pascalguttmann/obat/docs/design/esu/esu.md

# Emergency Stop Unit (ESU)

The Emergency Stop Unit (ESU) is responsible to disconnect the battery from the
power supply unit in the case that specified operating conditions are violated.
The ESU should not rely in software to disconnect the battery from the power
supply. Analog circuitry for example with a logic family like `74xx` or others
is possible.
It uses 0V to 5V inputs from the measurement transducer to evaluate when to
disconnect the battery.

## Requirements and Interface to other Components

The following picture gives an example for a schematic overview of the ESU for better
understanding. It is not part of the specification. Textual requirements are
always of precedence. The implemented architecture can be altered as required.

!!! note
    The diagram shows the usage of analog isolation. But the use of digital
    isolation might be more feasible. For that the entire comparison circuitry can
    be isolated by employing a isolated DC/DC converter and a digital isolation IC.
    This will probably be more cost effective and not impose accuracy constraints
    of the analog isolation.

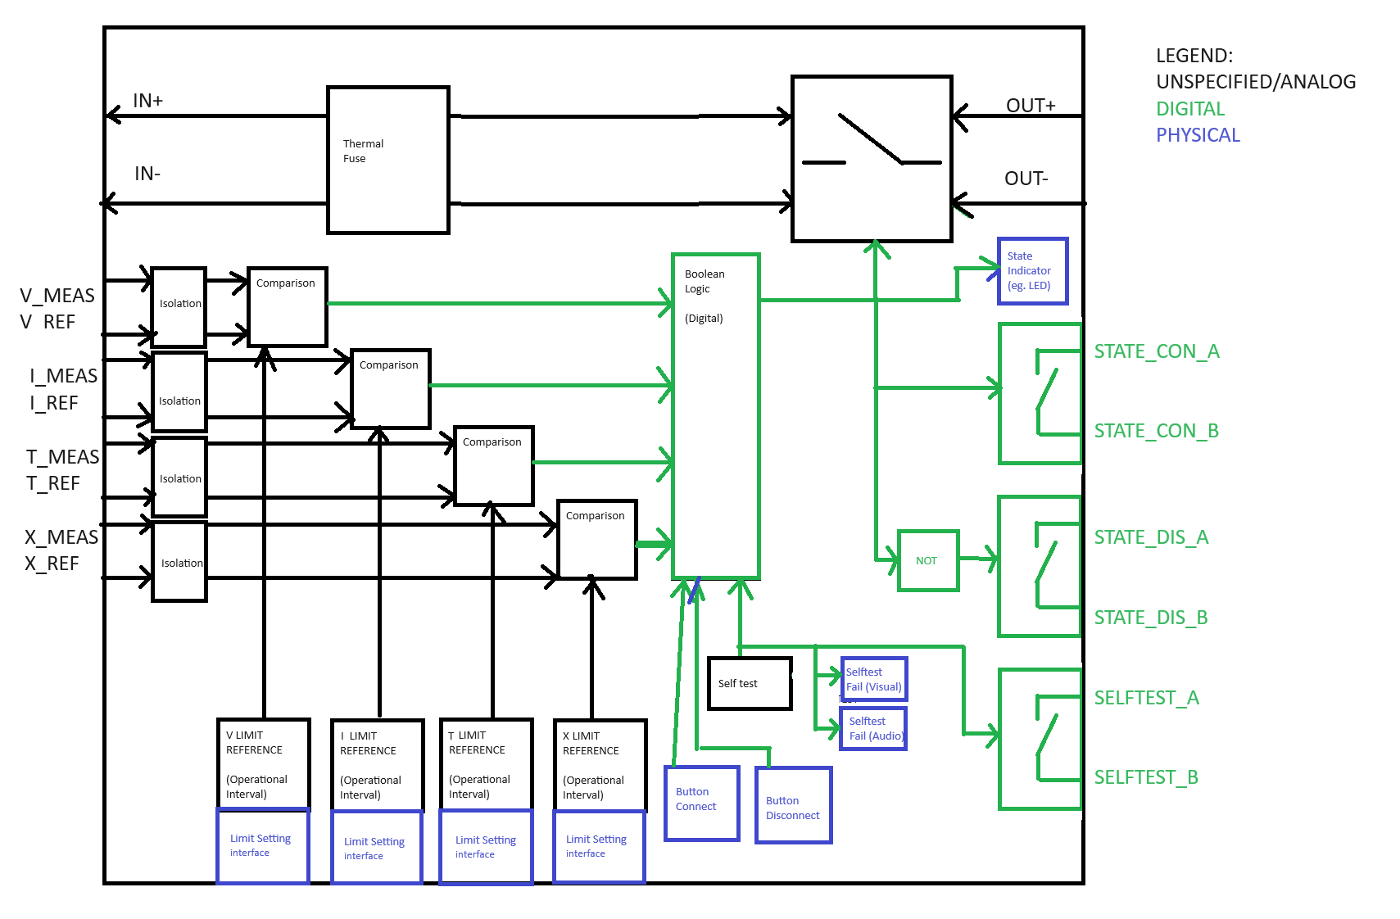
[picture p2: docs/design/esu/img/esu.png]
ESU Overview Schematic


### Interfaces

- [ ] The ESU shall have the following connection:
    - [ ] OUT+
    - [ ] OUT-
    - [ ] IN+
    - [ ] IN-
    - [ ] V_MEAS
    - [ ] V_REF
    - [ ] I_MEAS
    - [ ] I_REF
    - [ ] T_MEAS
    - [ ] T_REF
    - [ ] X_MEAS
    - [ ] X_REF
    - [ ] SELFTEST_A
    - [ ] SELFTEST_B
    - [ ] STATE_CON_A
    - [ ] STATE_CON_B
    - [ ] STATE_DIS_A
    - [ ] STATE_DIS_B
- [ ] Additionally, the ESU might have a power connection.
- [ ] The ESU shall have the following user interfaces:
    - [ ] Button `connect`
    - [ ] Button `disconnect`
    - [ ] Limit set `V_LOW`
    - [ ] Limit set `V_HIGH`
    - [ ] Limit set `I_LOW`
    - [ ] Limit set `I_HIGH`
    - [ ] Limit set `T_LOW`
    - [ ] Limit set `T_HIGH`
    - [ ] Limit set `X_LOW`
    - [ ] Limit set `X_HIGH`
    - [ ] State Indicator `connected` (for example LED)
    - [ ] Visual Indicator `FAIL_SELFTEST_VIS` (for example LED)
    - [ ] Audible Indicator `FAIL_SELFTEST_AUD` (for example Piezobuzzer)

!!! info
    The `X` connection is at the moment unused, but is included for the ability
    to extend the ESU unit in the future. Is must fulfill the same
    specifications as the `V`, `I` and `T` measurements.
    A possible use case is the initialization to perform a disconnect by
    software from the main PC in obat.

!!! info
    The connections `I_MEAS` and `I_REF` shall be used with a transducer, which
    transduces a measured current into a voltage, that is usable by the ESU.
    The ESU must integrate a transducer either on the PCB or as an external
    component.
    A transducer for the temperature measurement is provided externally.

### States

- [ ] The state of the ESU is `connected` if `IN+` is galvanic connected
    to `OUT+` and `IN-` is galvanic connected to `OUT-`.
- [ ] The state of the ESU is `disconnected`if `IN+` is galvanic
    disconnected from `OUT+` and `IN-` is galvanic disconnected from `OUT-`.
- [ ] It must be ensured by hardware (for example a relay with multiple
    contacts), that the ESU is always either in `connected` or `disconnected`
    state.
- [ ] The connections `OUT+`, `OUT-`, `IN+` and `IN-` must be isolated from all
    other terminals and electronics in ESU.
- [ ] The state after power on must be `disconnected`.
- [ ] If and only if the state is `connected`
    - [ ] the state indicator `connected` must indicate, that the state is
        `connected`.
    - [ ] the connections `STATE_CON_A` and `STATE_CON_B` must be galvanic
        connected with $Z < 1 \Omega$.
    - [ ] the connections `STATE_DIS_A` and `STATE_DIS_B` must be galvanic
        isolated with $Z > 1M \Omega$.
- [ ] If and only if the state is `disconnected`
    - [ ] the state indicator `connected` must NOT indicate, to show that the
        state is `disconnected`.
    - [ ] the connections `STATE_DIS_A` and `STATE_DIS_B` must be galvanic
        connected with $Z < 1 \Omega$.
    - [ ] the connections `STATE_CON_A` and `STATE_CON_B` must be galvanic
        isolated with $Z > 1M \Omega$.

### State Transitions

- [ ] The ESU shall transition from `disconnected` to `connected` state if and
    only if the following criteria are met:
    - physical button `connect` is pressed
    - the ESU is able to transition back to the `disconnected` state at any time
        after the `connected` state is entered. (for example The energy storage
        to switch of is charged.)
    - The selftest is passed
    - all `input voltages` of the measured quantities (voltage, current,
        temperature) are in the `operation interval`.

- [ ] The ESU shall transition from `connected` to `disconnected` state if the
    physical button `disconnect`is pressed.
- [ ] If a power fail occurs the ESU must switch to the `disconnected` state.
    (Therefore the ESU must store enough energy to transition to the
    `disconnected` state, when the main power is not available.)
- [ ] The buttons `connect` and `disconnect` must be momentary and return by
    itself to the original position if not pressed.

- [ ] The ESU must transition from `connected` to `disconnected` state if one or
    more of the following criteria are met:
    - [ ] The measured voltage is not in the `operation interval`.
    - [ ] The measured current is not in the `operation interval`.
    - [ ] The measured temperature is not in the `operation interval`.
    - [ ] The measured X voltage is not in the `operation interval`.

- [ ] The connections `*_MEAS` and `*_REF` shall form pairs, in which the
    `*_REF` connection acts as the reference for the electric potential, and
    `*_MEAS` is a voltage in the interval  [`*_MEAS`, `*_MEAS`+5V].

    !!! info
        The voltage from `*_MEAS` to `*_REF` is the `input voltage` for the
        given measured quantity (voltage, current, temperature, X at battery).

    - [ ] The pairs must be galvanic isolated from all other connections of the
        ESU. (for example by using an optocoupler). With an impedance
        $Z > 1M \Omega$.
    - [ ] The differential input impedance must be $Z_{diff} > 1M \Omega$
- [ ] The ESU shall have for each measurement input pair internally the `limits`
    - `*_LOW`
    - `*_HIGH`
- [ ] The interval [`*_LOW`, `*_HIGH`] is the `operating
    interval` for the corresponding measured quantity (voltage, current,
    temperature, X).
- [ ] The `limits` must be constant during operation.
- [ ] The `limits` shall be physically adjustable independent of each other.
    (E.g with a potentiometer).
- [ ] The transition to the `disconnect` state must be of higher precedence than
    the transition to the `connected` state. If criteria for both transitions
    are met, the transition to the `disconnected` state must be performed.
- [ ] A connection disruption must **not** trigger a transition to the
    `connected` state.
- [ ] A connection disruption must trigger a transition to the `disconnected`
    state if the connection disruption inhibits the defined transitions to the
    `disconnected` state.

### Other

- [ ] The operation of the ESU must not depend software execution.
    - [ ] Software must not be able to influence the internal `limits` or
        perform a transition to the `connected` state.
- [ ] On startup the ESU must perform a selftest. The selftest must check, that
    the ESU is able to perform the transition from `connected` to
    `disconnected` state.
- [ ] During the selftest, the state must not be changed to `connected`. (for
    example a secondary relay can be used.
- [ ] If the selftest is not passed
    - [ ] the visual indicator `FAIL_SELFTEST_VIS` shall activate
    - [ ] the audible indicator `FAIL_SELFTEST_AUD` shall activate
    - [ ] the connections `SELFTEST_A` and `SELFTEST_B` must be galvanic
        isolated with $Z > 1M \Omega$.
- [ ] If the selftest is passed
    - [ ] the visual indicator `FAIL_SELFTEST_VIS` shall deactivate
    - [ ] the audible indicator `FAIL_SELFTEST_AUD` shall deactivate
    - [ ] the connections `SELFTEST_A` and `SELFTEST_B` shall be galvanic
    - connected with $Z < 1 \Omega$.  [ ] Following connections must be galvanic
        isolated from all other connections with $Z > 1M \Omega$.
    - [ ] `SELFTEST_A` and `SELFTEST_B`
    - [ ] `STATE_CON_A` and `STATE_CON_B`
    - [ ] `STATE_DIS_A` and `STATE_DIS_B`
- [ ] The ESU must be able to break currents up to $I_{break} = 50A$.
- [ ] The ESU shall contain a thermal fuse which will break the connection
    between the two corresponding connections, if the current exceeds
    $I_{break}$ between the connections:
    - `IN+` and `OUT+`
    - `IN-` and `OUT-`

## Internals

- TTL or CMOS logic ?
- Bi- or Monostable relay? Redundancy of relay?
- Redundancy? on level of electronics? or entire ESU duplicated?
- Setting process? Process to set the desired internal limits.
- use same voltage level as other components
