pascalguttmann/obat/docs/design/pss/conf/conf.md

# Configuration

TODO: Add 100 Ohm / 470 pF at output to increase 10-90 rise time to approx
$2.2RC = 100ns$. (Clock inverter line)

TODO: Fix wrong connection in schematic and pcb for `conf_ok` (U402, switch pins 2 and 13)
The refselect_v & limits_i (and vice versa: refselect_i & limits_v) must be combined.

!!! info "Configuration Options"
    To obtain information, which DAC channels configures which feature please
    see [`./channel_map.md`](./channel_map.md).

!!! warning "AD5672R"
    To daisy chain AD5672R it is necessary to be able to transfer 24-bit data
    into the device with a *single* spi transfer. This is required to enable
    daisychain mode. Before daisychain mode is enabled only the first 24-bit of
    each transfer are used.
    This can be achieved by prepending a 24-bit shift register in front of the
    first AD5672R in the chain of consecutive AD5672R. (Setting data into the
    shift register with longer transfer, followed by a 24-bit transfer).
    For detailed technical background please refer to:
    [`./sw/pc/obat_pc_spi/device_implementation/dac/ad5672/functional_operations.py`](https://github.com/pascalguttmann/obat_pc_spi/blob/main/device_implementation/dac/ad5672/functional_operations.py)

## Interface & Requirements

1. SPI Input Interface
    - digital with $U \in [0V, 5V]$
        - `!CS`, input, chip select, low active
        - `SCLK`, input, serial clock CPHA=0, CPOL=0=`SCKL`
        - `SDI`, input, serial data in
        - `SDO`, output, serial data out
2. Voltage output
    - analog with $U \in [0V, 5V]$ with $R < 100 \Omega \forall I < 1mA$
    - analog with $U \in [0V, 5V]$ with $R < 200m \Omega \forall I < 20mA$
        - `conf_vref`, signal of configured reference voltage
        - `conf_iref`, signal of configured reference current
        - `conf_lcl`, signal of configured lower current limit
        - `conf_ucl`, signal of configured upper current limit
        - `conf_lvl`, signal of configured lower voltage limit
        - `conf_uvl`, signal of configured upper voltage limit
    - digital positive logic with $U \in [-5V, 10V]$, driving up to $I = 1 mA$
    load
        - `conf_refselect_v`, signal that the desired reference is voltage
        - `conf_refselect_i`, signal that the desired reference is current
        - `conf_ok`, signal that the configured signals are consistent
    - digital negative logic with $U \in [-5V, 10V]$, driving up to $I = 1 mA$
    load
        - `!relay_connect`, connect relay output
3. Supply Voltages
    - $+10V$ @ $100mW$ ($10mA$)
    - $-5V$ @ $50mW$ ($10mA$)
    - $+5VA$ @ $250mW$ ($40mA$)

## Circuit Selection and Design

The `conf` sub circuit is used to convert digital serial commands from the `pc`
to analog or digital signals, which are all present in parallel so they can be
accessed by the circuits of the `pss`.

### Circuit

The `conf` sub circuit utilizes a 12-bit digital to analog converter with 8
channels and SPI interface to produce the desired analog signals. The digital
signals are obtained by limiting the allowable configuration range of the
corersponding channels to the maximum and minimum value of the analog
conversion range. Those signals have a range of $U \in [0V, 5V]$ at the DAC
output, but shall be converted to $U \in [-5V, 10V]$ for compatibility with
other sub circuits. The conversion is performed by applying level shifting with
two transistors as amplifiers in emitter configuration.

#### Level Shifter

The emitter configurations of the level shifter each perform a level shift of
one of two voltage levels. The first stage shifts from $U_0 \in [0V, 5V]$ to
$U_1 \in [0V, 10V]$ and the second stage shifts from $U_1$ to $U_2 \in [-5V,
10V]$.

The collector resistances are calculated to allow an appoximate quiescant
currentflow of $I_q \approx 1mA$ during maximal voltage swing $U_{max}$.
$$ R_C = \frac{U_{max}}{I_q} $$

The base resistance is calculated with a large signal current gain of $\beta
\approx 100$, which already includes overdriving of the transistor into
saturation. The voltage is given by the preceeding stage $U_{on}$.
$$ R_B = \frac{U_{on} \beta}{I_q} $$

A pull down resistance of $R = 1 M \Omega$ is added at the input of the first
stage to define the output voltage, in case the DAC output is in tri-state.

#### Config Checker

The programmed configuration is checked for its correctness by the `conf` sub
circuit. A correct configuration is indicated by the `conf_ok` signal. The
correctness of the configuration is determined by:

- If the selected reference is voltage `conf_refselect_v`
    - The upper current limit `ucl` must be greater than the lower current
    limit `lcl`
- If the selected reference is current `conf_refselect_i`
    - The upper voltage limit `uvl` must be greater than the lower voltage
    limit `lvl`

The analog comparison is perfomed by an operational amplifier, which is used as
a comparator. No hysteresis is used, but footprints are provided to place
resistances for a additional hysteresis if required later on.

#### Relay Connect Masking

If the programmed configuration is evaluated as correct and therefore `conf_ok`
is set, the configured state of the output relay `conf_output` is forwarded to
the `relay` sub circuit. If the configuration is not correct, the `relay` sub
circuit is signaled to disconnect. The logic is implemented using a NAND gate.
$$ \text{!relay_connect} = \overline{\text{conf_ok} \land \text{conf_output}} $$

#### Visual Indication

A low power led is used at the general purpose output for debugging purposes. A
current of $I_f \approx 500 \mu A$ is set by the series resistance in order to
not exceed the pins output current specification.

### Component Selection

#### DAC

Search on Mouser for: [AD5672RBRUZ](https://mou.sr/419AKxw)

- DAC, Voltage Buffered Output
- 8 channels
- Resolution >= 2 bit
- Interface: SPI
- Package: SMD (hand solderable)
- sort by price

#### Transistors

Transistors for the level shifter are reused from the bias stage to reduce
overall number of components.

#### Opamp / Comparator

Opamp is reused from window comparator in order to reduce number of components
and replicate specification of window-comparator opamp as good as possible.

#### Logic Gates

Appropriate Logic Gates are selected from the 4000B series of CMOS logic gates.

## Simulation

Simulation example can be found in `./sim_conf.asc`.
hierarchical simulation block is available as `./conf.asc` and
`./conf.asy`.

SPI interface is not simulated. DAC is simulated as 8 voltage sources.

## Hardware tests in Laboratory

## Layout and Assembly Considerations

### PCB Layout

- Pull up/down for inputs, when stage is isolated, to run other tests.
- Test pins for
    - all DAC outputs
    - `!limits_ok_v`, `!limits_ok_i`
    - `conf_refselect_vshift`, `conf_output_vshift`
    - `conf_ok`, `!relay_connect`
- disconnector for
    - `conf_output_dac` to level shifer input
    - `conf_refselect_dac` to level shifer input

### Assembly

## Commissioning and Testing

1. Pass tests
    - Test ID: `v1.0.0/pss/conf/level-shifter/low/*`
    - Test ID: `v1.0.0/pss/conf/level-shifter/high/*`
2. Connect level-shifter with solder jumper
3. Pass tests
    - Test ID: `v1.0.0/pss/conf/dac/conf-ok`

### Level Shifter Low

Test ID: `v1.0.0/pss/conf/level-shifter/low/<suffix>`

Available suffix: `output`, `refselect`

1. Connections
    - Input of level shifer `suffix` disconnected
2. Power on supply voltage
3. Measure Voltages
    - $U_{shift}$ at net `conf_<suffix>_vshift`
5. Power off supply voltage
6. Test passed if
    - $U_{shift} < -3V$

### Level Shifter High

Test ID: `v1.0.0/pss/conf/level-shifter/high/<suffix>`

Available suffix: `output`, `refselect`

1. Connections
    - Input of level shifer `suffix` connected to $U = 5V$
2. Power on supply voltage
3. Measure Voltages
    - $U_{shift}$ at net `conf_<suffix>_vshift`
5. Power off supply voltage
6. Test passed if
    - $U_{shift} > 8V$

### DAC - Conf Ok

Test ID: `v1.0.0/pss/conf/dac/conf-ok`

1. Power on supply voltage
2. Configure DAC with
    - Channel 0: 0xFFF
    - Channel 1: 0x000
    - Channel 2: 0x800
    - Channel 3: 0x800
    - Channel 4: 0x100
    - Channel 5: 0xE00
    - Channel 6: 0xE00
    - Channel 7: 0x100
3. Measure
    - $U_{conf_ok}$
    - $U_{!relay_connect}$
4. Power off supply voltage
5. Test passed if
    - $U_{conf_ok} > 8V$
    - $U_{!relay_connect} < -3V$

### DAC - Conf Not Ok

Test ID: `v1.0.0/pss/conf/dac/conf-not-ok`

1. Power on supply voltage
2. Configure DAC with
    - Channel 0: 0xFFF
    - Channel 1: 0xFFF
    - Channel 2: 0x800
    - Channel 3: 0x800
    - Channel 4: 0x100
    - Channel 5: 0xE00
    - Channel 6: 0xE00
    - Channel 7: 0x100
3. Measure
    - $U_{conf_ok}$
    - $U_{!relay_connect}$
4. Power off supply voltage
5. Test passed if
    - $U_{conf_ok} < -3$
    - $U_{!relay_connect} > 8V$
