pascalguttmann/obat/docs/design/pss/mux/mux.md

# Multiplexer

## Interface & Requirements

1. Voltage inputs
    - analog with $U \in [0V, 5V]$ with $R < 100 \Omega \forall I < 3mA$
        - `conf_vref`, signal of configured reference voltage
        - `conf_iref`, signal of configured reference current
        - `conf_lcl`, signal of configured lower current limit
        - `conf_ucl`, signal of configured upper current limit
        - `conf_lvl`, signal of configured lower voltage limit
        - `conf_uvl`, signal of configured upper voltage limit
        - `meas_out_v`, signal of measured output voltage
        - `meas_out_i`, signal of measured output current
    - digital positive logic with $U \in [-5V, 10V]$, driving up to $I = 1 mA$
    load
        - `mode_vc`, voltage control
        - `mode_lclc`, lower current limit control
        - `mode_uclc`, upper current limit control
        - `mode_cc`, current control
        - `mode_lvlc`, lower voltage level control
        - `mode_uvlc`, upper voltage level control
2. Voltage output
    - analog with $U \in [0V, 5V]$ with $R < 350 \Omega \forall I < 3mA$
        - `mux_ref`, multiplexer reference output
        - `mux_meas`, multiplexer measurement output
3. Supply Voltages
    - $+10V$ @ $500 \mu W$ ($50 \mu A$)
    - $-5V$ @ $250 \mu W$ ($50 \mu A$)

## Circuit Selection and Design

The multiplexer is used to connect one of the given reference signals to the
reference output and one of the measured signals to the measurement output. The
selection of the required connections is performed by the digital `mode_*`
signals. Because multiple modes use the same measured signal an OR-Gate is used
to connect the measured signal for each of the modes in question.

### Circuit

The switching is performed using a analog bidirectional switch, because the
switching time is fast an reasonable low on resistance can be achieved.
Additionally the switching does not reduce the lifetime of the device as it
would be the case for a mechanical switch like a relay.
Because multiple switches could be closed at the same instance of time, if a
gapping switching behavior is desired, the selection of the modes should also
be implemented in a gapping manner. This can be used to avoid connecting
multiple low resistance sources at the multiplexers input.

### Component Selection

#### Analog Bidirectional Switch

[CD4066BM96] Selection (sort by Price): 4x SPST, SMD, 15V VCC,
$R_{on} <= 250 \Omega$

[CD4066BM96]: https://mou.sr/3MQOnJI

#### OR-Gate

Reuse of already implemented three input or gate from `mode-transition`

## Simulation

Simulation example can be found in `./sim_mux.asc`.
Hierarchical simulation block is available as `./mux.asc` and `./mux.asy`.

## Hardware tests in Laboratory

## Layout and Assembly Considerations

### PCB Layout

- Test pins for
    - each individual mode
    - each input and output

### Assembly

## Commissioning and Testing

### On - resistance

Test ID: `v1.0.0/pss/mux/on-resistance/<suffix>`

Available suffixes: `mode_vc`, `mode_lclc`, `mode_uclc`, `mode_cc`,
`mode_lvlc`, `mode_uvlc`

1. Connections
    - Input for `<suffix>` connected to $U_{in} = 10V$
2. Power on supply voltage
3. Measure Resistance
    1. $R_{ref}$ between `conf_*` of mode and `mux_ref`
    2. $R_{meas}$ between `meas_*` of mode and `mux_meas`
4. Power off supply voltage
5. Test passed if
    1. $R_{ref} < 250 \Omega$
    2. $R_{meas} < 250 \Omega$

### Off - resistance

Test ID: `v2.0.0/pss/mux/off-resistance/<suffix>`

Available suffixes: `mode_vc`, `mode_lclc`, `mode_uclc`, `mode_cc`,
`mode_lvlc`, `mode_uvlc`

1. Connections
    - Input for `<suffix>` connected to $U_{in} = -5V$
2. Power on supply voltage
3. Measure Resistance
    1. $R_{ref}$ between `conf_*` of mode and `mux_ref`
    2. $R_{meas}$ between `meas_*` of mode and `mux_meas`
4. Power off supply voltage
5. Test passed if
    1. $R_{ref} > 10k \Omega$
    2. $R_{meas} > 10k \Omega$
