pascalguttmann/obat/docs/instance_1/pss/power-electronics/power-electronics.md

# Power Electronics

## Tests

### Transfer

| Test ID | Status | Measured |
| :--- | --- | :--- |
| `v1.0.0/pss/power-electronics/transfer`| pass | $U_{1} = +2.38 V$, $U_{2} = +3.37 V$ |
