pascalguttmann/obat/docs/design/pss/limit-logic/compare-logic/window-comparator/window-comparator.md

# Window Comparator

## Interface & Requirements

1. Voltage inputs
    - analog with $U \in [0V, 5V]$ with $R < 1 \Omega \forall I < 1mA$
        - `ul` upper limit
        - `ll` lower limit
    - analog with $U \in [0V, 5V]$ with $R < 10 \Omega \forall I < 250\mu A$
        - `meas` measured quantity
2. Voltage output
    - digital positive logic with $U \in [-5V, 10V]$, driving up to $I = 1 mA$
    load
        - `ule` upper limit exceeded
        - `!lle` not lower limit exceeded
3. Supply Voltages
    - $+10V$ @ $20mW$ ($2mA$)
    - $-5V$ @ $10mW$ ($2mA$)

## Circuit Selection and Design

The window-comparator can be used to check, whether a measured signal `meas` is
inside a window defined by a lower limit `ll` and an upper limit `ul`. If the
measured signal is outside of the defined window the corresponding digital
output signals that the window limits are exceeded with the signals `lle`
(lower limit exceeded) and `ule` (upper limit exceeded).

- $\text{meas} > \text{ul} \implies \text{ule}$
- $\text{meas} < \text{ll} \implies \text{lle}$

A small offset is added to the configured limits increasing/decreasing
`ul`/`ll` to allow the use with a single limit for both the upper limit and
lower limit and still generate a well-defined window.
Therefore the window-comparator can be used to check if a two voltages are
approximately equal.

### Circuit

The offset added to the limits should generate a window approximately
$U_{window} \approx 5mV$. To add the offset voltage a voltage divider is
chosen. The usage of the depicted voltage divider will not always assure a
_symmetric_ window around the given limit signal, but will maintain a constant
width of the window. For a high limit signal close to 5V the limit signal will
get closer to the upper bound of the window, but further from the lower bound
of the window, and vice versa. In order to ease computation the calculations
are performed for a centered _symmetric_ window at $U_{ul} = U_{ll} = 2.5V$.
The addition of an offset for a single of the two limits should therefore be
$U_{offset} \approx 2.5mV$. When using the supply voltages at $U_{+} = 10V$ and
$U_{-} = -5V$ a voltage drop of $7.5V$ across the voltage divider is present.
For a quiescent current of $I_q \approx 75 \mu A$ at $7.5V$ across the voltage
divider a total resistance of
$$ R_1 + R_2 = \frac{7.5V}{75 \mu A} \approx 100k \Omega $$
is chosen. For the maximum and minimum value of the limit signal the quiescent
current will therefore be an element of $I_q \in [50 \mu A, 100 \mu A] >
I_{comp,in}$ and considerably larger than the input current of the comparator,
which can therefore be neglected. With a ratio of the resistances defined by
the desired offset the following resistances can be obtained:
$$ \frac{R_1 + R_2}{R_2} = \frac{7.5V}{2.5mV} \implies R_1 \approx 100k \Omega
\land R_2 \approx 33 \Omega $$

!!! note "Prototype Adjustment"
    Feedback from Professor Spiegelberg suggested to use a trimmer in order to
    easily change the window size without desoldering of resistors during
    prototype stage of the power supply sink. To achieve the adjustment a $R =
    1k \Omega$ trimmer is connected in series with a $R = 22 \Omega$
    resistance$.

The tolerance of the offset addition due to tolerances and the offset voltage
of the comparator should not allow for the window size to shrink below
$U_{window} < 0V$. For a tolerance of $1\%$ of the resistances the tolerance of
the tolerance of the offset voltage can be approximated:
$$ \frac{\Delta U_{offset}}{U_{voltage divider}} \approx \Delta R_1
\frac{d}{dR_1} \frac{R_2}{R_1 + R_2} + \Delta R_2 \frac{d}{dR_2} \frac{R_2}{R_1
+ R_2} $$
Using $\Delta R_i = \pm R_i \cdot 0.01 \land U_{voltage divider} = 7.5V$ the
tolerance of the offset voltage can be estimated to not exceed:
$$ |\Delta U_{offset}| \leq \left|\frac{-2 \cdot 0.01 R_1 R_2}{(R_1 + R_2)^2}
\cdot U_{voltage divider}\right| \approx 50 \mu V $$

Therefore the input offset voltage of the comparator shall not exceed
$U_{off,in} < 2.5mV - 50 \mu V$, but can be chosen smaller to increase the
accuracy of the comparator.

To add a hysteresis of $U_{hist} \big|_{U_{ll} = U_{ul} = 2.5V} \approx 1mV$.
Positive feedback can be used to create a Schmitt-trigger. This can be achieved
by selecting $R_5 + R_7 \lessapprox 1M \Omega$ to allow for a large enough
quiescent current to neglect the comparator input current. And selecting a
large $R_5$ to neglect parasitic resistances. With $\frac{R_7}{R_5} =
\frac{7.5V}{1mV}$ the following resistances can be selected:
$$ R_7 = 1M\Omega \land R_5 = 130 \Omega $$

!!! note "Schmitt-Trigger"
    Feedback from Professor Spiegelberg suggested to omit the usage of a
    Schmitt-Trigger due to the high resistance ratio and small hysteresis. The
    resistors are not populated on the PCB or connected via $0\Omega$ jumpers
    to retain the possibility of later adaptation without requiring a change of
    the PCB.

### Component Selection

#### Comparator / Opamp

[TLV9352](https://mou.sr/3BJsKZm)

- 2 or 4 channels
- SMD Mount, SOIC preferred
- rail-to-rail preferred
- $\text{SR} > 5V / \mu s$
- $V_{off} \leq 1mV$
- $I_{bias, in} \leq 1nA$ (To allow neglect of input current for high feedback resistance)
- $I_{out} \geq 20mA$
- Price sort on Mouser

#### Trimmer

[PVG5H102C03B00](https://mou.sr/4957wSw)

- $R = 1k \Omega$
- Linear Taper
- SMD Mounting
- $n_{turns} > 10$
- Sort by Price on Mouser

## Simulation

Simulation example can be found in `./sim_window-comparator.asc`.
Hierarchical simulation block is available as `./window-comparator.asc` and
`./window-comparator.asy`.

## Hardware tests in Laboratory

## Layout and Assembly Considerations

### PCB Layout

- Test pins for `ul`, `ll`, `meas`, `ule`, `lle`
- Test pins for Pins 1 and 3 of trimmers for resistance measurement

### Assembly

- Turn trimmer counter clockwise until resistance is zero for initial usage.
  (Max 11 turns required)

## Commissioning and Testing

1. Pass tests for `window-comparator`

### Upper Voltage Limit

Test ID: `v1.0.0/pss/limit-logic/window-comparator/upper-voltage-limit`

1. Connections
    - Input `meas` of the window-comparator $U=5V$
    - Input `ul` and `ll` of the window-comparator $U=0V$
2. Power on supply voltage
3. Measure Voltages
    - $V_{ule}$ at net `ule` of the window-comparator
    - $V_{!lle}$ at net `!lle` of the window-comparator
4. Power off supply voltage
5. Test passed if
    - $V_{ule} > 8V$ at net `ule` of the window-comparator
    - $V_{!lle} > 8V$ at net `!lle` of the window-comparator

### Lower Voltage Limit

Test ID: `v1.0.0/pss/limit-logic/window-comparator/lower-voltage-limit`

1. Connections
    - Input `meas` of the window-comparator $U=0V$
    - Input `ul` and `ll` of the window-comparator $U=5V$
2. Power on supply voltage
3. Measure Voltages
    - $V_{ule}$ at net `ule` of the window-comparator
    - $V_{!lle}$ at net `!lle` of the window-comparator
4. Power off supply voltage
5. Test passed if
    - $V_{ule} < -3V$ at net `ule` of the window-comparator
    - $V_{!lle} < -3V$ at net `!lle` of the window-comparator
