pascalguttmann/obat/docs/instance_1/instance_1.md

# Instance \#1

This is the documentation page for the first instance created of obat, which is
currently used by the HFU.



|   |  |
| --- | --- |
|   |  |
