pascalguttmann/obat/docs/instance_1/enclosure/dac/dac.md

# Digital-Analog-Converter

## Tests

### DAC - Conf Ok

| Test ID | Status | Measured |
| :--- | --- | :--- |
| `v1.0.0/enclosure/conf/dac/conf-ok` | pass | $U_{ch,0} = 3.996 V$, $U_{ch,1} = 3.996 V$, $U_{ch,2} = 3.997 V$, $U_{ch,3} = 3.997 V$, $U_{ch,4} = 3.996 V$, $U_{ch,5} = 3.996 V$, $U_{ch,6} = 3.995 V$, $U_{ch,7} = 3.996 V$ |
