pascalguttmann/obat/docs/instance_1/enclosure/full-bridge/full-bridge.md

# Full Bridge

## Tests 0

### Polarity Positive

| Test ID | Status | Measured |
| :--- | --- | :--- |
| `v1.0.0/enclosure/full-bridge/polarity/positive` | pass | $U_{AB} = 24.04 V$ |

### Polarity Negative

| Test ID | Status | Measured |
| :--- | --- | :--- |
| `v1.0.0/enclosure/full-bridge/polarity/negative` | pass | $U_{AB} = -24.02 V$ |

### PWM Enable

| Test ID | Status | Measured |
| :--- | --- | :--- |
| `v1.0.0/enclosure/full-bridge/pwm` | pass | $U_{A} = 18.227 V$ |

## Tests 1

### Polarity Positive

| Test ID | Status | Measured |
| :--- | --- | :--- |
| `v1.0.0/enclosure/full-bridge/polarity/positive` | pass | $U_{AB} = 24.04 V$ |

### Polarity Negative

| Test ID | Status | Measured |
| :--- | --- | :--- |
| `v1.0.0/enclosure/full-bridge/polarity/negative` | pass | $U_{AB} = -24.02 V$ |

### PWM Enable

| Test ID | Status | Measured |
| :--- | --- | :--- |
| `v1.0.0/enclosure/full-bridge/pwm` | pass | $U_{A} = 18.286 V$ |

## Tests 2

### Polarity Positive

| Test ID | Status | Measured |
| :--- | --- | :--- |
| `v1.0.0/enclosure/full-bridge/polarity/positive` | pass | $U_{AB} = 11.993 V$ |

### Polarity Negative

| Test ID | Status | Measured |
| :--- | --- | :--- |
| `v1.0.0/enclosure/full-bridge/polarity/negative` | pass | $U_{AB} = -11.996 V$ |

### PWM Enable

| Test ID | Status | Measured |
| :--- | --- | :--- |
| `v1.0.0/enclosure/full-bridge/pwm` | pass | $U_{A} = 9.194 V$ |
