pascalguttmann/obat/docs/instance_1/enclosure/power/power.md

# Power

## Tests

### Output Voltage 5V

| Test ID | Status | Measured |
| :--- | --- | :--- |
| `v1.0.0/enclosure/power/output-voltage/5V` | pass | $U_{out} = 5.023 V$ |

### Output Voltage Ripple 5V

| Test ID | Status | Measured |
| :--- | --- | :--- |
| `v1.0.0/enclosure/power/output-voltage-ripple/5V` | pass | $\Delta U_{out} <= 100 mV$ |

### Output Voltage 12V

| Test ID | Status | Measured |
| :--- | --- | :--- |
| `v1.0.0/enclosure/power/output-voltage/12V` | pass | $U_{out} = 12.015 V$ |

### Output Voltage Ripple 12V

| Test ID | Status | Measured |
| :--- | --- | :--- |
| `v1.0.0/enclosure/power/output-voltage-ripple/12V` | pass | $\Delta U_{out} <= 100 mV$ |
