pascalguttmann/obat/docs/instance_1/enclosure/pwm/pwm.md

# Pulse Width Modulator

## Tests 0

### Frequency

| Test ID | Status | Measured |
| :--- | --- | :--- |
| `v1.0.0/enclosure/pwm/frequency/0V` | pass | $f_{u,out} = 7.761 kHz$ |

### Duty Cycle

| Test ID | Status | Measured |
| :--- | --- | :--- |
| `v1.0.0/enclosure/pwm/duty-cycle/0V` | pass | $D_{u,out} = 0 $ |
| `v1.0.0/enclosure/pwm/duty-cycle/2V` | pass | $D_{u,out} = 0.377 $ |
| `v1.0.0/enclosure/pwm/duty-cycle/5V` | pass | $D_{u,out} = 1 $ |

## Tests 1

### Frequency

| Test ID | Status | Measured |
| :--- | --- | :--- |
| `v1.0.0/enclosure/pwm/frequency/0V` | pass | $f_{u,out} = 7.797 kHz$ |

### Duty Cycle

| Test ID | Status | Measured |
| :--- | --- | :--- |
| `v1.0.0/enclosure/pwm/duty-cycle/0V` | pass | $D_{u,out} = 0 $ |
| `v1.0.0/enclosure/pwm/duty-cycle/2V` | pass | $D_{u,out} = 0.377 $ |
| `v1.0.0/enclosure/pwm/duty-cycle/5V` | pass | $D_{u,out} = 1 $ |

## Tests 2

### Frequency

| Test ID | Status | Measured |
| :--- | --- | :--- |
| `v1.0.0/enclosure/pwm/frequency/0V` | pass | $f_{u,out} = 7.797 kHz$ |

### Duty Cycle

| Test ID | Status | Measured |
| :--- | --- | :--- |
| `v1.0.0/enclosure/pwm/duty-cycle/0V` | pass | $D_{u,out} = 0 $ |
| `v1.0.0/enclosure/pwm/duty-cycle/2V` | pass | $D_{u,out} = 0.379 $ |
| `v1.0.0/enclosure/pwm/duty-cycle/5V` | pass | $D_{u,out} = 1 $ |
