pascalguttmann/obat/docs/instance_1/meas/adc/adc.md

# Analog Digital Converter

## Tests ADC Index 0

### Conversion

| Test ID | Status | Measured |
| :--- | --- | :--- |
| `v1.0.0/meas/adc/conversion/0V` | pass | $U_{meas} = 0.000V$ |
| `v1.0.0/meas/adc/conversion/3V` | pass | $U_{meas} = 3.011V$ |
| `v1.0.0/meas/adc/conversion/5V` | pass | $U_{meas} = 5.005V$ |

## Tests ADC Index 1

### Conversion

| Test ID | Status | Measured |
| :--- | --- | :--- |
| `v1.0.0/meas/adc/conversion/0V` | skip | $U_{meas} = V$ |
| `v1.0.0/meas/adc/conversion/3V` | pass | $U_{meas} = 2.098V$ |
| `v1.0.0/meas/adc/conversion/5V` | skip | $U_{meas} = V$ |

## Tests ADC Index 2

### Conversion

| Test ID | Status | Measured |
| :--- | --- | :--- |
| `v1.0.0/meas/adc/conversion/0V` | pass | $U_{meas} = 0.002V$ |
| `v1.0.0/meas/adc/conversion/3V` | pass | $U_{meas} = 3.008V$ |
| `v1.0.0/meas/adc/conversion/5V` | pass | $U_{meas} = 5.008V$ |
