pascalguttmann/obat/docs/instance_1/meas/digital-interface/digital-interface.md

# Digital Interface

## Tests 0

### Isolation

Test ID: `v1.0.0/meas/digital-interface/isolation/<suffix>`

Available suffix: `GND`, `+5V`

| Test ID | Status | Measured |
| :--- | --- | :--- |
| `v1.0.0/meas/digital-interface/isolation/GND` | pass | $R_{iso} \geq 1M \Omega$ |
| `v1.0.0/meas/digital-interface/isolation/+5V` | pass | $R_{iso} \geq 1M \Omega$ |

### Low State

| Test ID | Status | Measured |
| :--- | --- | :--- |
| `v1.0.0/meas/digital-interface/low/!CS` | pass | $U_{out} = 0V$ |
| `v1.0.0/meas/digital-interface/low/SCKL` | pass | $U_{out} = 0V$ |
| `v1.0.0/meas/digital-interface/low/SDI` | pass | $U_{out} = 0V$ |
| `v1.0.0/meas/digital-interface/low/SDO` | pass | $U_{out} = 0V$ |

### High State

| Test ID | Status | Measured |
| :--- | --- | :--- |
| `v1.0.0/meas/digital-interface/high/!CS` | pass | $U_{out} = 5V$ |
| `v1.0.0/meas/digital-interface/high/SCKL` | pass | $U_{out} = 5V$ |
| `v1.0.0/meas/digital-interface/high/SDI` | pass | $U_{out} = 5V$ |

## Tests 1

### Isolation

Test ID: `v1.0.0/meas/digital-interface/isolation/<suffix>`

Available suffix: `GND`, `+5V`

| Test ID | Status | Measured |
| :--- | --- | :--- |
| `v1.0.0/meas/digital-interface/isolation/GND` | pass | $R_{iso} \geq 1M \Omega$ |
| `v1.0.0/meas/digital-interface/isolation/+5V` | pass | $R_{iso} \geq 1M \Omega$ |

### Low State

| Test ID | Status | Measured |
| :--- | --- | :--- |
| `v1.0.0/meas/digital-interface/low/!CS` | pass | $U_{out} = 0V$ |
| `v1.0.0/meas/digital-interface/low/SCKL` | pass | $U_{out} = 0V$ |
| `v1.0.0/meas/digital-interface/low/SDI` | pass | $U_{out} = 0V$ |
| `v1.0.0/meas/digital-interface/low/SDO` | pass | $U_{out} = 0V$ |

### High State

| Test ID | Status | Measured |
| :--- | --- | :--- |
| `v1.0.0/meas/digital-interface/high/!CS` | pass | $U_{out} = 5V$ |
| `v1.0.0/meas/digital-interface/high/SCKL` | pass | $U_{out} = 5V$ |
| `v1.0.0/meas/digital-interface/high/SDI` | pass | $U_{out} = 5V$ |

## Tests 2

### Isolation

Test ID: `v1.0.0/meas/digital-interface/isolation/<suffix>`

Available suffix: `GND`, `+5V`

| Test ID | Status | Measured |
| :--- | --- | :--- |
| `v1.0.0/meas/digital-interface/isolation/GND` | pass | $R_{iso} \geq 1M \Omega$ |
| `v1.0.0/meas/digital-interface/isolation/+5V` | pass | $R_{iso} \geq 1M \Omega$ |

### Low State

| Test ID | Status | Measured |
| :--- | --- | :--- |
| `v1.0.0/meas/digital-interface/low/!CS` | pass | $U_{out} = 0V$ |
| `v1.0.0/meas/digital-interface/low/SCKL` | pass | $U_{out} = 0V$ |
| `v1.0.0/meas/digital-interface/low/SDI` | pass | $U_{out} = 0V$ |
| `v1.0.0/meas/digital-interface/low/SDO` | pass | $U_{out} = 0V$ |

### High State

| Test ID | Status | Measured |
| :--- | --- | :--- |
| `v1.0.0/meas/digital-interface/high/!CS` | pass | $U_{out} = 5V$ |
| `v1.0.0/meas/digital-interface/high/SCKL` | pass | $U_{out} = 5V$ |
| `v1.0.0/meas/digital-interface/high/SDI` | pass | $U_{out} = 5V$ |

## Tests 3

### Isolation

Test ID: `v1.0.0/meas/digital-interface/isolation/<suffix>`

Available suffix: `GND`, `+5V`

| Test ID | Status | Measured |
| :--- | --- | :--- |
| `v1.0.0/meas/digital-interface/isolation/GND` | pass | $R_{iso} \geq 1M \Omega$ |
| `v1.0.0/meas/digital-interface/isolation/+5V` | pass | $R_{iso} \geq 1M \Omega$ |

### Low State

| Test ID | Status | Measured |
| :--- | --- | :--- |
| `v1.0.0/meas/digital-interface/low/!CS` | pass | $U_{out} = 0V$ |
| `v1.0.0/meas/digital-interface/low/SCKL` | pass | $U_{out} = 0V$ |
| `v1.0.0/meas/digital-interface/low/SDI` | pass | $U_{out} = 0V$ |
| `v1.0.0/meas/digital-interface/low/SDO` | pass | $U_{out} = 0V$ |

### High State

| Test ID | Status | Measured |
| :--- | --- | :--- |
| `v1.0.0/meas/digital-interface/high/!CS` | pass | $U_{out} = 5V$ |
| `v1.0.0/meas/digital-interface/high/SCKL` | pass | $U_{out} = 5V$ |
| `v1.0.0/meas/digital-interface/high/SDI` | pass | $U_{out} = 5V$ |
| `v1.0.0/meas/digital-interface/high/SDO` | pass | $U_{out} = 5V$ | `v1.0.0/meas/digital-interface/high/SDO` | pass | $U_{out} = 5V$ | `v1.0.0/meas/digital-interface/high/SDO` | pass | $U_{out} = 5V$ | `v1.0.0/meas/digital-interface/high/SDO` | pass | $U_{out} = 5V$ |
