pascalguttmann/obat/docs/instance_1/meas/i-transduce/i-transduce.md

# Current Transducer

## Tests

### Current Sensor

| Test ID | Status | Measured |
| :--- | --- | :--- |
| `v1.0.0/meas/i-transduce/-3A` | pass | $U_{meas,out} = 2.17 V$, $U_{vzcr} = 2.499 V$ |
| `v1.0.0/meas/i-transduce/-1A` | pass | $U_{meas,out} = 2.46 V$, $U_{vzcr} = 2.499 V$ |
| `v1.0.0/meas/i-transduce/0A` | pass | $U_{meas,out} = 2.46 V$, $U_{vzcr} = 2.499 V$ |
| `v1.0.0/meas/i-transduce/1A` | pass | $U_{meas,out} = 2.56 V$, $U_{vzcr} = 2.499 V$ |
| `v1.0.0/meas/i-transduce/3A` | pass | $U_{meas,out} = 2.76 V$, $U_{vzcr} = 2.499 V$ |
