pascalguttmann/obat/docs/instance_1/meas/iso-dcdc/iso-dcdc.md

# Isolated DC/DC

## Tests 0

### Isolation

Test ID: `v1.0.0/meas/iso-dcdc/isolation/<suffix>`

Available suffix: `GND`, `+5V`

| Test ID | Status | Measured |
| :--- | --- | :--- |
| `v1.0.0/meas/iso-dcdc/isolation/GND` | pass | $R_{iso} \geq 1M \Omega$ |
| `v1.0.0/meas/iso-dcdc/isolation/+5V` | pass | $R_{iso} \geq 1M \Omega$ |

### Output Voltage

Test ID: `v1.0.0/meas/iso-dcdc/output`

| Test ID | Status | Measured |
| :--- | --- | :--- |
| `v1.0.0/meas/iso-dcdc/output` | pass | $U_{out} = 4.97 V$|

## Tests 1

### Isolation

Test ID: `v1.0.0/meas/iso-dcdc/isolation/<suffix>`

Available suffix: `GND`, `+5V`

| Test ID | Status | Measured |
| :--- | --- | :--- |
| `v1.0.0/meas/iso-dcdc/isolation/GND` | pass | $R_{iso} \geq 1M \Omega$ |
| `v1.0.0/meas/iso-dcdc/isolation/+5V` | pass | $R_{iso} \geq 1M \Omega$ |

### Output Voltage

Test ID: `v1.0.0/meas/iso-dcdc/output`

| Test ID | Status | Measured |
| :--- | --- | :--- |
| `v1.0.0/meas/iso-dcdc/output` | pass | $U_{out} = 4.98 V$|

## Tests 2

### Isolation

Test ID: `v1.0.0/meas/iso-dcdc/isolation/<suffix>`

Available suffix: `GND`, `+5V`

| Test ID | Status | Measured |
| :--- | --- | :--- |
| `v1.0.0/meas/iso-dcdc/isolation/GND` | pass | $R_{iso} \geq 1M \Omega$ |
| `v1.0.0/meas/iso-dcdc/isolation/+5V` | pass | $R_{iso} \geq 1M \Omega$ |

### Output Voltage

Test ID: `v1.0.0/meas/iso-dcdc/output`

| Test ID | Status | Measured |
| :--- | --- | :--- |
| `v1.0.0/meas/iso-dcdc/output` | pass | $U_{out} = 4.98 V$|

## Tests 3

### Isolation

Test ID: `v1.0.0/meas/iso-dcdc/isolation/<suffix>`

Available suffix: `GND`, `+5V`

| Test ID | Status | Measured |
| :--- | --- | :--- |
| `v1.0.0/meas/iso-dcdc/isolation/GND` | pass | $R_{iso} \geq 1M \Omega$ |
| `v1.0.0/meas/iso-dcdc/isolation/+5V` | pass | $R_{iso} \geq 1M \Omega$ |

### Output Voltage

Test ID: `v1.0.0/meas/iso-dcdc/output`

| Test ID | Status | Measured |
| :--- | --- | :--- |
| `v1.0.0/meas/iso-dcdc/output` | pass | $U_{out} = 4.98 V$|
