pascalguttmann/obat/docs/instance_1/meas/power/power.md

# Power

## Deviation

Resistor $R1001 = 2.3 \Omega$, instead of $5.9 \Omega$ to enhance current sharing.

## Tests

### Output Voltage

| Test ID | Status | Measured |
| :--- | --- | :--- |
| `v1.0.0/meas/power/output-voltage` | pass | $U_{out} =  5.005 V$ |

### Output Voltage Ripple

| Test ID | Status | Measured |
| :--- | --- | :--- |
| `v1.0.0/meas/power/output-voltage-ripple` | pass | $\Delta U_{out} <= 100 mV$ |
