pascalguttmann/obat/docs/instance_1/pss/conf/conf.md

# Configuration

!!! warning "Wiring violation from Schematic and Layout"
    For U402 pins switch 2 and 13 are switched with enameled wire, because of a
    schematic and layout error.

## Tests

### Level Shifter Low

| Test ID | Status | Measured |
| :--- | --- | :--- |
| `v1.0.0/pss/conf/level-shifter/low/output` | pass | $U_{shift} =  -5.02V$ |
| `v1.0.0/pss/conf/level-shifter/low/refselect` | pass | $U_{shift} =  -5.02V$ |

### Level Shifter High

| Test ID | Status | Measured |
| :--- | --- | :--- |
| `v1.0.0/pss/conf/level-shifter/high/output` | pass | $U_{shift} =  11.98V$ |
| `v1.0.0/pss/conf/level-shifter/high/refselect` | pass | $U_{shift} =  11.98V$ |

### DAC - Conf Ok

| Test ID | Status | Measured |
| :--- | --- | :--- |
| `v1.0.0/pss/conf/dac/conf-ok` | pass | $U_{conf_ok} = 11.79V$, $U_{!relay_connect} = -4.89 V$ |

### DAC - Conf Not Ok

| Test ID | Status | Measured |
| :--- | --- | :--- |
| `v1.0.0/pss/conf/dac/conf-not-ok` | pass | $U_{conf_ok} = -5.02$, $U_{!relay_connect} = 12.03V$ |
