pascalguttmann/obat/docs/instance_1/pss/mux/mux.md

# Multiplexer

## Tests

### On-Resistance

| Test ID | Status | Measured |
| :--- | --- | :--- |
| `v1.0.0/pss/mux/on-resistance/mode_vc` | pass | $R_{ref} = 63 \Omega$, $R_{meas} = 70 \Omega$ |
| `v1.0.0/pss/mux/on-resistance/mode_lclc` | pass | $R_{ref} = 82 \Omega$, $R_{meas} = 67 \Omega$ |
| `v1.0.0/pss/mux/on-resistance/mode_uclc` | pass | $R_{ref} = 46 \Omega$, $R_{meas} = 67 \Omega$ |
| `v1.0.0/pss/mux/on-resistance/mode_cc` | pass | $R_{ref} = 67 \Omega$, $R_{meas} = 67 \Omega$ |
| `v1.0.0/pss/mux/on-resistance/mode_lvlc` | pass | $R_{ref} = 85 \Omega$, $R_{meas} = 70 \Omega$ |
| `v1.0.0/pss/mux/on-resistance/mode_uvlc` | pass | $R_{ref} = 50 \Omega$, $R_{meas} = 70 \Omega$ |

### Off-Resitance

| Test ID | Status | Measured |
| :--- | --- | :--- |
| `v2.0.0/pss/mux/off-resistance/mode_vc` | pass | $R_{ref} = 67k \Omega$, $R_{meas} =  \Omega$ |
| `v2.0.0/pss/mux/off-resistance/mode_lclc` | pass | $R_{ref} =  \Omega$, $R_{meas} =  \Omega$ |
| `v2.0.0/pss/mux/off-resistance/mode_uclc` | pass | $R_{ref} =  \Omega$, $R_{meas} =  \Omega$ |
| `v2.0.0/pss/mux/off-resistance/mode_cc` | pass | $R_{ref} = 58k \Omega$, $R_{meas} =  \Omega$ |
| `v2.0.0/pss/mux/off-resistance/mode_lvlc` | pass | $R_{ref} =  \Omega$, $R_{meas} =  \Omega$ |
| `v2.0.0/pss/mux/off-resistance/mode_uvlc` | pass | $R_{ref} =  \Omega$, $R_{meas} =  \Omega$ |
