pascalguttmann/obat/docs/instance_1/pss/power/power.md

# Power

## Tests

### Output Voltage

| Test ID | Status | Measured |
| :--- | --- | :--- |
| `v1.0.0/pss/power/output-voltage` | pass | $U_{out} = 5.04 V$ |

### Output Voltage Ripple

| Test ID | Status | Measured |
| :--- | --- | :--- |
| `v1.0.0/pss/power/output-voltage-ripple` | pass | $\Delta U_{out} <= 10 mV$ |
