pascalguttmann/obat/docs/instance_1/pss/relay/relay.md

# Relay

## Tests

### Switch On

| Test ID | Status | Measured |
| :--- | --- | :--- |
| `v2.0.0/pss/relay/switch/on` | pass | $R = 110m \Omega$ |

### Switch Off

| Test ID | Status | Measured |
| :--- | --- | :--- |
| `v1.0.0/pss/relay/switch/off` | pass | $R > 200 M \Omega$ |
