pascalguttmann/obat/docs/instance_1/pss/limit-logic/compare-logic/compare-logic.md

# Compare Logic

## Tests

### AND OR Select Gate

| Test ID | Status | Measured |
| :--- | --- | :--- |
| `v1.0.0/pss/limit-logic/compare-logic/an-or-select-gate/conf_refselect_v` | pass | $U_{comp,mgtt} = -5.020 V$, $U_{comp,mstt} = +12.022 V$ |
| `v1.0.0/pss/limit-logic/compare-logic/an-or-select-gate/conf_refselect_i` | pass | $U_{comp,mgtt} = +12.021 V$, $U_{comp,mstt} = -5.021  V$ |
