pascalguttmann/obat/docs/instance_1/pss/limit-logic/mode-transition/mode-transition.md

# Mode-Transition

## Tests

### State Reset

| Test ID | Status | Measured |
| :--- | --- | :--- |
| `v1.0.0/pss/limit-logic/mode-transition/state-reset` | pass | $U_{s_mode_*} = -5.01 V$, $U_{r_mode_*} = +12.02 V$, $U_{enable_ok} = -5.012 V, U_{\overline{enable_ok}} = +12.012 V$ |
