pascalguttmann/obat/docs/instance_1/pss/limit-logic/compare-logic/window-comparator/window-comparator.md

# Window-Comparator

## Tests

### window-comparator 0

#### Upper Voltage Limit

| Test ID | Status | Measured |
| :--- | --- | :--- |
| `v1.0.0/pss/limit-logic/window-comparator/upper-voltage-limit` | pass | $U_{ule} = +12.028 V$, $U_{!lle} = +12.028 V$ |

#### Lower Voltage Limit

| Test ID | Status | Measured |
| :--- | --- | :--- |
| `v1.0.0/pss/limit-logic/window-comparator/lower-voltage-limit` | pass | $U_{ule} = -5.022 V$, $U_{!lle} = -5.022 V$ |

### window-comparator 1

#### Upper Voltage Limit

| Test ID | Status | Measured |
| :--- | --- | :--- |
| `v1.0.0/pss/limit-logic/window-comparator/upper-voltage-limit` | pass | $U_{ule} = +12.029 V$, $U_{!lle} = +12.029 V$ |

#### Lower Voltage Limit

| Test ID | Status | Measured |
| :--- | --- | :--- |
| `v1.0.0/pss/limit-logic/window-comparator/lower-voltage-limit` | pass | $U_{ule} = -5.023 V$, $U_{!lle} = -5.023 V$ |

### window-comparator 2

#### Upper Voltage Limit

| Test ID | Status | Measured |
| :--- | --- | :--- |
| `v1.0.0/pss/limit-logic/window-comparator/upper-voltage-limit` | pass | $U_{ule} = +12.029  V$, $U_{!lle} = +12.029 V$ |

#### Lower Voltage Limit

| Test ID | Status | Measured |
| :--- | --- | :--- |
| `v1.0.0/pss/limit-logic/window-comparator/lower-voltage-limit` | pass | $U_{ule} = -5.023 V$, $U_{!lle} = -5.023 V$ |

### window-comparator 3

#### Upper Voltage Limit

| Test ID | Status | Measured |
| :--- | --- | :--- |
| `v1.0.0/pss/limit-logic/window-comparator/upper-voltage-limit` | pass | $U_{ule} = +12.028 V$, $U_{!lle} = +12.028 V$ |

#### Lower Voltage Limit

| Test ID | Status | Measured |
| :--- | --- | :--- |
| `v1.0.0/pss/limit-logic/window-comparator/lower-voltage-limit` | pass | $U_{ule} = -5.022 V$, $U_{!lle} = -5.022 V$ |
