pascalguttmann/obat/docs/design/pss/power-consumption.xlsx

Sub Circuit Current [A] | -5V | +5V | +10V | # Circuits | -5V | +5V | +10V
ADC | 0 | 0.01 | 0 | 2.00 | 0 | 0.02 | 0
Conf | 0.01 | 0.04 | 0.01 | 1.00 | 0.01 | 0.04 | 0.01
Digital Interface | 0 | 0.04 | 0 | 1.00 | 0 | 0.04 | 0
Limit Logic | 0.025 | 0 | 0.025 | 1.00 | 0.025 | 0 | 0.025
Measurement | 0.03 | 0 | 0.03 | 1.00 | 0.03 | 0 | 0.03
Multiplexer | 5e-05 | 0 | 5e-05 | 1.00 | 5e-05 | 0 | 5e-05
Power Electronics | 25.7 | 0 | 25.7 | 1.00 | 25.7 | 0 | 25.7
Relay | 0.12 | 0 | 0.12 | 1.00 | 0.12 | 0 | 0.12
Power | 0 | -0.1 | 0.1 | 1.00 | 0 | -0.1 | 0.1
 |  |  |  | 10.00 | 25.89 | 0.00 | 25.99
