pascalguttmann/obat/docs/design/pss/limit-logic/mode-transition/truth-table-mode-set-reset.xlsx

REF | LVLE | UVLE | LCLE | UCLE | MSTT | MGTT | VC | LCLC | UCLC | CC | LVLC | UVLC | Excl. By Design
U | x | x | 0 | 0 | 0 | 0 | S |  |  | R | R | R
U | x | x | 0 | 0 | 0 | 1 | S |  | R | R | R | R
U | x | x | 0 | 0 | 1 | 0 | S | R |  | R | R | R
U | x | x | 0 | 0 | 1 | 1 | S | R | R | R | R | R | x
U | x | x | 0 | 1 | x | x | R | R | S | R | R | R
U | x | x | 1 | 0 | x | x | R | S | R | R | R | R
U | x | x | 1 | 1 | x | x | R | S/R | S/R | R | R | R | x
I | 0 | 0 | x | x | 0 | 0 | R | R | R | S
I | 0 | 0 | x | x | 0 | 1 | R | R | R | S |  | R
I | 0 | 0 | x | x | 1 | 0 | R | R | R | S | R
I | 0 | 0 | x | x | 1 | 1 | R | R | R | S | R | R | x
I | 0 | 1 | x | x | x | x | R | R | R | R | R | S
I | 1 | 0 | x | x | x | x | R | R | R | R | S | R
I | 1 | 1 | x | x | x | x | R | R | R | R | S/R | S/R | x
UI | x | x | x | x | x | x | R | R | R | R | R | R | x
- | x | x | x | x | x | x | R | R | R | R | R | R | x
