pascalguttmann/obat/docs/design/pss/kicad_dru_netclass.png

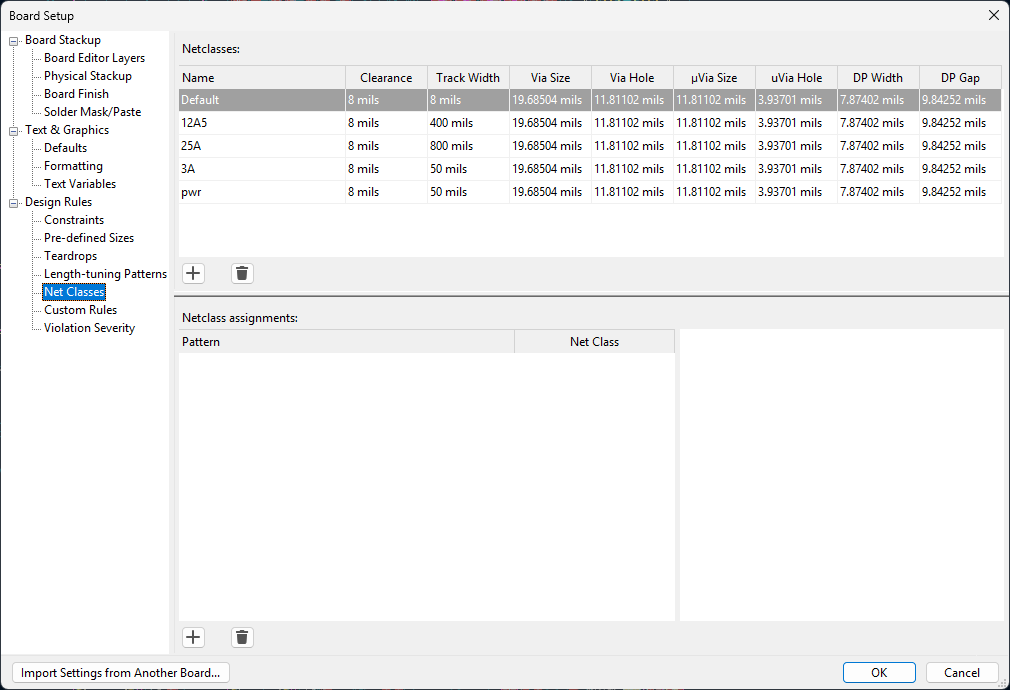
docs/design/pss/kicad_dru_netclass.png
