pascalguttmann/obat/docs/design/pss/kicad_dru_predefined.png

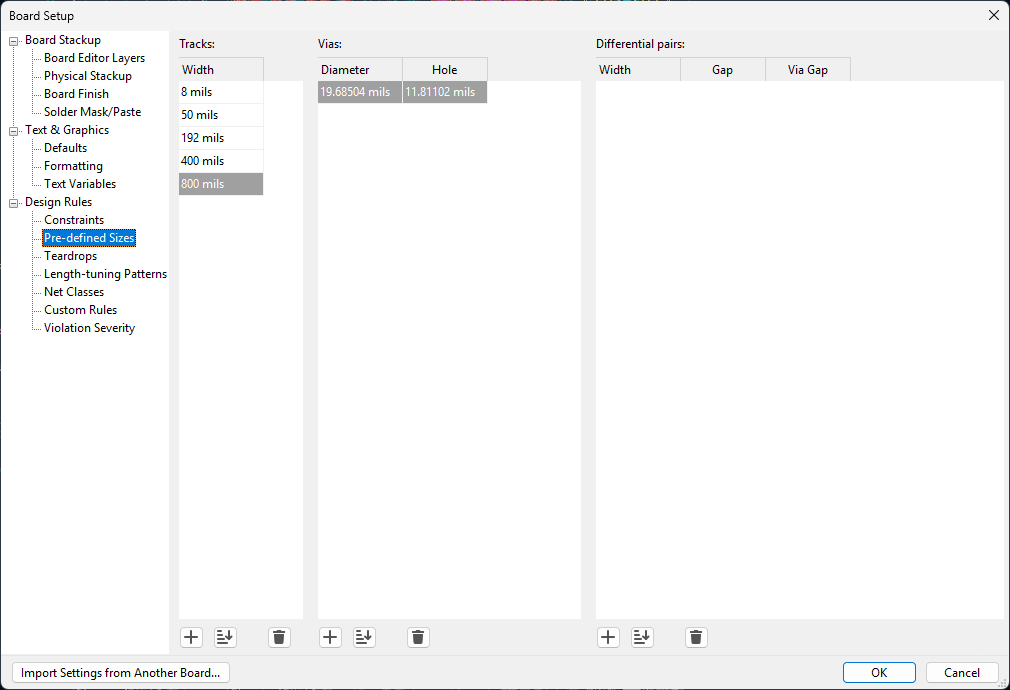
docs/design/pss/kicad_dru_predefined.png
