pascalguttmann/obat/docs/design/pss/kicad_dru_rules.png

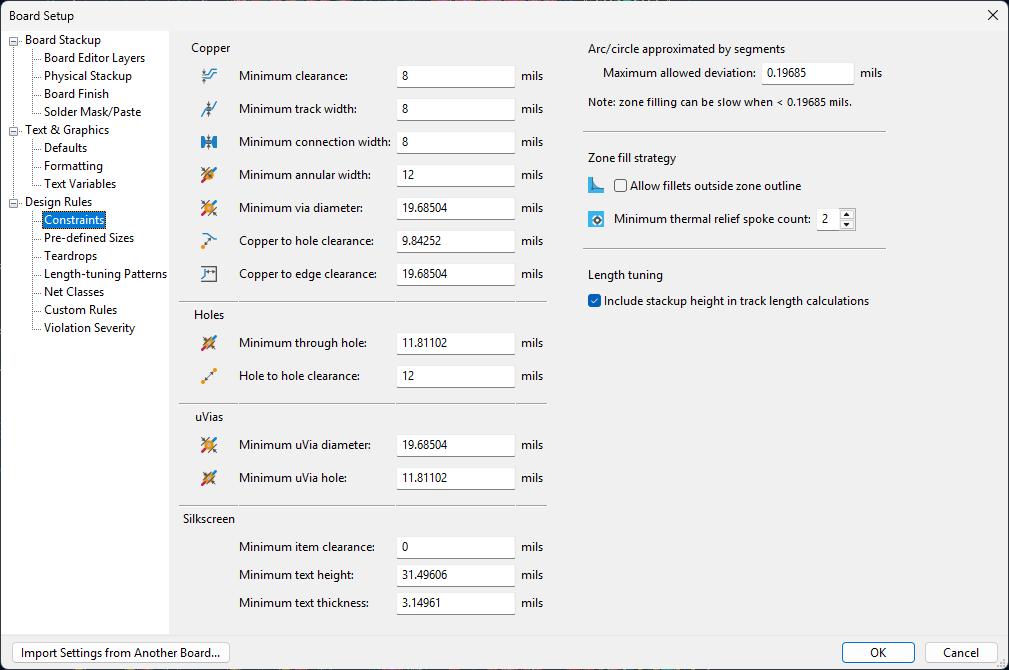
docs/design/pss/kicad_dru_rules.png
