pascalguttmann/obat/docs/parts/parts.md

# Standard Parts

This site gives a short overview of parts that have been selected and share
potential for reuse in other circuits.

- [AD8531/AD8532/AD8534][AD8531]
  Opamp, Rail-to-Rail, No-Phase-Reversal, Single suppy, high output current

!!! info
    Observe maximum ratings, especially the rated power and output current.
    Output is not shortcircuit protected.

- [IL300][IL300]
  Linear Optocoupler
  check if appropriate for usage of galvanic isolation

- [AMC1100][AMC1100]
  Differential Isolation Amplifier
  check if appropriate for usage of galvanic isolation

Tutorial from Analog Devices for [Analog Isolation Techniques]
[tutorial_isolation]. Should be evaluated for decision on galvanic isolation
parts.

[AD8531]: https://www.analog.com/media/en/technical-documentation/data-sheets/ad8531_8532_8534.pdf
[IL300]: https://www.mouser.com/datasheet/2/427/il300-67299.pdf
[AMC1100]: https://www.ti.com/lit/ds/symlink/amc1100.pdf?ts=1708934315934
[tutorial_isolation]: https://www.analog.com/media/en/training-seminars/tutorials/mt-071.pdf
