pascalguttmann/obat/docs/design/enclosure/mechanical/Stückliste.xlsx

Stückliste |  |  | Schrauben |  |  | Muttern
Name | Anzahl | Material | Norm | Bezeichnung | Anzahl | Norm | Bezeichnung | Anzahl
001_Battery_Aufnahme | 1 | Alu | DIN EN ISO 4762 | M6x20 | 12 | DIN EN 24 032 | M6 | 4
002_Huelse | 2 | PE | DIN EN ISO 4762 | M6x16 | 1
003_Anschlagplatte | 1 | Alu | DIN EN ISO 4762 | M4x8 | 2
004_Feststellplatte | 1 | Alu | DIN EN ISO 4762 | M6x25 | 4
005_Anschlagklotz | 1 | PE | DIN EN ISO 4762 | M6x40 | 4
006_Huelse | 1 | PE | DIN EN ISO 4762 | M6x12 | 4
007_Stuetze | 1 | Alu | DIN EN ISO 4762 | M3x6 | 4
008_Grundplatte | 1 | PE | DIN EN ISO 4762 | M4x20 | 2
009_Seitenplatte_links | 1 | PE | DIN EN ISO 4762 | M6x30 | 4
010_Frontplatte | 1 | PE | DIN EN ISO 10 642 | M4x10 | 8
011_Platte_hinten | 1 | PE |  |  | 45
012_Seitenplatte_rechts | 1 | PE
013_Deckel | 1 | PE
014_Halteblech | 2 | Alu
015_Klemmelement | 1 | Alu
016_Klappe | 1 | PE
017_Verbindungsstueck | 1 | PE
