pascalguttmann/obat/docs/design/enclosure/mechanical/Zukaufteile.xlsx

Innovationslabor Open Battery test
Zukaufteile:
Nummer | Teilname | Stück | Verkäufer | Preis | Lieferzeit | Link
1 | Heizelement | 1 | RS | 21.62 € | 1 Tag | https://de.rs-online.com/web/p/heizelemente/2995900
2 | Peltier-Element | 1 | Amazon | 17.38 € | 2-3 Wochen | https://www.amazon.de/sourcingmap%C2%AE-TEC1-19906-Thermoelektrisch-K%C3%BChlmodule-K%C3%BChlplatte/dp/B01KACT418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
3 | Kühlkörper | 1 | quickcool | 45.98 € | 1-3 Tage | https://quickcool-shop.de/416/Kuehlkoerper-mit-Luefter-Alu-Kuehlkoerper-f%C3%BCr-Peltierelemente
4 | Thermoelement | 2 | RS | 9.87 € | 1 Tag | https://de.rs-online.com/web/p/thermoelemente/6212170
5 | Schrauben M8x35 | 1 | Highperformancepolymer | 9.83 € | 1 Tag | https://highperformancepolymer.de/products/pvc-hex-socket-cylinder-head-cap-screw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
6 | Messumformer | 1 | LKM | 46.00 € | 1 Woche | https://lkmelectronic.de/LKMShop/de/lkm102.html
7 | Wärmeleitpaste | 1 | Amazon | 4.91 € | 3 Tage | https://www.amazon.de/mx-4-W%C3%A4rmeleitpaste-W%C3%A4rmeleitpaste-Thermische-Schnittstelle-Material-4-Gramm/dp/B0795DP124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
8 | Relais | 2 | Digikey | 6.58 € | 3 Tage | https://www.digikey.de/de/products/detail/panasonic-electric-works/CB1AH-R-12V/2804735
9 | Endschalter | 1 | Voelkner | 34.99 € | 1-2 Tage | https://www.voelkner.de/products/945828/Panasonic-MEP1G31Z-MEP1G31Z-Endschalter-24V-5A-Rollenhebel-IP67-1St..html
10 | Scharnier | 3 | Ganter | 3.01 € | Sofort Lieferbar | https://www.ganternorm.com/de/produkte/3.3-Schwenken-Verriegeln-von-Tueren-und-Klappen/Scharniere/GN-237.1-Scharniere-Kunststoff
11 | Spannversschluss | 1 | Ganter | 1.48 € | Sofort Lieferbar | https://www.ganternorm.com/de/produkte/2.4-Spannen-mit-Spannmechanik/Spannverschluesse/GN-832.4-Spannverschluesse-Stahl-Edelstahl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..
12 | Kunststoffplatten | 1 | Amazon | 31 € |  | https://www.amazon.de/Platte-schwarz-Zuschnitt-PE-alt-intech%C2%AE/dp/B00HKM1D3O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
13 | Kunststoff Rundstab | 1 | Amazon | 11 € |  | https://www.amazon.de/Rundstab-PE-HD-schwarz-Kunststoffrundstab-alt-intech%C2%AE/dp/B00GKPK0XG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
14 | Faston-Anschluss 6,3x0,8 | 1 | Amazon | 6,49€ | 2-3 Tage | https://www.amazon.de/-/en/FDD5-5-250-MDD5-5-250/dp/B07BRVKRKL
15 | Faston-Anschluss 9,5x1,2 | 4 | reichelt | 0,23€ | 1-2 Tage | https://www.reichelt.de/flachsteckhuelsen-9-5-x-1-2-4-6-mm-teilisoliert-gelb-we-f603951d-p274388.html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
16 | Dichtschur | 1 | RS-Pro | 29.38 | Vorhanden in WS | https://de.rs-online.com/web/p/o-ring-schnure/2323010
17 | Gummikabel | 1 | Amazon | 47.2 | 1-2 Tage | https://www.amazon.de/H07RN-F-5x4mm%C2%B2-Gummikabel-Meterware-Meter/dp/B0BSCGYBDZ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
18 | Buchse | 2 | RS-Pro | 8.88 | 1 Tag | https://de.rs-online.com/web/p/industrie-automation-steckverbinder/1316369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
19 | Stecker | 2 | RS-Pro | 8.88 | 1 Tag | https://de.rs-online.com/web/p/industrie-automation-steckverbinder/1316389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
