pascalguttmann/obat/docs/design/pss/power-electronics/outstage/power_transistor.xlsx

 |  |  |  |  |  |  | R_CA [K/W] | 2.4 |  | R_Iso [K/W] | 0.4 | WS 220 | WS 4 220
 |  |  |  |  |  |  | T_J safety [K] | 30.0 |  | R_HA [K/W] | 2 | SK662 200 | SK593 200
 |  |  |  |  |  |  | T_amb [C] | 25.0
Name | Datasheet | Price p.P. [€] | # required NPN & PNP | Total Price [€] | Package | TJ_max [C] | P_tot [W] | Power [W] @ R_CA @T_junction = T_max - T_J safety @T_amb | IC_max [A] | IC_usable [A] | beta_0 | VBE_on [V] | I_B total [A] | Note | Copy for Markdown
MJE3055T, MJE2955T | https://www.mouser.de/datasheet/2/308/1/MJE2955T_D-2315820.pdf | 0.69 | 22 | 15.18 | TO-220 | 150 | 75 | 23.4 | 10 | 4 | 20 | 1.8 | 1.000 | Complementary part is approx 1€ | | [MJE3055T, MJE2955T](https://www.mouser.de/datasheet/2/308/1/MJE2955T_D-2315820.pdf) |TO-220|150|75|23.3606557377049|10|4|20|1|1.8|22|0.69|15.18
BD433/5/7, BD434/6/8 | https://www.mouser.de/datasheet/2/389/bd437-1848935.pdf | 0.502 | 32 | 16.064 | SOT-32 | 150 | 36 | 16.2 | 4 | 2 | 40 | 1.2 | 0.500 | SOT-32 for heatsink, # higher | | [BD433/5/7, BD434/6/8](https://www.mouser.de/datasheet/2/389/bd437-1848935.pdf) |SOT-32|150|36|16.1778618732261|4|2|40|0.5|1.2|32|0.502|16.064
TIP41C, TIP42C | https://www.mouser.de/datasheet/2/389/tip41c-1852274.pdf | 0.72 | 24 | 17.28 | TO-220 | 150 | 65 | 22.0 | 6 | 4 | 30 | 2 | 0.667 | TO-220, cheapish, cost scales with R_CA reduction | | [TIP41C, TIP42C](https://www.mouser.de/datasheet/2/389/tip41c-1852274.pdf) |TO-220|150|65|21.9750889679715|6|4|30|0.666666666666667|2|24|0.72|17.28
2N5191G, 2N5194 | https://www.mouser.de/datasheet/2/308/2N5191_D-2309067.pdf | 0.577 | 30 | 17.31 | TO-225 | 150 | 40 | 17.2 | 4 | 2 | 20 | 1.2 | 1.000 |  | | [2N5191G, 2N5194](https://www.mouser.de/datasheet/2/308/2N5191_D-2309067.pdf) |TO-225|150|40|17.1945701357466|4|2|20|1|1.2|30|0.577|17.31
D44VH10, D45VH10 | https://www.mouser.de/datasheet/2/308/1/D44VH_D-2310858.pdf | 0.83 | 22 | 18.26 | TO-220 | 150 | 83 | 24.3 | 15 | 4 | 20 | 1.2 | 1.000 |  | | [D44VH10, D45VH10](https://www.mouser.de/datasheet/2/308/1/D44VH_D-2310858.pdf) |TO-220|150|83|24.3214065391733|15|4|20|1|1.2|22|0.83|18.26
D44H8, D45H8 | https://www.mouser.de/datasheet/2/389/d44h8-1848919.pdf | 0.772 | 26 | 20.072 | TO-220 | 150 | 50 | 19.4 | 10 | 4 | 40 | 1.5 | 0.500 |  | | [D44H8, D45H8](https://www.mouser.de/datasheet/2/389/d44h8-1848919.pdf) |TO-220|150|50|19.3877551020408|10|4|40|0.5|1.5|26|0.772|20.072
TIP35CW, TIP36CW | https://www.mouser.de/datasheet/2/389/tip35cw-1852306.pdf | 1.87 | 18 | 33.66 | TO-247 | 150 | 125 | 27.9 | 25 | 3 | 30 | 2 | 0.667 |  | | [TIP35CW, TIP36CW](https://www.mouser.de/datasheet/2/389/tip35cw-1852306.pdf) |TO-247|150|125|27.9411764705882|25|3|30|0.666666666666667|2|18|1.87|33.66
NJW3281G, NJW1302G | https://www.mouser.de/datasheet/2/308/1/NJW3281_D-2318020.pdf | 3.65 | 16 | 58.4 | TO-3P | 150 | 200 | 31.4 | 15 | 8 | 45 | 1.5 | 0.444 |  | | [NJW3281G, NJW1302G](https://www.mouser.de/datasheet/2/308/1/NJW3281_D-2318020.pdf) |TO-3P|150|200|31.404958677686|15|8|45|0.444444444444444|1.5|16|3.65|58.4
MJW21196, MJW21195 | https://www.mouser.de/datasheet/2/308/1/MJW21195_D-2315975.pdf | 4.11 | 16 | 65.76 | TO-247 | 150 | 200 | 31.4 | 16 | 8 | 20 | 2 | 1.000 |  | | [MJW21196, MJW21195](https://www.mouser.de/datasheet/2/308/1/MJW21195_D-2315975.pdf) |TO-247|150|200|31.404958677686|16|8|20|1|2|16|4.11|65.76
MJ15022, MJ15023 | https://www.mouser.de/datasheet/2/308/1/MJ15022_D-2316114.pdf | 6.29 | 12 | 75.48 | TO-3 | 200 | 250 | 46.8 | 16 | 10 | 15 | 2.2 | 1.333 |  | | [MJ15022, MJ15023](https://www.mouser.de/datasheet/2/308/1/MJ15022_D-2316114.pdf) |TO-3|200|250|46.7741935483871|16|10|15|1.33333333333333|2.2|12|6.29|75.48
MJW21194, MJW21193 | https://www.mouser.de/datasheet/2/308/1/MJW21193_D-2315789.pdf | 4.81 | 16 | 76.96 | TO-247 | 150 | 200 | 31.4 | 16 | 8 | 20 | 2.2 | 1.000 |  | | [MJW21194, MJW21193](https://www.mouser.de/datasheet/2/308/1/MJW21193_D-2315789.pdf) |TO-247|150|200|31.404958677686|16|8|20|1|2.2|16|4.81|76.96
MJL21196, MJL21195 | https://www.mouser.de/datasheet/2/308/1/MJL21195_D-2316291.pdf | 4.9 | 16 | 78.4 | TO-264 | 150 | 200 | 31.4 | 16 | 8 | 25 | 2.2 | 0.800 |  | | [MJL21196, MJL21195](https://www.mouser.de/datasheet/2/308/1/MJL21195_D-2316291.pdf) |TO-264|150|200|31.404958677686|16|8|25|0.8|2.2|16|4.9|78.4
MJ802, MJ4502G | https://www.mouser.de/datasheet/2/308/1/MJ4502_D-2316036.pdf | 7.43 | 12 | 89.16 | TO-3 | 200 | 200 | 44.3 | 30 | 7.5 | 25 | 1.3 | 0.800 |  | | [MJ802, MJ4502G](https://www.mouser.de/datasheet/2/308/1/MJ4502_D-2316036.pdf) |TO-3|200|200|44.2748091603053|30|7.5|25|0.8|1.3|12|7.43|89.16
MJL4281AG, MJL4302AG | https://www.mouser.de/datasheet/2/308/1/MJL4281A_D-2315934.pdf | 5.59 | 16 | 89.44 | TO-264 | 150 | 230 | 32.3 | 15 | 8 | 50 | 1.5 | 0.400 |  | | [MJL4281AG, MJL4302AG](https://www.mouser.de/datasheet/2/308/1/MJL4281A_D-2315934.pdf) |TO-264|150|230|32.274741506647|15|8|50|0.4|1.5|16|5.59|89.44
