pascalguttmann/obat/docs/design/enclosure/mechanical/mcad_ptc-creo/Toggle latch GN 832.4-55-ST (closed).stp

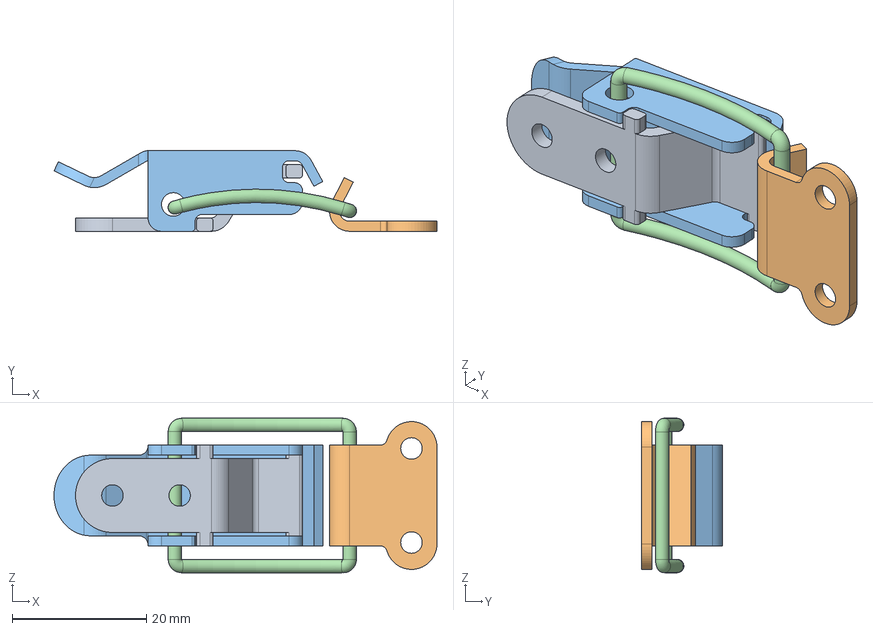
[picture p26: CAD file, 2024-07-05]
docs/design/enclosure/mechanical/mcad_ptc-creo/Toggle latch GN 832.4-55-ST (closed).stp
57.0 x 12.0 x 23.0 mm
Basic component GN 832.4-55-ST-G
Clamp GN 832.4-55-ST-G
Holder GN 832.4-55-ST-G
Pulling latch GN 832.4-55-ST-G
