pascalguttmann/obat/docs/design/enclosure/mechanical/mcad_ptc-creo/din_en_iso_4762_m8x35.stp

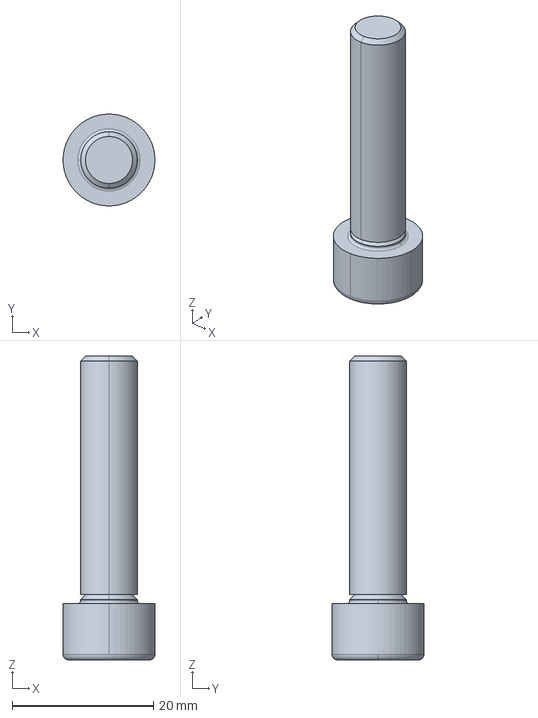
[picture p27: CAD file, 2024-07-05]
docs/design/enclosure/mechanical/mcad_ptc-creo/din_en_iso_4762_m8x35.stp
13.0 x 13.0 x 43.0 mm
