pascalguttmann/obat/docs/design/enclosure/mechanical/mcad_ptc-creo/Hinge GN 237.1-30-30-A (0).stp

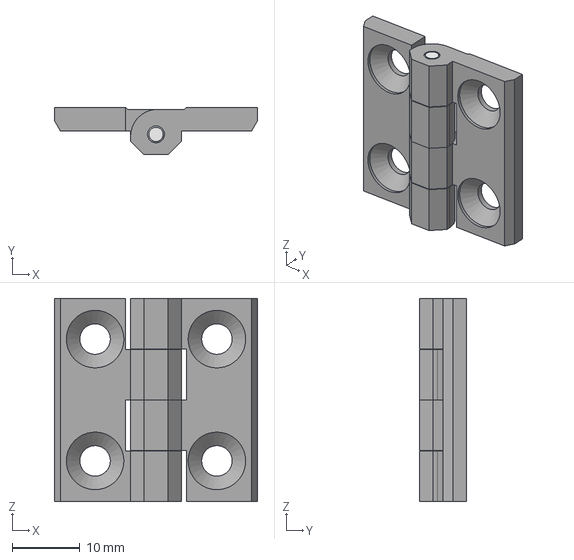
[picture p28: CAD file, 2024-07-05]
docs/design/enclosure/mechanical/mcad_ptc-creo/Hinge GN 237.1-30-30-A (0).stp
30.0 x 7.00 x 30.0 mm
Hinge GN 237.1-30-30-A_1
Hinge GN 237.1-30-30-A_4
