pascalguttmann/obat/docs/design/enclosure/mechanical/mcad_ptc-creo/07210-08.stp

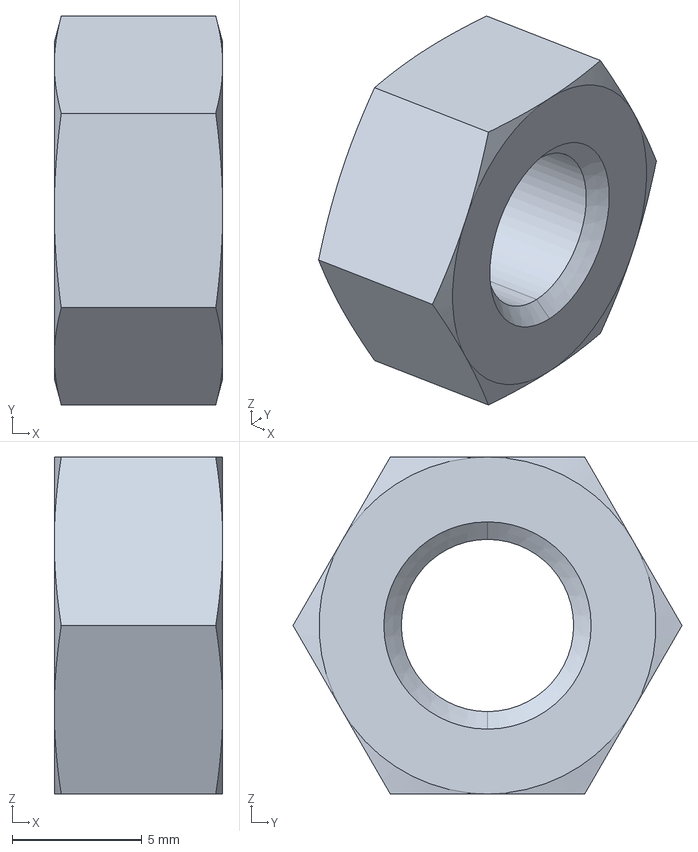
[picture p29: CAD file, 2024-07-05]
docs/design/enclosure/mechanical/mcad_ptc-creo/07210-08.stp
6.50 x 15.0 x 13.0 mm
