pascalguttmann/obat/docs/design/pss/kicad_dru_soldermask.png

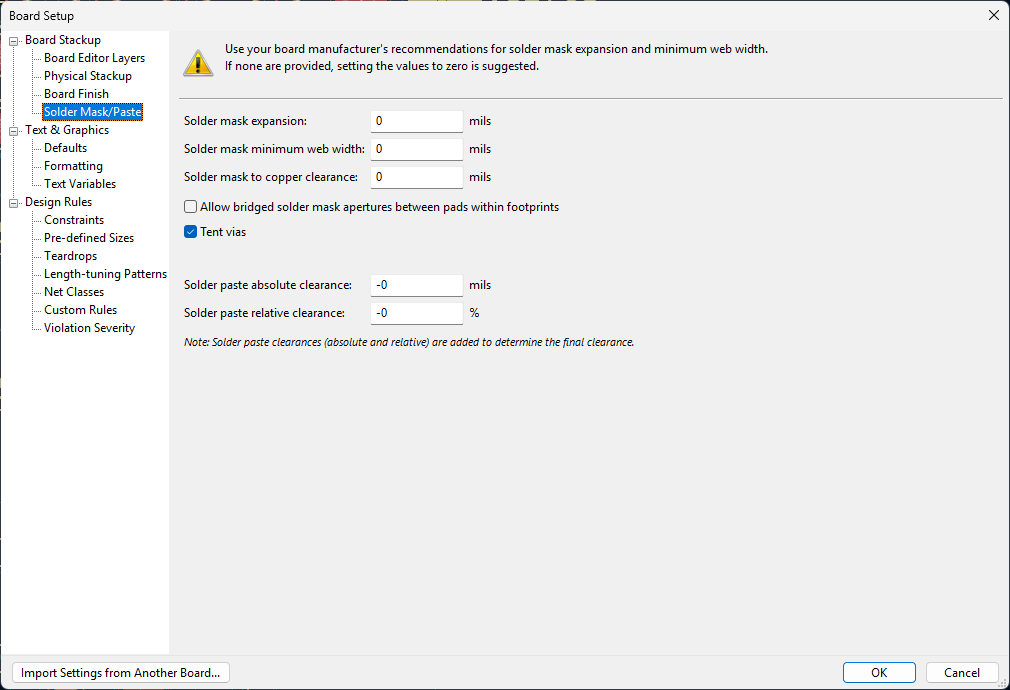
docs/design/pss/kicad_dru_soldermask.png
