pascalguttmann/obat/docs/instance_1/accurracy_measurement.xlsx

Sheet: temporal
Sample No | Period [ms] | Configured Period [ms] |  | Abs | Norm | n=50
1 | 101.4 | 100 | STDDev | 0.04749736835 | 0.0004749736835
2 | 101.4 | 100 | Mean | 101.412 | 1.01412
3 | 101.4 | 100
4 | 101.4 | 100
5 | 101.4 | 100
6 | 101.4 | 100
7 | 101.4 | 100
8 | 101.4 | 100
9 | 101.4 | 100
10 | 101.4 | 100
11 | 101.4 | 100
12 | 101.4 | 100
13 | 101.4 | 100
14 | 101.4 | 100
15 | 101.4 | 100
16 | 101.6 | 100
17 | 101.4 | 100
18 | 101.4 | 100
19 | 101.4 | 100
20 | 101.4 | 100
21 | 101.4 | 100
22 | 101.4 | 100
23 | 101.4 | 100
24 | 101.4 | 100
25 | 101.4 | 100
26 | 101.4 | 100
27 | 101.4 | 100
28 | 101.4 | 100
29 | 101.4 | 100
30 | 101.6 | 100
31 | 101.4 | 100
32 | 101.4 | 100
33 | 101.4 | 100
34 | 101.4 | 100
35 | 101.4 | 100
36 | 101.4 | 100
37 | 101.4 | 100
38 | 101.4 | 100
39 | 101.4 | 100
40 | 101.4 | 100
41 | 101.4 | 100
42 | 101.4 | 100
43 | 101.4 | 100
44 | 101.4 | 100
45 | 101.4 | 100
46 | 101.4 | 100
47 | 101.4 | 100
48 | 101.6 | 100
49 | 101.4 | 100
50 | 101.4 | 100
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
