pascalguttmann/obat/docs/design/enclosure/mechanical/Battery_zeichnung_aktuell.pdf

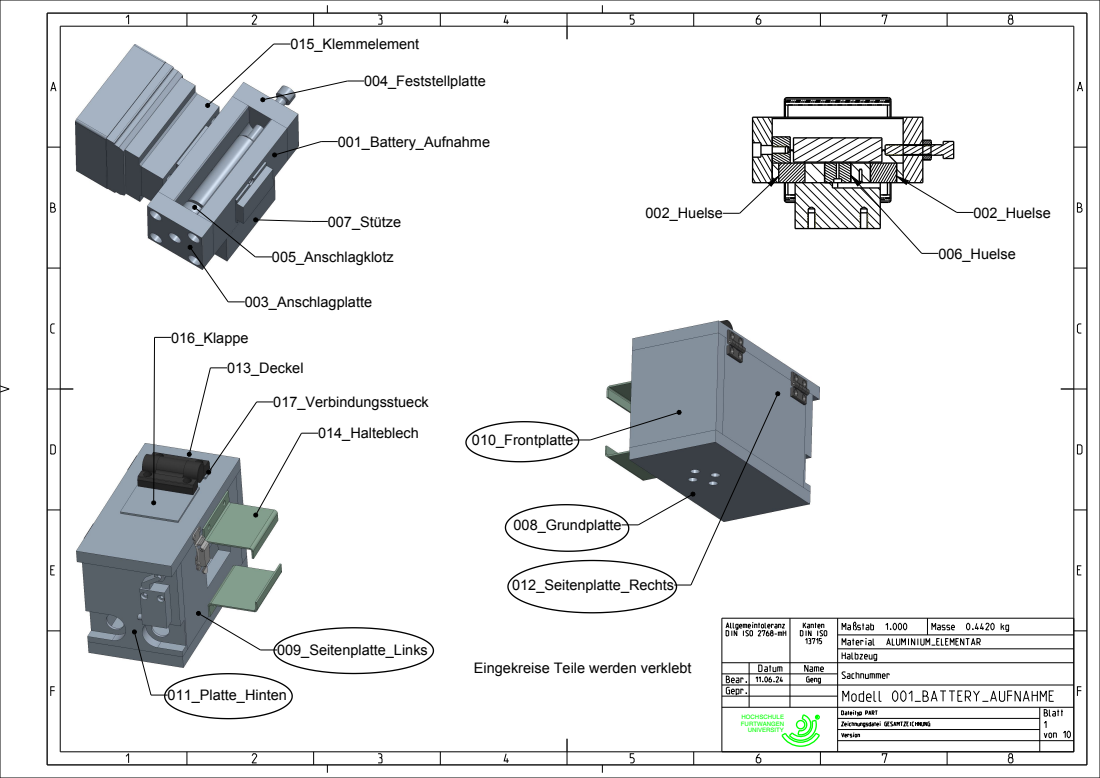
[picture p31: page 1]
HOCHSCHULE FURTWANGEN UNIVERSITY; Kanten; Halbzeug; Dateityp PART; Blatt; Zeichnungsdatei GESAMTZEICHNUNG; Version; von 10; 003_Anschlagplatte; 004_Feststellplatte; 005_Anschlagklotz; 007_Stütze; 001_Battery_Aufnahme; 015_Klemmelement; 002_Huelse; 006_Huelse; 009_Seitenplatte_Links; 011_Platte_Hinten; 013_Deckel; 014_Halteblech; 016_Klappe; 017_Verbindungsstueck; 008_Grundplatte; 010_Frontplatte; 012_Seitenplatte_Rechts

Allgemeintoleranz
DIN ISO 2768-mH

DIN ISO | 13715 | Maßstab 1.000 | Masse 0.4420 kg
Material ALUMINIUM_ELEMENTAR

Eingekreise Teile werden verklebt

Datum | | Name
Geng | Sachnummer Bear. 11.06.24
Gepr. | | Modell 001_BATTERY_AUFNAHME

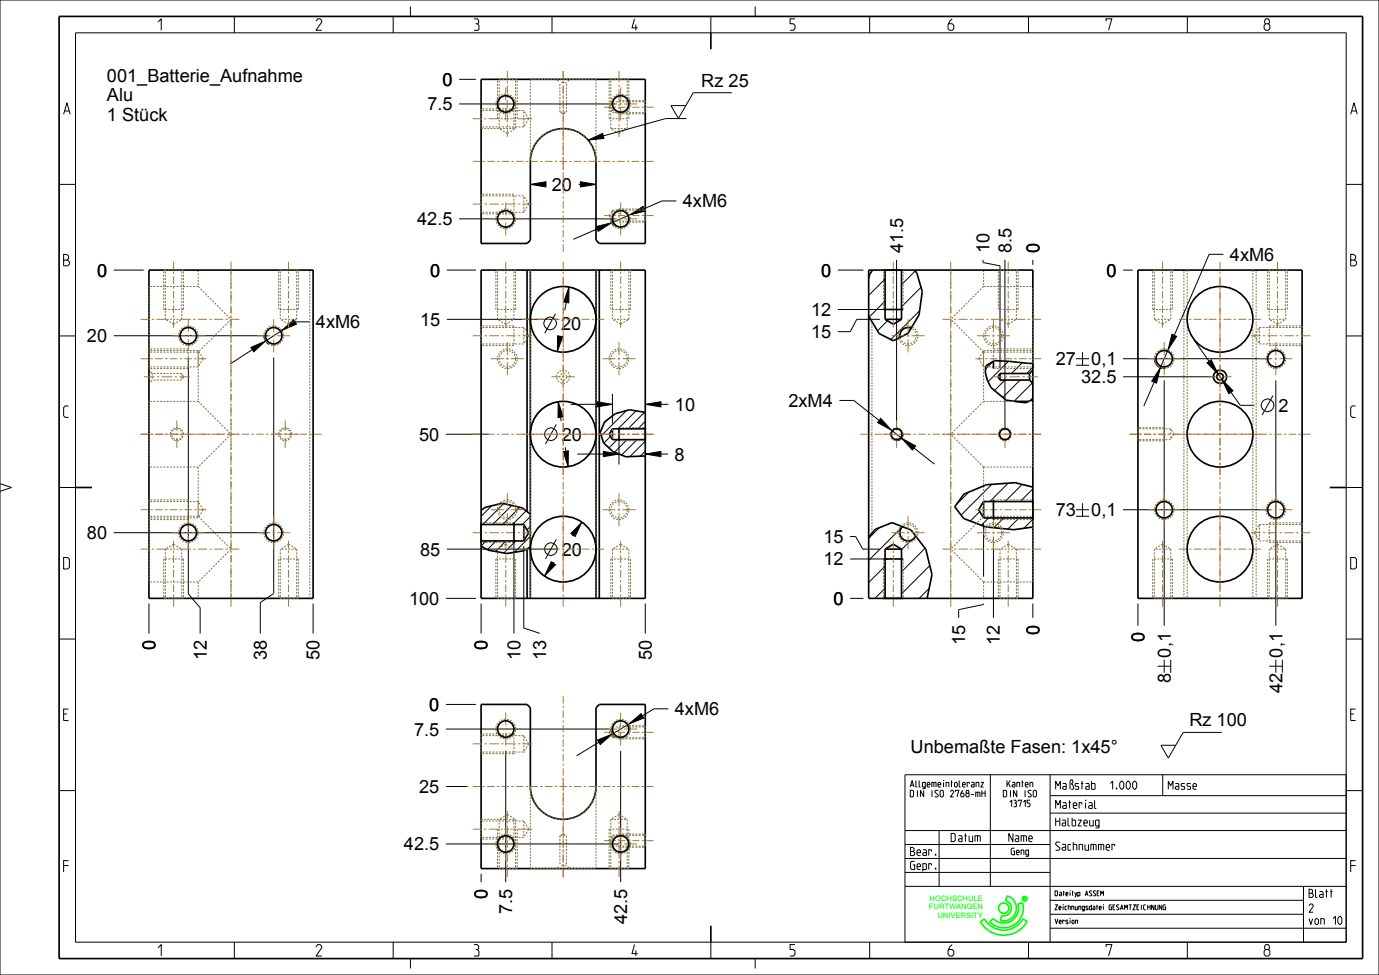
[picture p32: page 2]
Kanten; Halbzeug; Dateityp ASSEM; Blatt; Unbemaßte Fasen: 1x45°; 001_Batterie_Aufnahme Alu 1 Stück

Allgemeintoleranz
DIN ISO 2768-mH

DIN ISO | 13715 | Maßstab 1.000 | Masse
Material

Datum | Name
Geng | Sachnummer Bear.
Gepr.

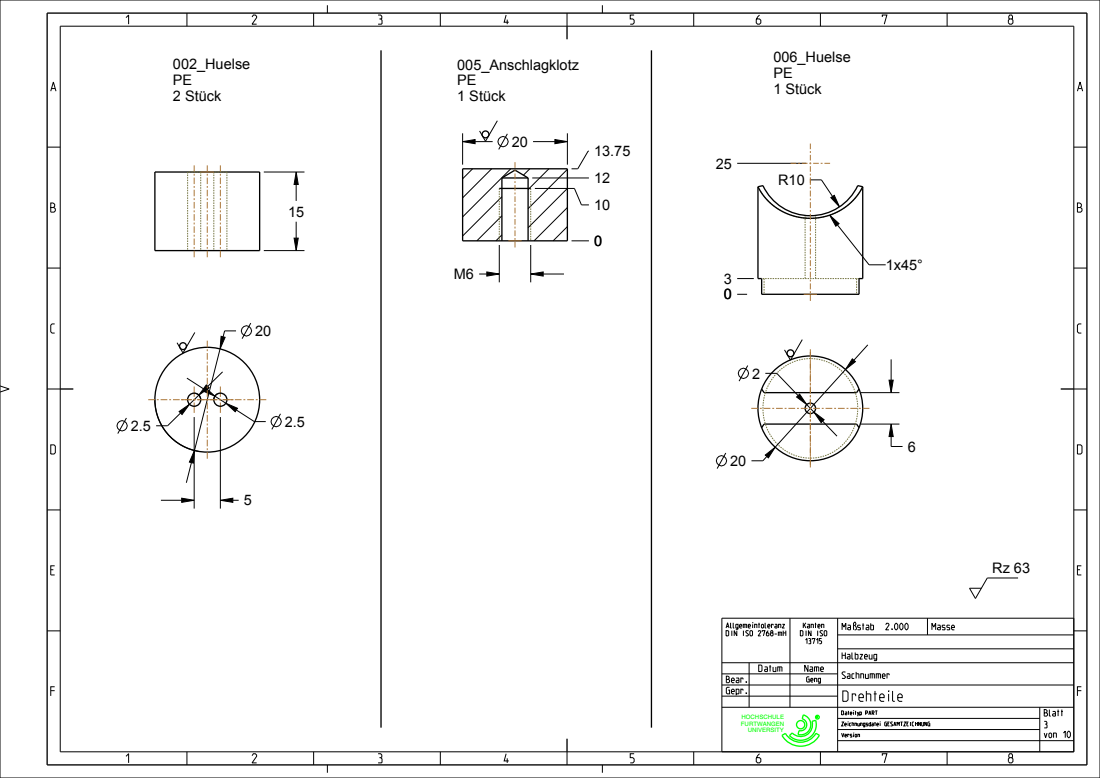
[picture p33: page 3]
Kanten DIN ISO 13715; Maßstab 2.000; Masse; Halbzeug; 002_Huelse PE 2 Stück; 006_Huelse PE 1 Stück; 005_Anschlagklotz PE 1 Stück

Allgemeintoleranz
DIN ISO 2768-mH

Datum | | Name
Geng | | Sachnummer Bear.
Gepr. | | Drehteile

Dateityp PART | | | Blatt

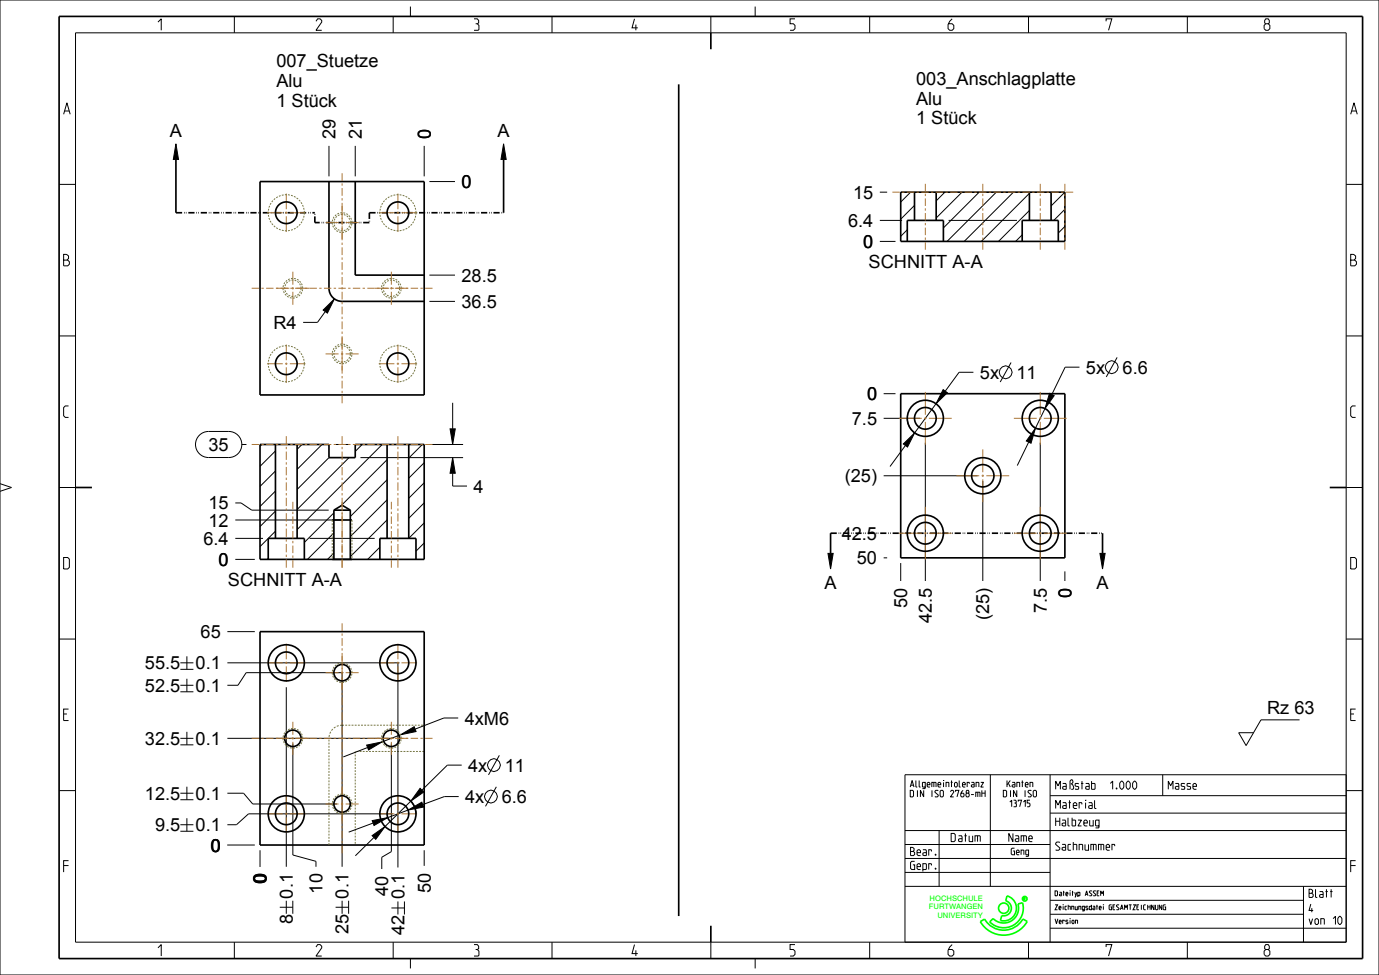
[picture p34: page 4]
EDCBA; ABCDEF; Kanten; Halbzeug; Alu 1 Stück; 1 Stück; SCHNITT A-A

007_Stuetze Alu | 003_Anschlagplatte

Allgemeintoleranz
DIN ISO 2768-mH

DIN ISO | 13715 | Maßstab 1.000 | Masse
Material

Datum | Name
Geng | Sachnummer Bear.
Gepr.

Dateityp ASSEM | Blatt 4
Zeichnungsdatei GESAMTZEICHNUNG

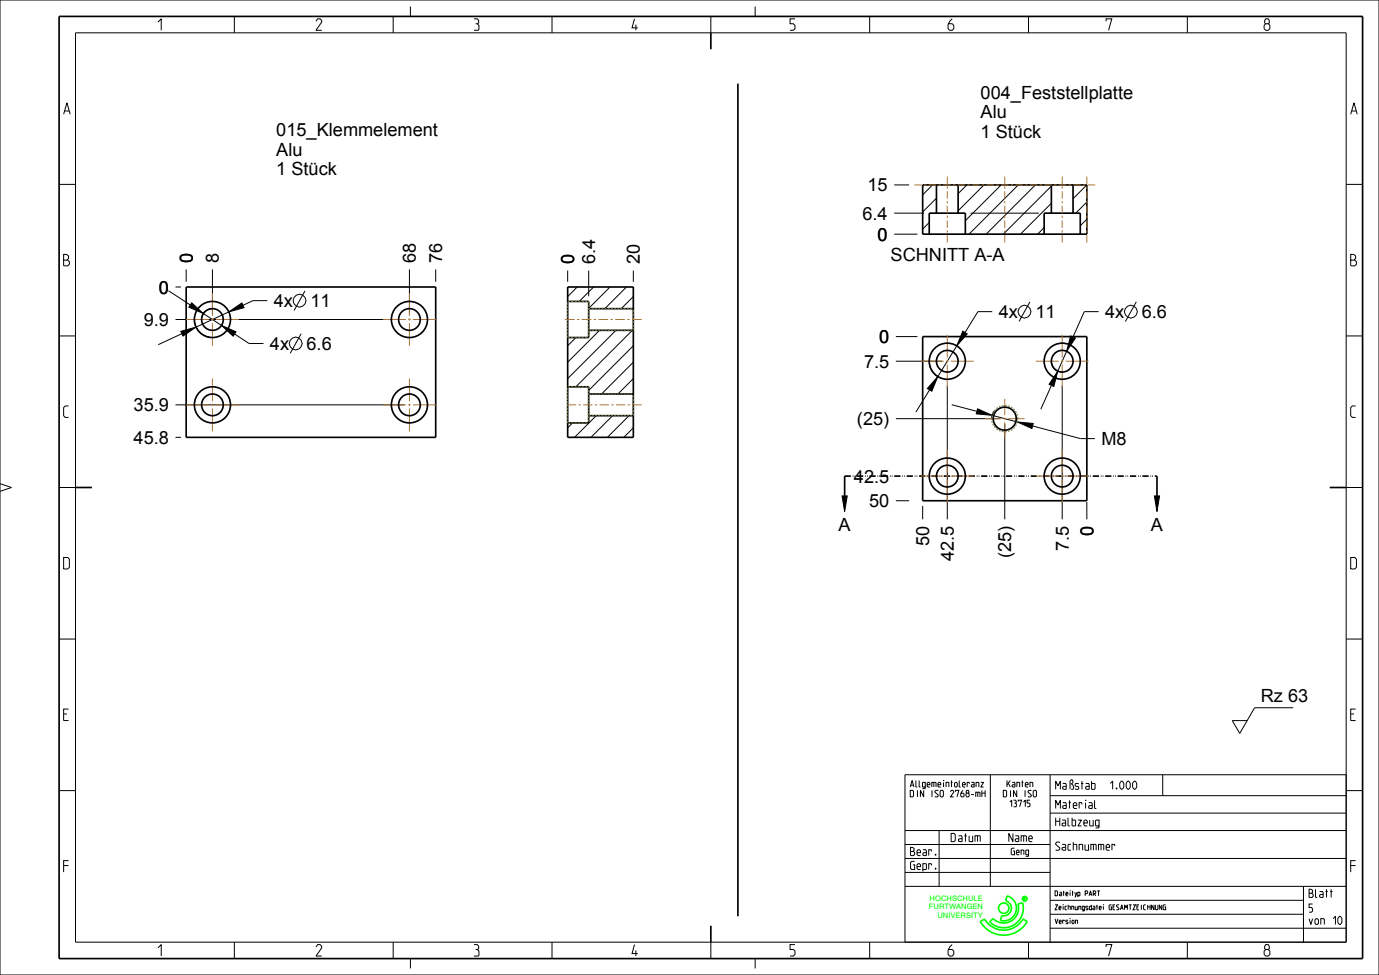
[picture p35: page 5]
Kanten; Halbzeug; Dateityp PART; Blatt; SCHNITT A-A; 004_Feststellplatte Alu; 015_Klemmelement; 1 Stück; Alu 1 Stück

Allgemeintoleranz
DIN ISO 2768-mH

DIN ISO | 13715 | Maßstab 1.000
Material

Datum | Name
Geng | Sachnummer Bear.
Gepr.

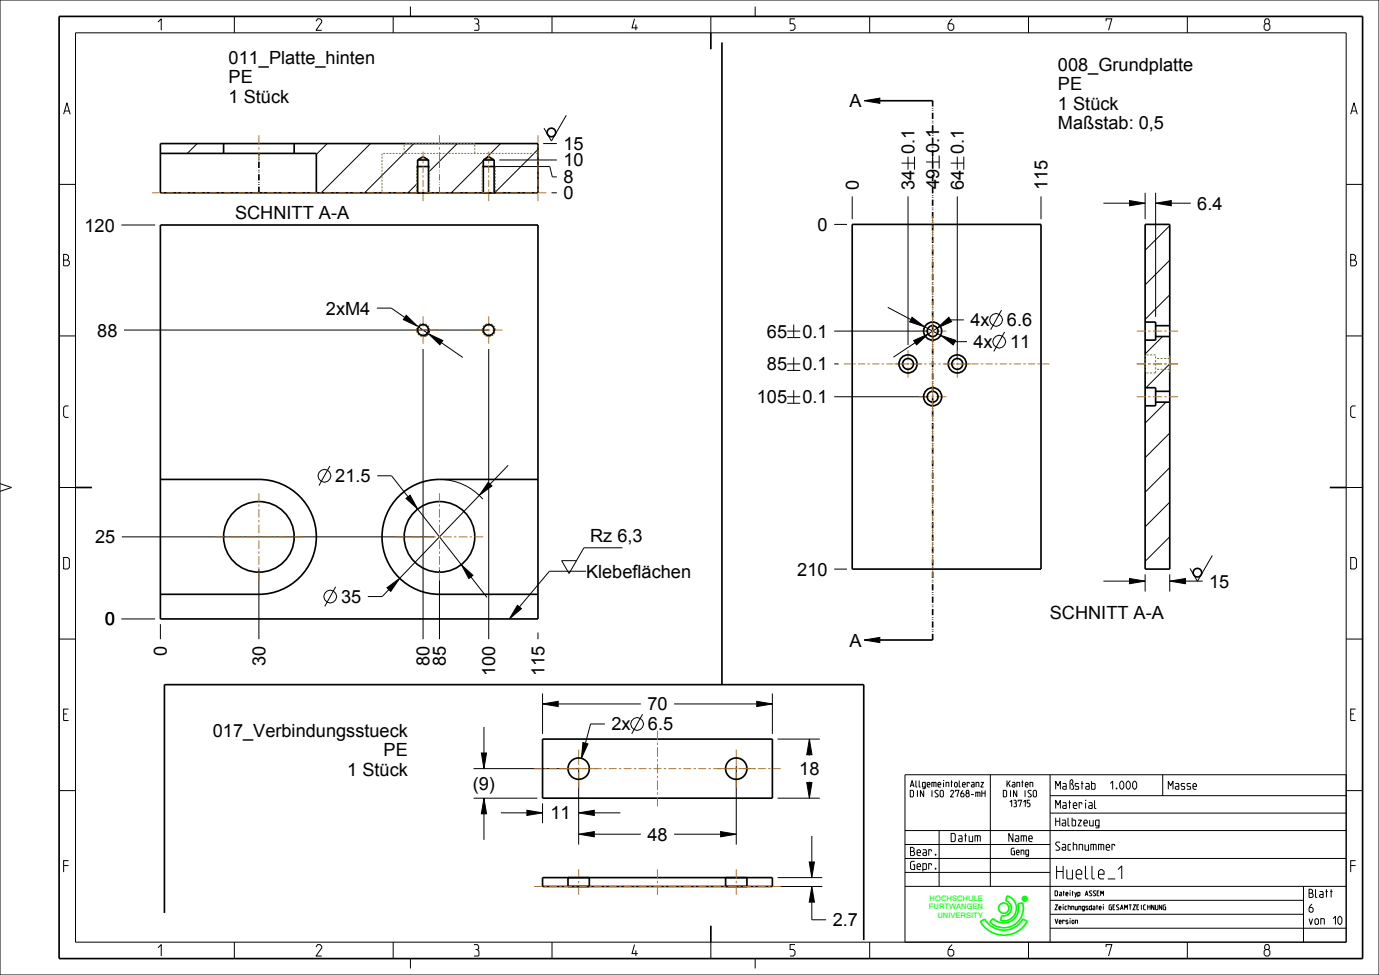
[picture p36: page 6]
Kanten; Halbzeug; Gepr.; Huelle_1; Dateityp ASSEM; Blatt; 011_Platte_hinten PE 1 Stück; 008_Grundplatte PE 1 Stück Maßstab: 0,5; 1 Stück; 017_Verbindungsstueck; SCHNITT A-A; Klebeflächen

Allgemeintoleranz
DIN ISO 2768-mH

DIN ISO | 13715 | Maßstab 1.000 | Masse
Material

Datum | Name
Geng | Sachnummer Bear.

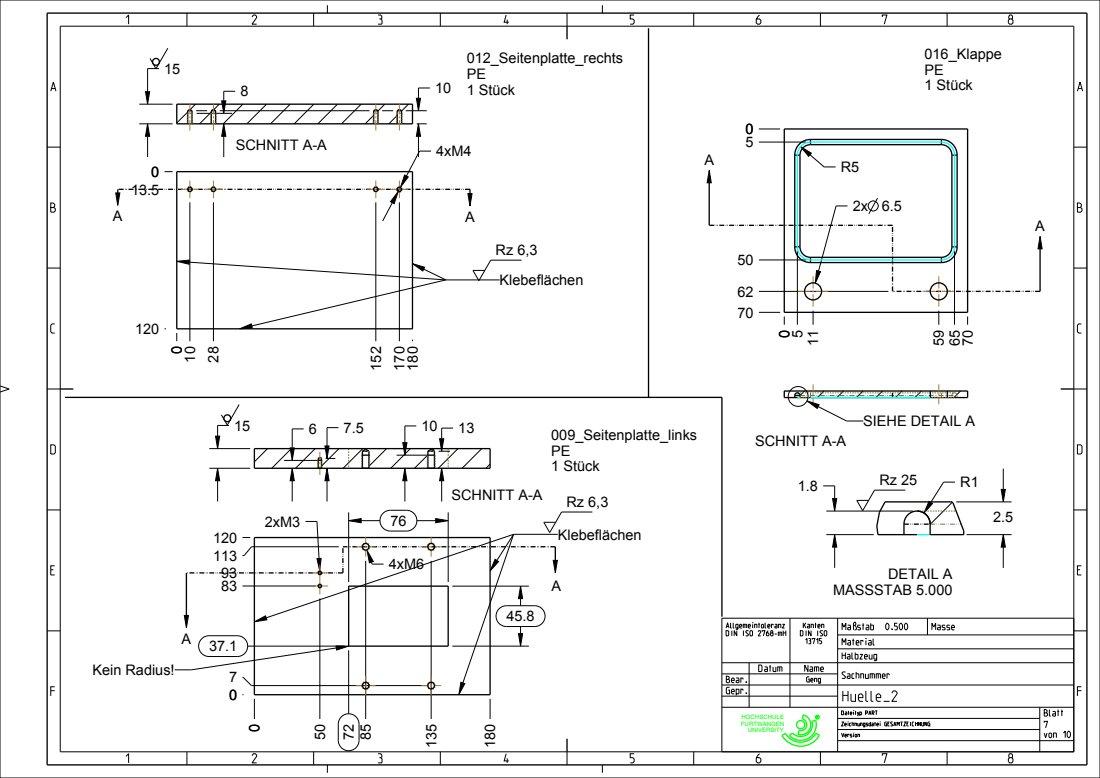
[picture p37: page 7]
Kanten; Halbzeug; Gepr.; Huelle_2; Dateityp PART; Blatt; Klebeflächen; Kein Radius!; SCHNITT A-A; 009_Seitenplatte_links PE 1 Stück; 016_Klappe PE 1 Stück; 012_Seitenplatte_rechts PE 1 Stück; SIEHE DETAIL A; MASSSTAB 5.000; DETAIL A

Allgemeintoleranz
DIN ISO 2768-mH

DIN ISO | 13715 | Maßstab 0.500 | Masse
Material

Datum | Name
Geng | Sachnummer Bear.

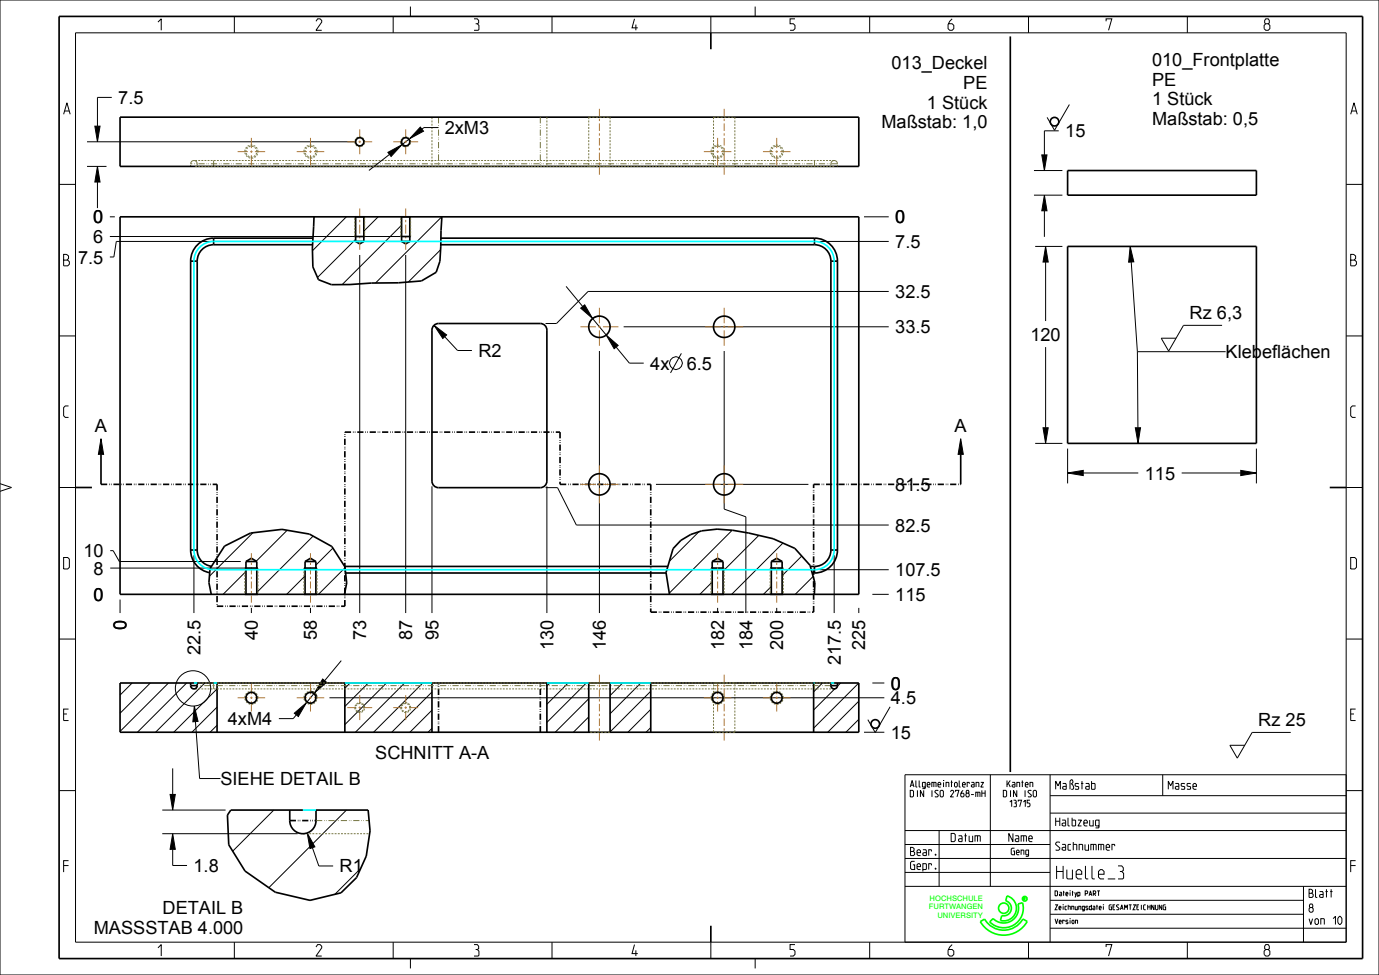
[picture p38: page 8]
Kanten DIN ISO 13715; Maßstab; Masse; Halbzeug; Gepr.; Huelle_3; Dateityp PART; Blatt; Maßstab: 1,0; 1 Stück; 013_Deckel; 010_Frontplatte; PE 1 Stück Maßstab: 0,5; SCHNITT A-A; SIEHE DETAIL B; Klebeflächen; MASSSTAB 4.000; DETAIL B

Allgemeintoleranz
DIN ISO 2768-mH

Datum | Name
Geng | Sachnummer Bear.

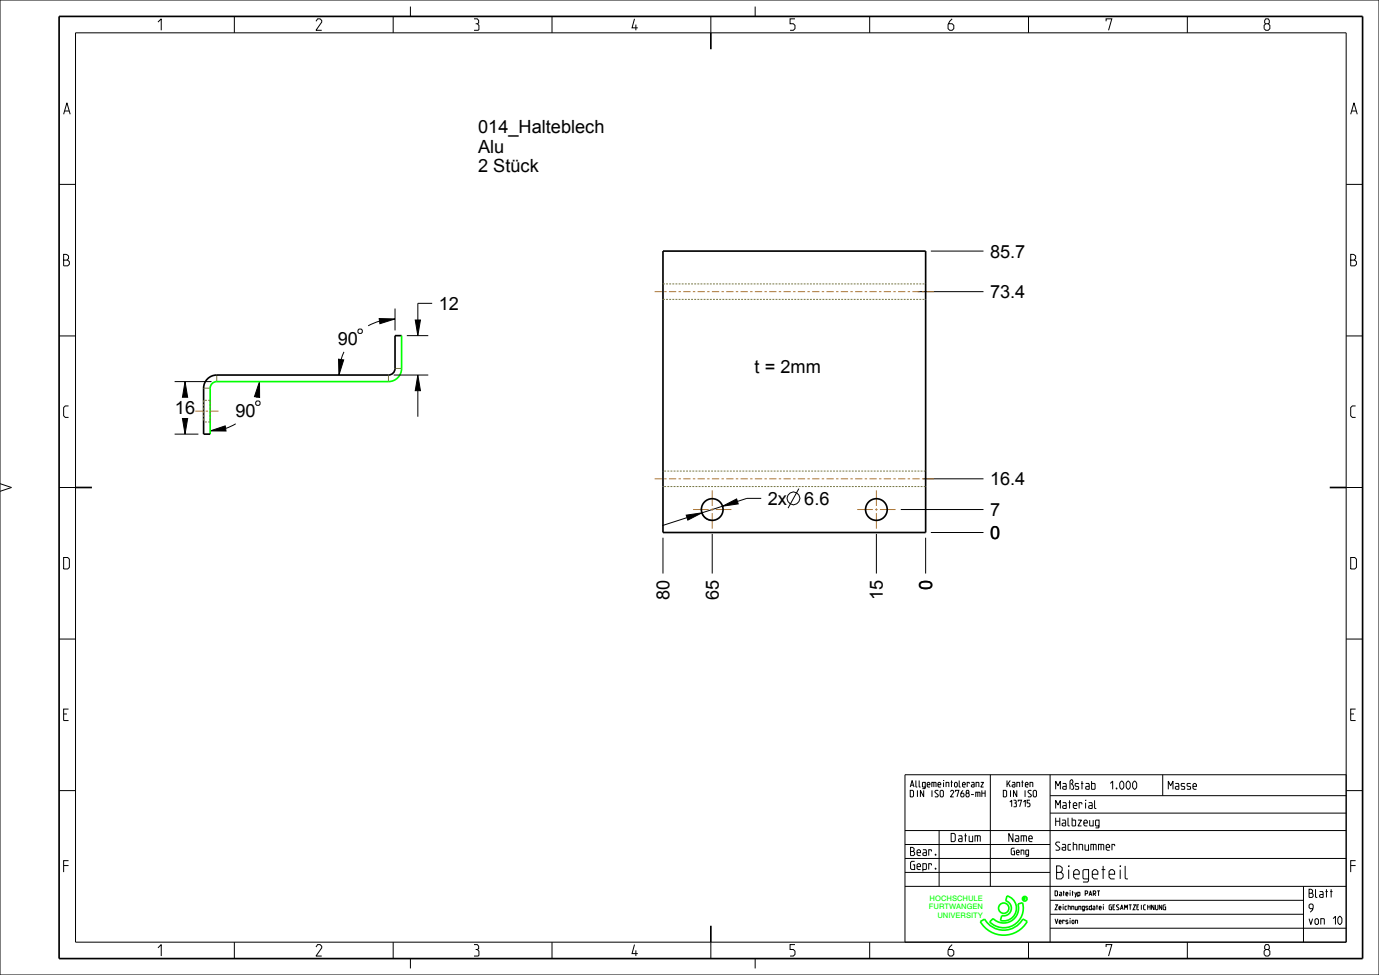
[picture p39: page 9]
Kanten; Halbzeug; 014_Halteblech Alu 2 Stück

Allgemeintoleranz
DIN ISO 2768-mH

DIN ISO | 13715 | Maßstab 1.000 | Masse
Material

Datum | | Name
Geng | | Sachnummer Bear.
Gepr. | | Biegeteil

Dateityp PART | | | Blatt

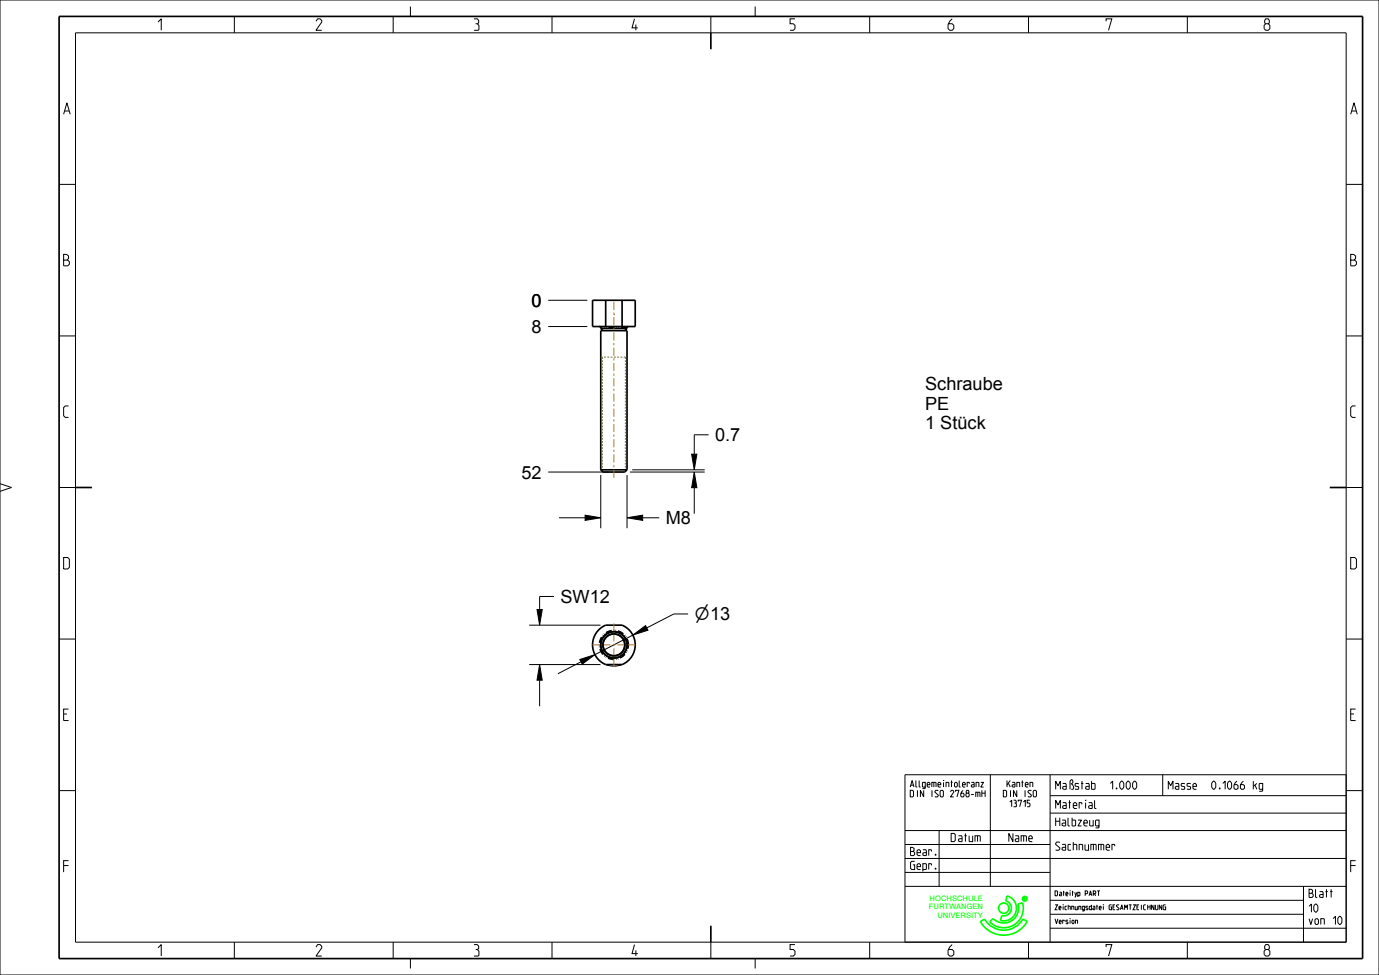
[picture p40: page 10]
Kanten; Halbzeug; Dateityp PART; Blatt; Schraube PE 1 Stück

Allgemeintoleranz
DIN ISO 2768-mH

DIN ISO | 13715 | Maßstab 1.000 | Masse 0.1066 kg
Material

Datum | Name
Sachnummer Bear.
Gepr.
