pascalguttmann/obat/docs/design/enclosure/mechanical/mcad_ptc-creo/gesamtzeichnung_Optimiert.pdf

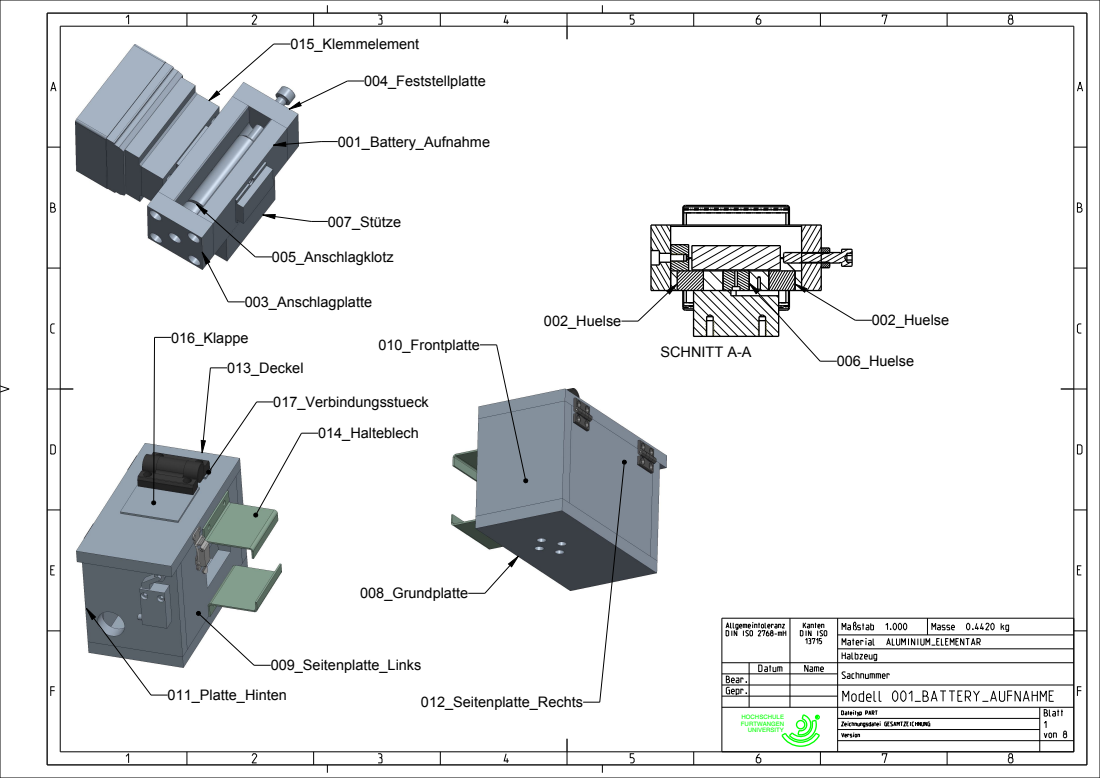
[picture p51: page 1]
HOCHSCHULE FURTWANGEN UNIVERSITY; Kanten; Halbzeug; Dateityp PART; Blatt; Zeichnungsdatei GESAMTZEICHNUNG; Version; von 8; 003_Anschlagplatte; 004_Feststellplatte; 005_Anschlagklotz; 007_Stütze; 001_Battery_Aufnahme; 015_Klemmelement; SCHNITT A-A; 002_Huelse; 006_Huelse; 009_Seitenplatte_Links; 011_Platte_Hinten; 013_Deckel; 014_Halteblech; 016_Klappe; 017_Verbindungsstueck; 008_Grundplatte; 010_Frontplatte; 012_Seitenplatte_Rechts

Allgemeintoleranz
DIN ISO 2768-mH

DIN ISO | 13715 | Maßstab 1.000 | Masse 0.4420 kg
Material ALUMINIUM_ELEMENTAR

Datum | | Name
Sachnummer Bear.
Gepr. | | Modell 001_BATTERY_AUFNAHME

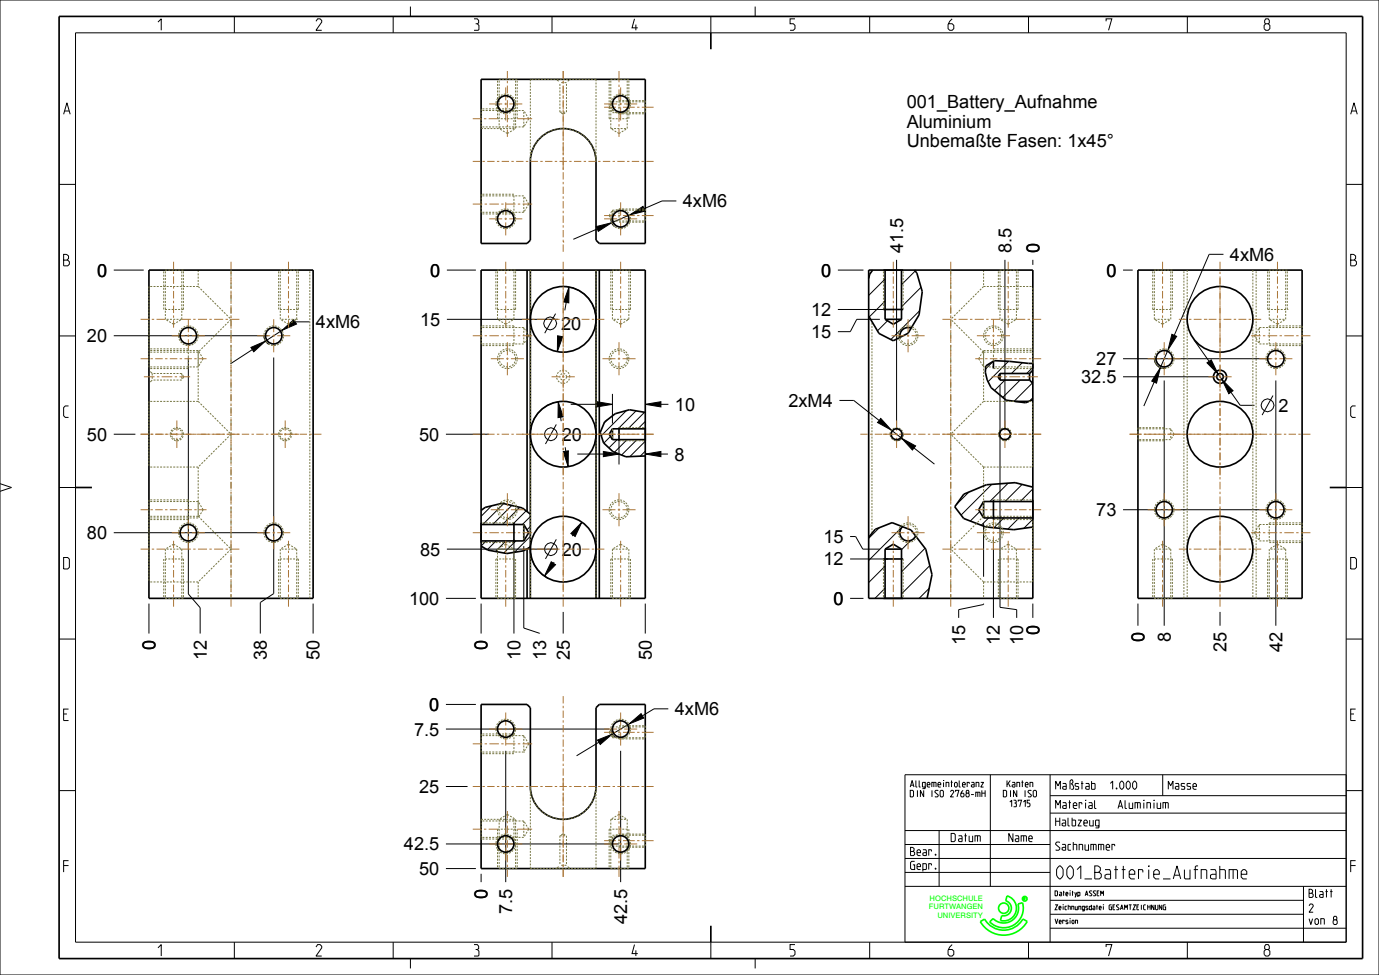
[picture p52: page 2]
Kanten; Halbzeug; 001_Battery_Aufnahme Aluminium Unbemaßte Fasen: 1x45°

Allgemeintoleranz
DIN ISO 2768-mH

DIN ISO | 13715 | Maßstab 1.000 | Masse
Material Aluminium

Datum | | Name
Sachnummer Bear.
Gepr. | | 001_Batterie_Aufnahme

Dateityp ASSEM | | | Blatt

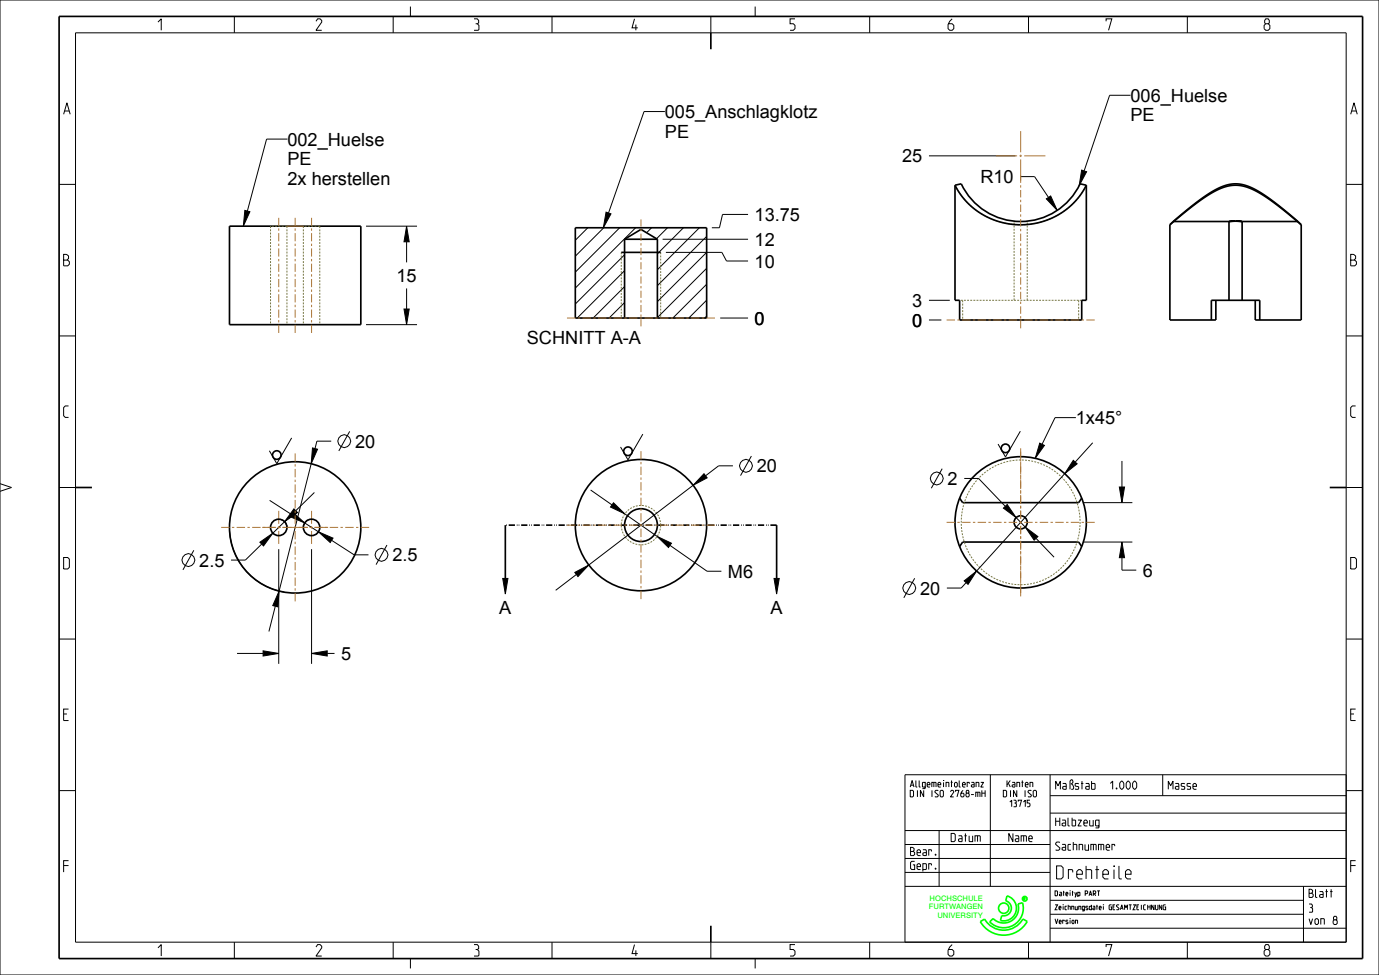
[picture p53: page 3]
Kanten DIN ISO 13715; Maßstab 1.000; Masse; Halbzeug; 002_Huelse PE 2x herstellen; SCHNITT A-A; 005_Anschlagklotz PE; 006_Huelse PE

Allgemeintoleranz
DIN ISO 2768-mH

Datum | | Name
Sachnummer Bear.
Gepr. | | Drehteile

Dateityp PART | | | Blatt

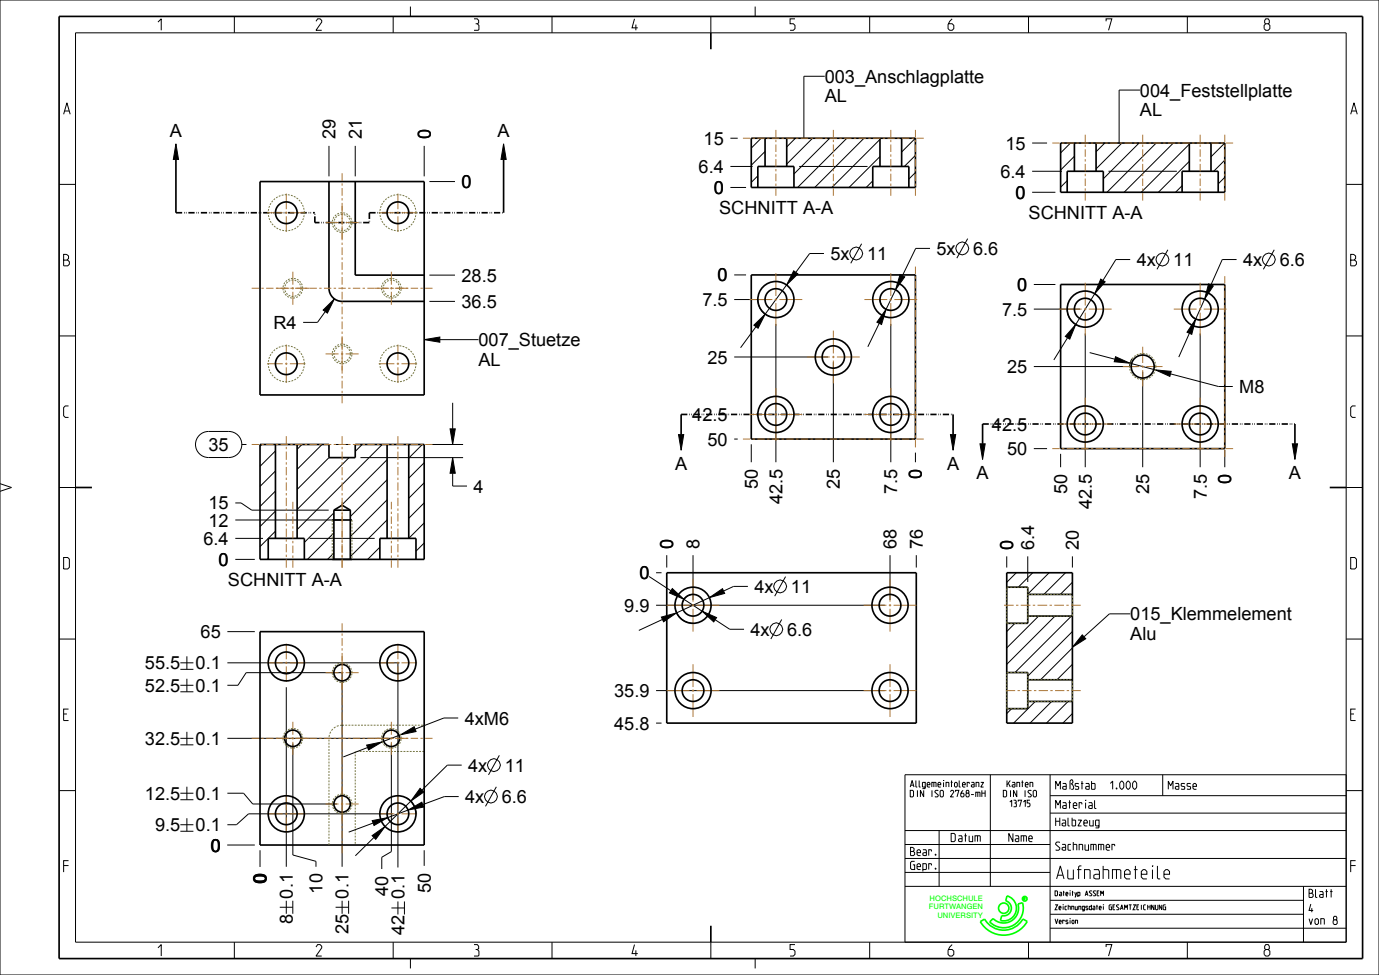
[picture p54: page 4]
Kanten; Halbzeug; SCHNITT A-A; 003_Anschlagplatte AL; 004_Feststellplatte AL; 007_Stuetze AL; 015_Klemmelement Alu

Allgemeintoleranz
DIN ISO 2768-mH

DIN ISO | 13715 | Maßstab 1.000 | Masse
Material

Datum | | Name
Sachnummer Bear.
Gepr. | | Aufnahmeteile

Dateityp ASSEM | | | Blatt

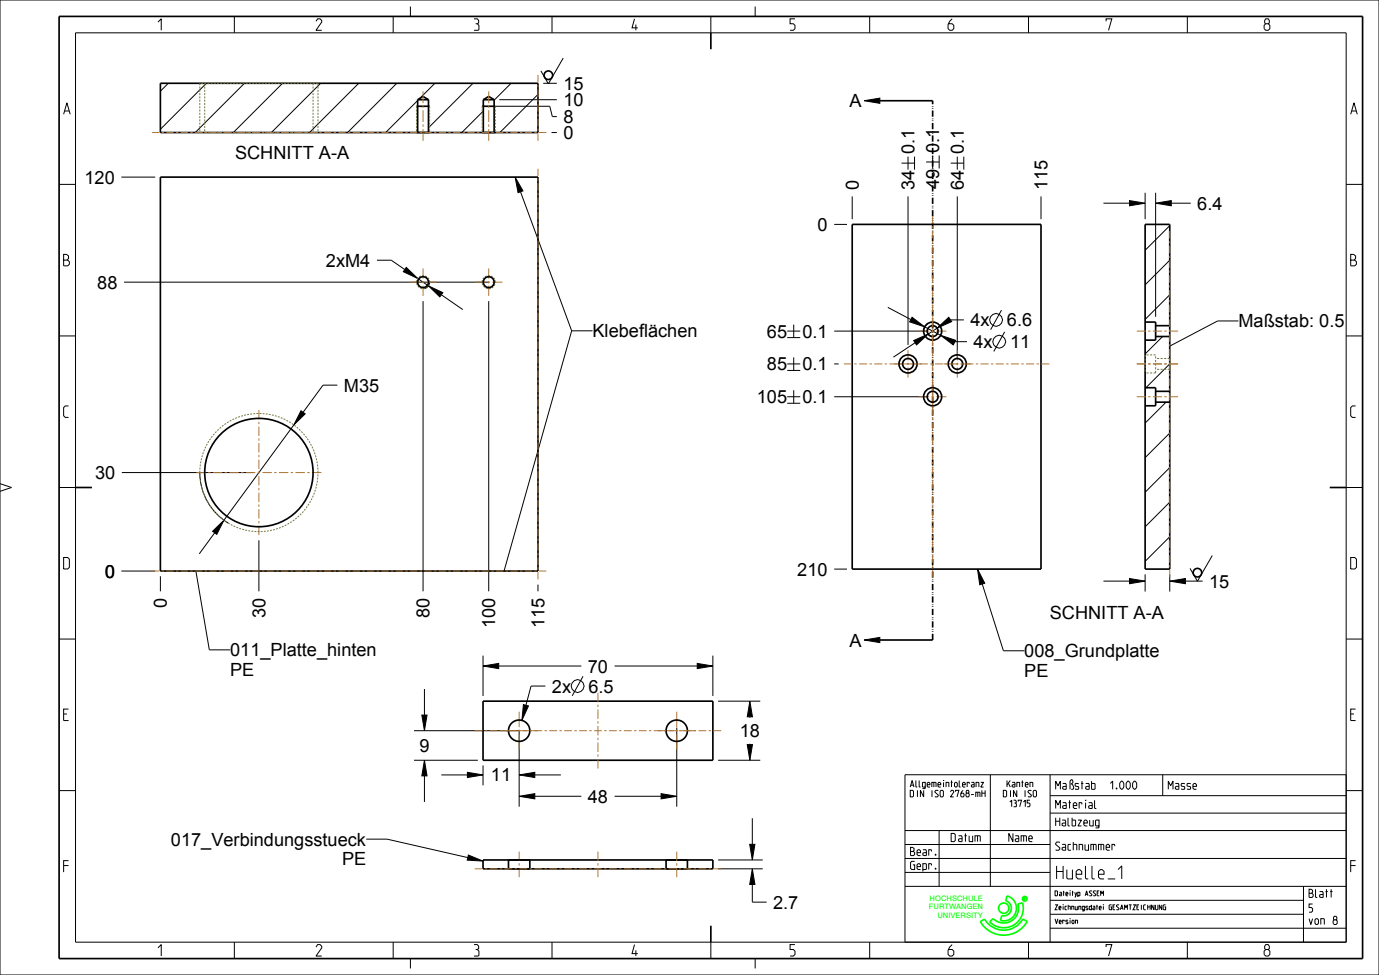
[picture p55: page 5]
Kanten; Halbzeug; Gepr.; Huelle_1; Dateityp ASSEM; Blatt; 008_Grundplatte PE; Maßstab: 0.5; SCHNITT A-A; 011_Platte_hinten PE; Klebeflächen; 017_Verbindungsstueck PE

Allgemeintoleranz
DIN ISO 2768-mH

DIN ISO | 13715 | Maßstab 1.000 | Masse
Material

Datum | Name
Sachnummer Bear.

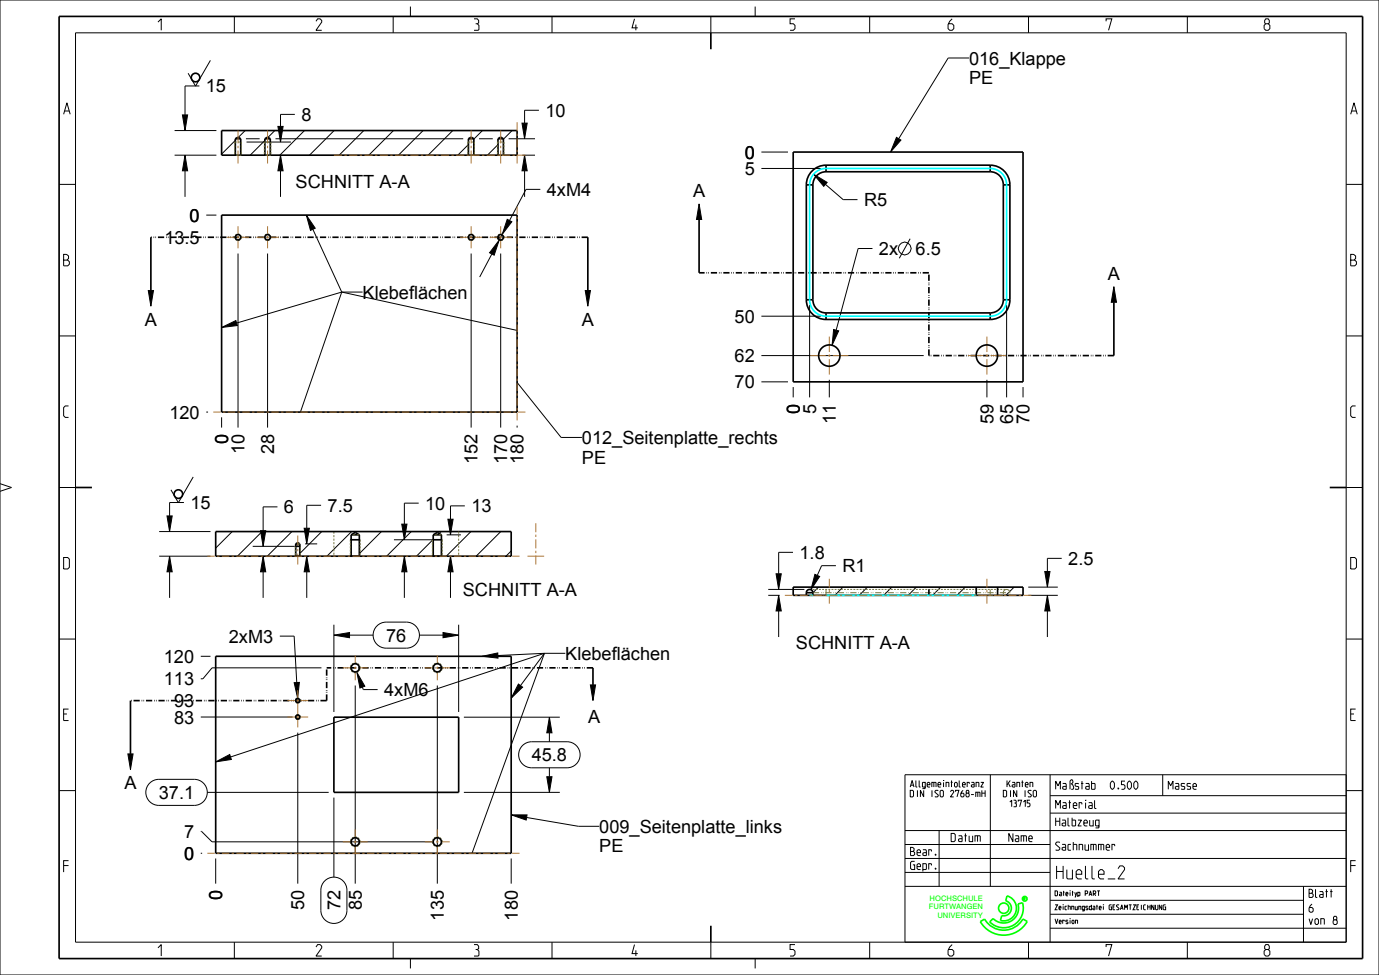
[picture p56: page 6]
Kanten; Halbzeug; Gepr.; Huelle_2; Dateityp PART; Blatt; 009_Seitenplatte_links PE; Klebeflächen; SCHNITT A-A; 012_Seitenplatte_rechts PE; 016_Klappe PE

Allgemeintoleranz
DIN ISO 2768-mH

DIN ISO | 13715 | Maßstab 0.500 | Masse
Material

Datum | Name
Sachnummer Bear.

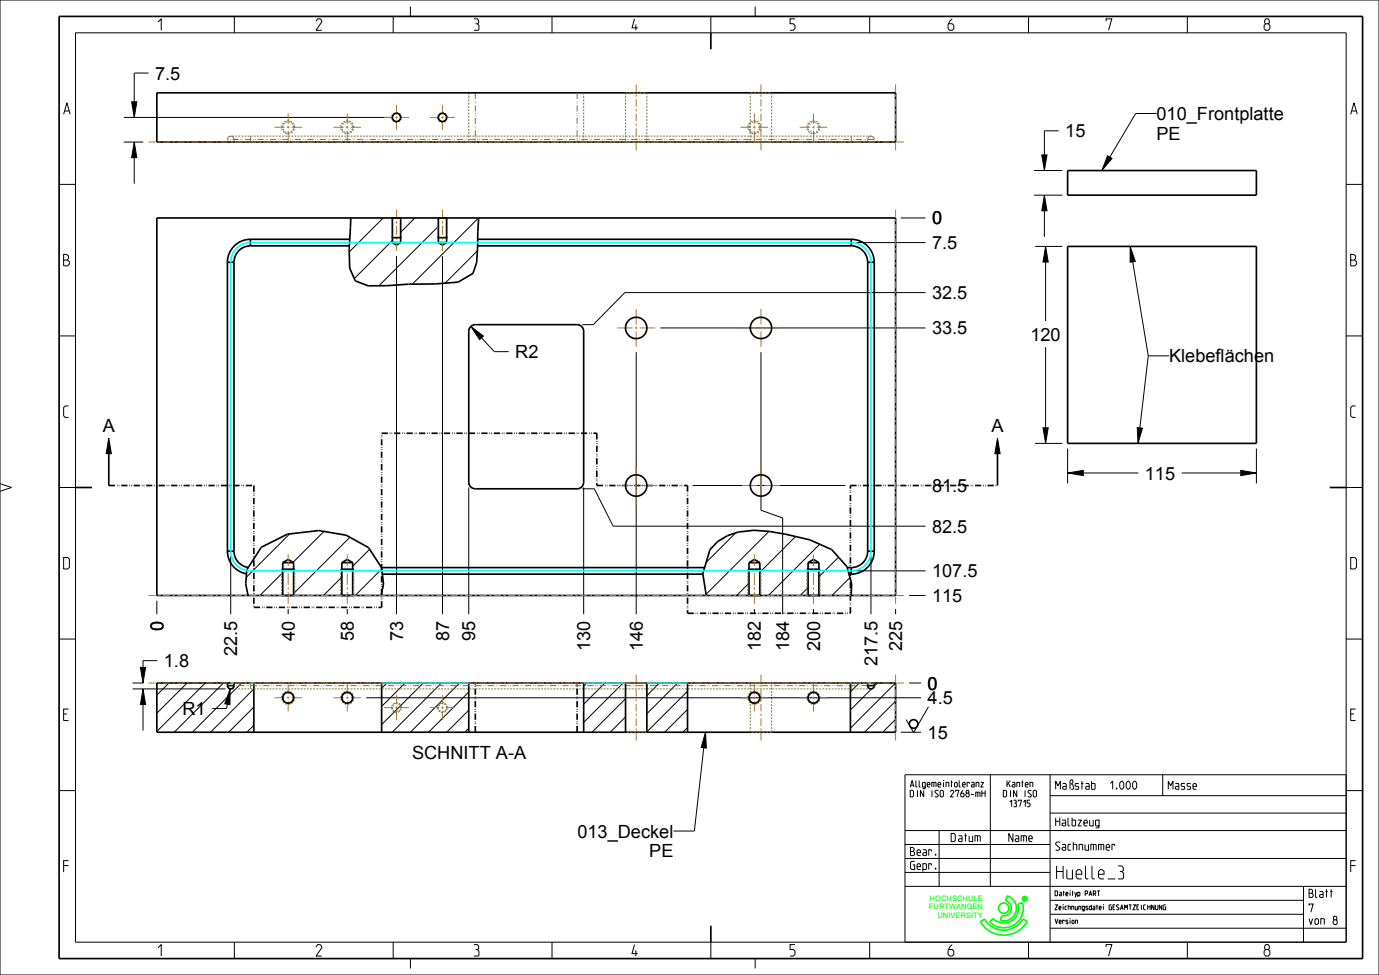
[picture p57: page 7]
Kanten DIN ISO 13715; Maßstab 1.000; Masse; Halbzeug; Gepr.; Huelle_3; Dateityp PART; Blatt; SCHNITT A-A; 013_Deckel PE; Klebeflächen; 010_Frontplatte PE

Allgemeintoleranz
DIN ISO 2768-mH

Datum | Name
Sachnummer Bear.

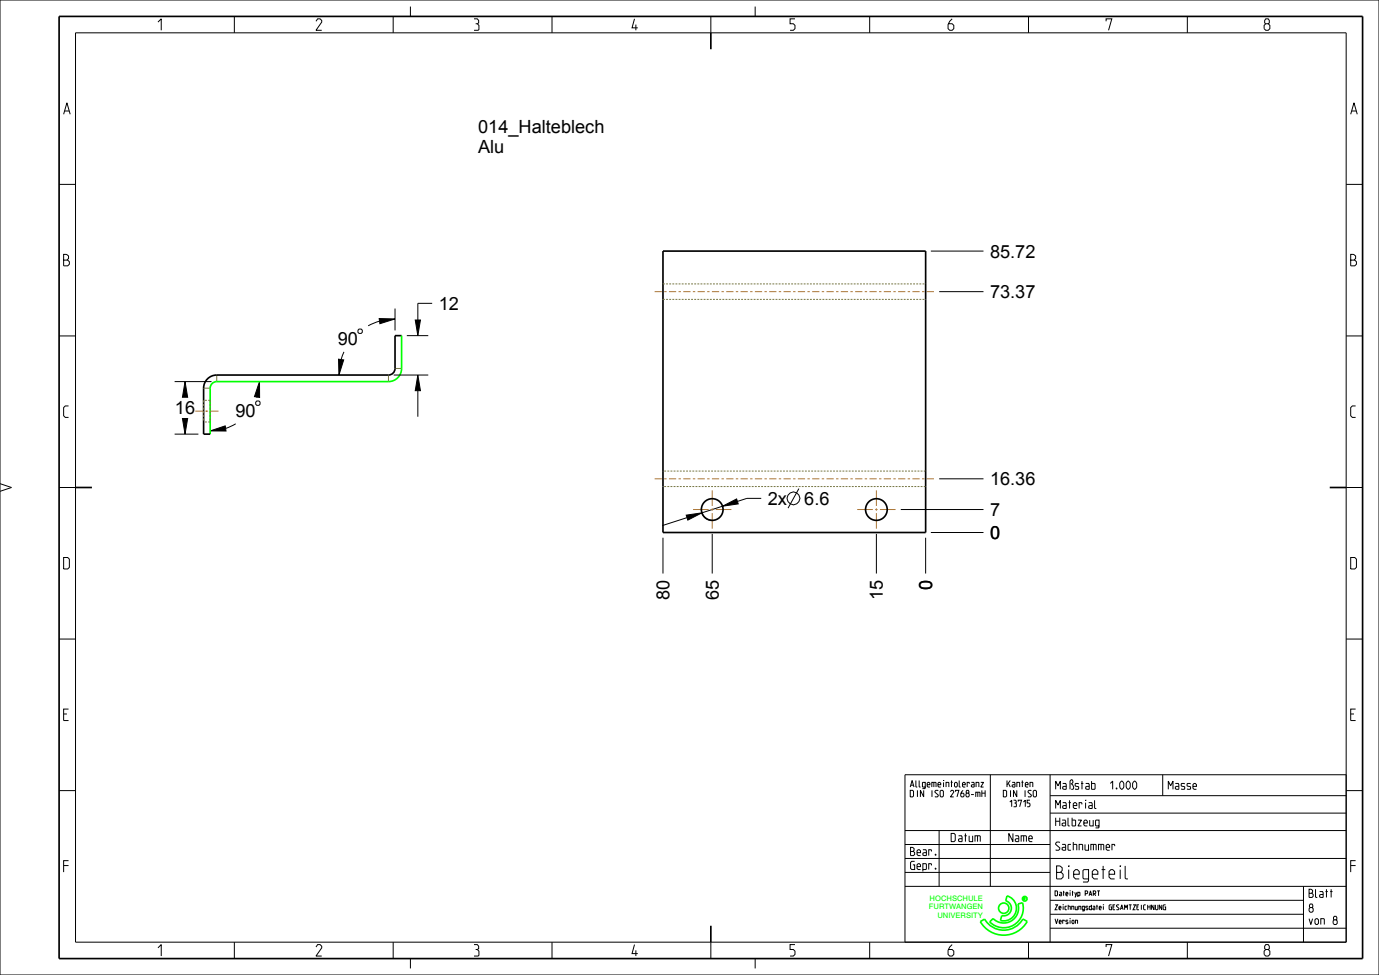
[picture p58: page 8]
Kanten; Halbzeug; 014_Halteblech Alu

Allgemeintoleranz
DIN ISO 2768-mH

DIN ISO | 13715 | Maßstab 1.000 | Masse
Material

Datum | | Name
Sachnummer Bear.
Gepr. | | Biegeteil

Dateityp PART | | | Blatt
