pascalguttmann/obat/docs/design/pss/power-electronics/sim_power-electronics_ac.pdf

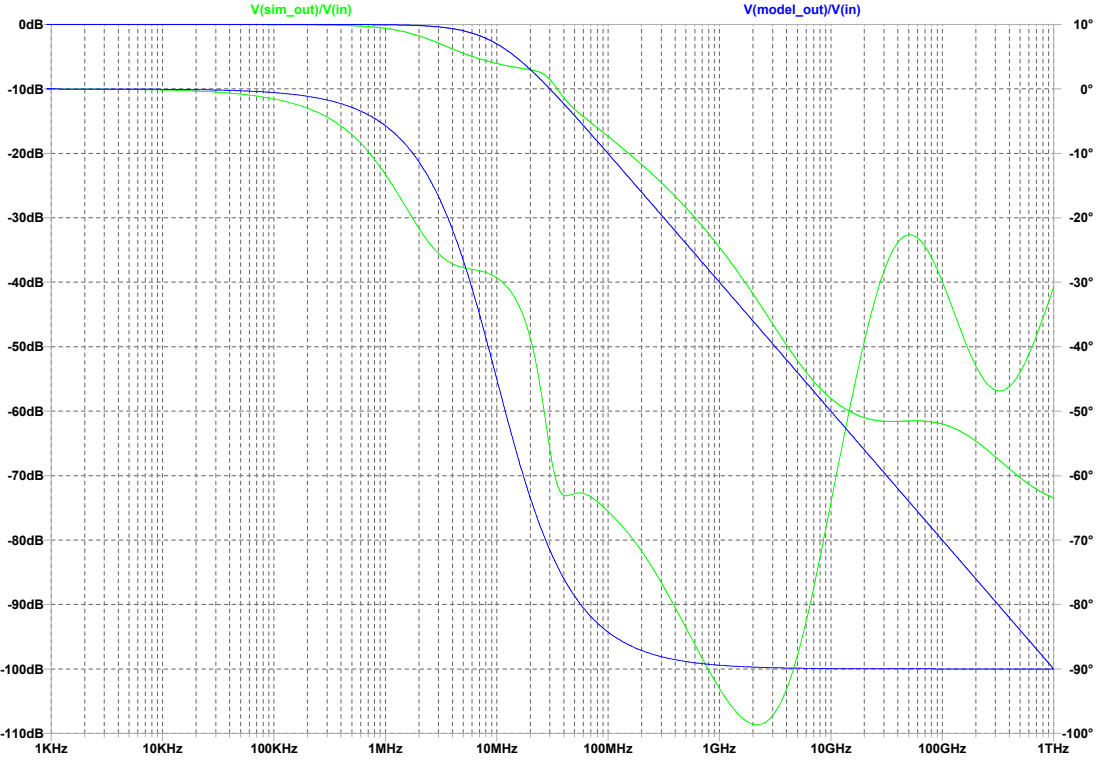
[picture p59: page 1]
1KHz; 10KHz; 100KHz; 1MHz; 10MHz; 100MHz; 1GHz; 10GHz; 100GHz; 1THz; V(sim_out)/V(in); V(model_out)/V(in)

--- D:\240318_HFU_SMA_scientific-project\obat\docs\workspace\pss\sim_bias+outstage_ac.asc ---
