pascalguttmann/obat/docs/design/pss/pss.asc

A1: buf; Vhigh=10, Vlow=-5, Ref=1
R1: res; {R}
V1: voltage; 10
V2: voltage; -5
V3: voltage; 2.5
X1: conf
X2: mux
X3: limit-logic
X4: control
X5: power-electronics
X6: meas
Named nets: 0, high, low, V_SUP+, V_SUP-, out
.tran 10m startup
.param R 250m
