pascalguttmann/obat/docs/design/pss/conf/conf.asc

A1: buf; Vhigh=10, Vlow=-5, Ref=1
A2: inv; Vhigh=10, Vlow=-5, Trise=60n, Tfall=60n, Td=30n
A3: inv; Vhigh=10, Vlow=-5, Trise=60n, Tfall=60n, Td=30n
A4: inv; Vhigh=10, Vlow=-5, Trise=60n, Tfall=60n, Td=30n
A5: inv; Vhigh=10, Vlow=-5, Trise=60n, Tfall=60n, Td=30n
A6: and; Vhigh=10, Vlow=-5, Trise=60n, Tfall=60n, Td=30n
A7: and; Vhigh=10, Vlow=-5, Trise=60n, Tfall=60n, Td=30n
A8: and; Vhigh=10, Vlow=-5, Trise=60n, Tfall=60n, Td=30n
A9: and; Vhigh=10, Vlow=-5, Trise=60n, Tfall=60n, Td=30n
A10: or; Vhigh=10, Vlow=-5, Trise=60n, Tfall=60n, Td=30n
A11: or; Vhigh=10, Vlow=-5, Trise=60n, Tfall=60n, Td=30n
Q1: npn; DI_DNLS350E
Q2: pnp; DI_DPLS350E
Q3: npn; DI_DNLS350E
Q4: pnp; DI_DPLS350E
R1: res; 1Meg
R2: res; 100k
R3: res; 10k
R4: res; 1Meg
R5: res; 15k
R6: res; 1Meg
R7: res; 100k
R8: res; 10k
R9: res; 1Meg
R10: res; 15k
U1: UniversalOpAmp2; Avol=1Meg GBW=3.5Meg Slew=20Meg; Ilimit=60m Rail=0 Vos=0
U2: UniversalOpAmp2; Avol=1Meg GBW=3.5Meg Slew=20Meg; Ilimit=60m Rail=0 Vos=0
V1: voltage; 5
V2: voltage; 0
V3: voltage; SINE(2.5 2.5 100 0)
V4: voltage; 3
V5: voltage; 0
V6: voltage; 4.5
V7: voltage; 2.0
V8: voltage; 3
Named nets: 0, conf_output_dac, conf_refselect_dac, conf_vref, conf_iref, conf_lvl, conf_uvl, conf_lcl, conf_ucl, V_SUP+, V_SUP-, high, low, conf_output_vshift, conf_output, !conf_output, conf_refselect_vshift, conf_refselect_v, conf_refselect_i, !limits_ok_v, !limits_ok_i, conf_ok, !relay_connect
.MODEL DI_DNLS350E  NPN (IS=11.7f NF=1.00 BF=388 VAF=127
+ IKF=2.97 ISE=8.95f NE=2.00 BR=4.00 NR=1.00
+ VAR=20.0 IKR=4.50 RE=23.8m RB=95.3m RC=9.53m
+ XTB=1.5 CJE=341p VJE=1.10 MJE=0.500 CJC=45.4p VJC=0.300
+ MJC=0.300 TF=574p TR=111n EG=1.12 )
.MODEL DI_DPLS350E  PNP (IS=9.40f NF=1.00 BF=382 VAF=127
+ IKF=2.48 ISE=8.14f NE=2.00 BR=4.00 NR=1.00
+ VAR=24.0 IKR=3.75 RE=25.8m RB=0.103 RC=10.3m
+ XTB=1.5 CJE=337p VJE=1.10 MJE=0.500 CJC=76.7p VJC=0.300
+ MJC=0.300 TF=645p TR=122n EG=1.12 )
