pascalguttmann/obat/docs/design/pss/control/control_var.asc

C1: cap; 10n
C2: cap; 10n
C3: cap; 10n
C4: cap; 2n
C5: cap; 1n6
D1: diode; 1N4148
D2: diode; 1N4148
D3: diode; 1N4148
D4: diode; 1N4148
D5: diode; 1N4148
D6: diode; 1N4148
R1: res; 8k2
R2: res; 1k6
R3: res; 10k
R4: res; 10k
R5: res; 33k
R6: res; 10k
R7: res; 10k
R8: res; 10k
R9: res; 10k
R10: res; 1Meg
R11: res; 1Meg
R12: res; 4k7
R13: res; 330
R14: res; 10k
R15: res; 10k
R16: res; 10k
U1: UniversalOpAmp2; Avol=1Meg GBW=70Meg Slew=20Meg; Ilimit=60m Rail=0 Vos=0
U2: UniversalOpAmp2; Avol=1Meg GBW=70Meg Slew=20Meg; Ilimit=60m Rail=0 Vos=0
U3: UniversalOpAmp2; Avol=1Meg GBW=70Meg Slew=20Meg; Ilimit=60m Rail=0 Vos=0
U4: UniversalOpAmp2; Avol=1Meg GBW=70Meg Slew=20Meg; Ilimit=60m Rail=0 Vos=0
U5: UniversalOpAmp2; Avol=1Meg GBW=70Meg Slew=20Meg; Ilimit=60m Rail=0 Vos=0
Named nets: 0, derivative, error, proportional, V_SUP+, V_SUP-, integral, ref, meas, out
.lib ./opamp.sub
