pascalguttmann/obat/docs/design/pss/power-electronics/power-electronics.asc

X1: bias
X2: outstage
Named nets: V_SUP-, V_SUP+, V_IN, V_OUT
