pascalguttmann/obat/docs/design/pss/power-electronics/sim_power-electronics.asc

V1: voltage; 10
V2: voltage; -5
V3: voltage; 0
V4: voltage; 2.5
X1: power-electronics
Named nets: 0
.dc V3 -5 10 0.1 V4 list 0 2.5 5
.step temp list 0 25 75 100
