pascalguttmann/obat/docs/design/pss/power-electronics/sim_power-electronics_ac.asc

E1: e; Laplace={w}/(s+{w})
V1: voltage; 10
V2: voltage; -5
V3: voltage; 0; AC 3 0
X1: power-electronics
Named nets: 0, model_out, sim_out, in
.ac dec 100 1k 1T
.param w={2*pi*f} f=10Meg
