pascalguttmann/obat/docs/design/pss/conf/sim_conf.asc

R1: res; 10k
R2: res; 10k
R3: res; 10k
R4: res; 10k
R5: res; 10k
R6: res; 10k
R7: res; 10k
R8: res; 10k
R9: res; 10k
R10: res; 10k
V1: voltage; 10
V2: voltage; -5
X1: conf
Named nets: 0
.tran 1
