pascalguttmann/obat/docs/design/pss/control/control.asc

X1: control_var
Named nets: V_SUP+, V_SUP-, ref, meas, out
