pascalguttmann/obat/docs/design/pss/control/control_fixed.asc

C1: cap; 470p
C2: cap; 100p
C3: cap; 10n
D1: diode; 1N4148
D2: diode; 1N4148
D3: diode; 1N4148
D4: diode; 1N4148
R1: res; 2k
R2: res; 2k
R3: res; 2k
R4: res; 2k
R5: res; 390
R6: res; 390
R7: res; 2k
R9: res; 1Meg
R10: res; 1Meg
U1: UniversalOpAmp2; Avol=500k GBW=70Meg Slew=200Meg; Ilimit=60m Rail=0 Vos=0
U2: UniversalOpAmp2; Avol=500k GBW=70Meg Slew=200Meg; Ilimit=60m Rail=0 Vos=0
Named nets: V_SUP+, V_SUP-, 0, ref, meas, out
