pascalguttmann/obat/docs/design/pss/control/sim_control_I_C.asc

B1: bv; V=I(V4)*2.5/0.025+2.5
C1: cap; 6µ8; Rpar=1G
R1: res; 100
V1: voltage; 10
V2: voltage; -5
V3: voltage; PULSE({2.5+0m*2.5/25m} {2.5+15m*2.5/25m} 10m 1n 1n 10m 10); AC 1 0
V4: voltage; 0; Rser=0
X1: control
Named nets: 0, out, meas, ref
.ac dec 100 100k 1G
Transductance of current measurement: 0V-5V = -25mA - +25mA
.tran 0 30m 5m
