pascalguttmann/obat/docs/design/pss/control/sim_control_I_R.asc

B1: bv; V=I(V4)*2.5/0.025+2.5
R1: res; 200
V1: voltage; 10
V2: voltage; -5
V3: voltage; PULSE(2.5 1 0 1n 1n 1); AC 1 0
V4: voltage; 0; Rser=0
X1: control
Named nets: 0, out, meas, ref
.ac dec 100 10k 1G
Transductance of current measurement: 0V-5V = -25mA - +25mA
.tran 10m
