pascalguttmann/obat/docs/design/pss/control/sim_control_pid.asc

V1: voltage; 10
V2: voltage; -5
V3: voltage; PULSE(0 1 100m 1n 1n 300m 600m); AC 10m 0
X1: control
Named nets: 0, out, meas, ref
.ac dec 100 1 1G
.tran 0 100.02m 100m startup
