pascalguttmann/obat/docs/design/pss/control/sim_control_U_C.asc

C1: cap; 10m
R1: res; 10
V1: voltage; 10
V2: voltage; -5
V3: voltage; PULSE(0 1 0 1n 1n 1); AC 1 0
V4: voltage; 0
X1: control
Named nets: 0, out, meas, ref
.ac dec 100 10k 1G
.tran 0 100m 0
