pascalguttmann/obat/docs/design/pss/meas/meas.asc

C1: cap; 1n
R1: res; 10k
R2: res; 10k
R3: res; 10k
R4: res; 10k
R5: res; 10k
R6: res; 10k
R7: res; 10k
R8: res; 10k
R9: res; 5k76
R10: res; 495
R11: res; 9k1
U1: ACS730
U2: UniversalOpAmp2; Avol=1Meg GBW=3.5Meg Slew=20Meg; Ilimit=60m Rail=0 Vos=0
U3: UniversalOpAmp2; Avol=1Meg GBW=3.5Meg Slew=20Meg; Ilimit=60m Rail=0 Vos=0
V1: voltage; 5
V2: voltage; 0
Named nets: 0, viout, V_SUP+, V_SUP-, vzcr, meas_out_i, in, out, meas_out_v
.lib ./ACS730.lib
