pascalguttmann/obat/docs/design/pss/meas/sim_meas.asc

I1: current; 0; AC 10 0
V1: voltage; 10
V2: voltage; -5
X1: meas
Named nets: 0, meas_out_v, meas_out_i, out
.dc I1 -25 25 100m
.ac dec 100 1k 100Meg
