pascalguttmann/obat/docs/design/pss/control/sim_control_gapping.asc

R1: res; R=if(time>1,if(time>1.1,1m,1G),1m)
R3: res; R=if(time>1,if(time>1.1,1m,1G),1m)
V1: voltage; 10
V2: voltage; -5
V3: voltage; 2.5
X1: control
Named nets: 0, out, meas, ref
.tran 0 {1.2} {0.9}
Gapping inputs from time = 1 until 1.1,
otherwise feedback with R=1m, and input V(ref) = 2.5
