pascalguttmann/obat/docs/design/pss/mux/mux.asc

A1: or; Vhigh=10, Vlow=-5, Trise=60n, Tfall=60n, Td=30n
A2: or; Vhigh=10, Vlow=-5, Trise=60n, Tfall=60n, Td=30n
A3: buf; Vhigh=10, Vlow=-5, Ref=1
U1: cd4066
U2: cd4066
U3: cd4066
U4: cd4066
U5: cd4066
U6: cd4066
U7: cd4066
U8: cd4066
Named nets: V_SUP+, V_SUP-, mode_vc, mode_uclc, mode_lclc, mode_cc, mode_uvlc, mode_lvlc, conf_vref, conf_ucl, conf_lcl, conf_iref, conf_uvl, conf_lvl, mux_ref, meas_out_v, meas_out_i, low, mux_meas, 0, high
.tran 1
.inc cd4066.sub
