pascalguttmann/obat/docs/design/pss/mux/sim_mux.asc

A1: buf; Vhigh=10, Vlow=-5, Ref=1
V1: voltage; 10
V2: voltage; -5
V5: voltage; SINE(2.5 2.5 100)
V6: voltage; 4
V7: voltage; 2
V8: voltage; 3
V9: voltage; 1
V10: voltage; 2
V11: voltage; SINE(2.5 2.5 50)
V12: voltage; 3
X1: mux
Named nets: 0, conf_vref, conf_iref, conf_lcl, conf_ucl, conf_lvl, conf_uvl, meas_out_v, meas_out_i, high, low, mux_ref, mux_meas
.tran 100m
