pascalguttmann/obat/docs/design/pss/limit-logic/limit-logic.asc

A1: or; Vhigh=10, Vlow=-5, Trise=60n, Tfall=60n, Td=30n
A2: srflop; Vhigh=10, Vlow=-5, Trise=60n, Tfall=60n, Td=30n
A3: and; Vhigh=10, Vlow=-5, Trise=60n, Tfall=60n, Td=30n
A4: buf; Vhigh=10, Vlow=-5, Ref=1
A5: srflop; Vhigh=10, Vlow=-5, Trise=60n, Tfall=60n, Td=30n
A6: and; Vhigh=10, Vlow=-5, Trise=60n, Tfall=60n, Td=30n
A7: srflop; Vhigh=10, Vlow=-5, Trise=60n, Tfall=60n, Td=30n
A8: and; Vhigh=10, Vlow=-5, Trise=60n, Tfall=60n, Td=30n
A9: srflop; Vhigh=10, Vlow=-5, Trise=60n, Tfall=60n, Td=30n
A10: and; Vhigh=10, Vlow=-5, Trise=60n, Tfall=60n, Td=30n
A11: srflop; Vhigh=10, Vlow=-5, Trise=60n, Tfall=60n, Td=30n
A12: and; Vhigh=10, Vlow=-5, Trise=60n, Tfall=60n, Td=30n
A13: srflop; Vhigh=10, Vlow=-5, Trise=60n, Tfall=60n, Td=30n
A14: and; Vhigh=10, Vlow=-5, Trise=60n, Tfall=60n, Td=30n
A15: or; Vhigh=10, Vlow=-5, Trise=60n, Tfall=60n, Td=30n
A16: or; Vhigh=10, Vlow=-5, Trise=60n, Tfall=60n, Td=30n
X1: compare-logic
X2: mode-transition
Named nets: meas_out_v, meas_out_i, conf_vref, conf_iref, conf_uvl, conf_lvl, conf_ucl, conf_lcl, conf_refselect_v, conf_refselect_i, conf_ok, power_ok, r_mode_vc, r_mode_lclc, r_mode_uclc, r_mode_cc, r_mode_lvlc, r_mode_uvlc, s_mode_vc, s_mode_lclc, s_mode_uclc, s_mode_cc, s_mode_lvlc, s_mode_uvlc, enable_ok, 0, high, low, mode_vc, mode_lclc, mode_uclc, mode_cc, mode_lvlc, mode_uvlc, ~mode, V_SUP+, V_SUP-
