pascalguttmann/obat/docs/design/pss/limit-logic/sim_limit-logic.asc

A1: buf; Vhigh=10, Vlow=-5, Ref=1
V1: voltage; 10
V2: voltage; -5
V3: voltage; 3
V4: voltage; 4
V5: voltage; 2
V6: voltage; 3
V7: voltage; 1
V8: voltage; 2
V9: voltage; SINE(2.5 2.5 10k)
V10: voltage; SINE(2.5 2.5 3k)
V11: voltage; 10
V12: voltage; -5
X1: limit-logic
Named nets: 0, conf_refselect_v, conf_refselect_i, conf_vref, conf_iref, conf_lcl, conf_ucl, conf_lvl, conf_uvl, meas_out_v, meas_out_i, high, low, mode_vc, mode_lclc, mode_uclc, mode_cc, mode_lvlc, mode_uvlc
.tran 1500u
