pascalguttmann/obat/docs/design/pss/power-electronics/bias/sim_bias.asc

I1: current; 20m
V1: voltage; {V}
V2: voltage; -5
V3: voltage; 0
X1: bias
Named nets: 0, V_OUT+, V_OUT-
.dc V3 -5 10 0.1
.step param V list 10 11 12
