pascalguttmann/obat/docs/design/pss/limit-logic/compare-logic/compare-logic.asc

A1: inv; Vhigh=10, Vlow=-5, Trise=60n, Tfall=60n, Td=30n
A2: and; Vhigh=10, Vlow=-5, Trise=60n, Tfall=60n, Td=30n
A3: or; Vhigh=10, Vlow=-5, Trise=60n, Tfall=60n, Td=30n
A4: and; Vhigh=10, Vlow=-5, Trise=60n, Tfall=60n, Td=30n
A5: buf; Vhigh=10, Vlow=-5, Ref=1
A6: and; Vhigh=10, Vlow=-5, Trise=60n, Tfall=60n, Td=30n
A7: or; Vhigh=10, Vlow=-5, Trise=60n, Tfall=60n, Td=30n
A8: and; Vhigh=10, Vlow=-5, Trise=60n, Tfall=60n, Td=30n
A9: inv; Vhigh=10, Vlow=-5, Trise=60n, Tfall=60n, Td=30n
A10: inv; Vhigh=10, Vlow=-5, Trise=60n, Tfall=60n, Td=30n
A11: inv; Vhigh=10, Vlow=-5, Trise=60n, Tfall=60n, Td=30n
X1: window-comparator
X2: window-comparator
X3: window-comparator
X4: window-comparator
Named nets: 0, high, low, conf_refselect_v, conf_refselect_i, V_SUP+, V_SUP-, comp_mgtt, comp_mstt, comp_uvle, comp_lvle, comp_ucle, comp_lcle, meas_out_v, meas_out_i, conf_vref, conf_iref, conf_uvl, conf_lvl, conf_ucl, conf_lcl
