pascalguttmann/obat/docs/design/pss/limit-logic/compare-logic/sim_compare-logic.asc

V1: voltage; 10
V2: voltage; -5
V3: voltage; 10
V4: voltage; -5
V5: voltage; 3
V6: voltage; 4
V7: voltage; 2
V8: voltage; 3
V9: voltage; 1
V10: voltage; 2
V11: voltage; SINE(2.5 2.5 10k)
V12: voltage; SINE(2.5 2.5 3k)
X1: compare-logic
Named nets: 0, conf_refselect_v, conf_refselect_i, conf_vref, conf_iref, conf_lcl, conf_ucl, conf_lvl, conf_uvl, meas_out_v, meas_out_i, comp_lcle, comp_ucle, comp_lvle, comp_uvle, comp_mgtt, comp_mstt
.tran 500u
