pascalguttmann/obat/docs/design/pss/limit-logic/mode-transition/mode-transition.asc

A1: buf; Vhigh=10, Vlow=-5, Ref=1
A2: and; Vhigh=10, Vlow=-5, Trise=60n, Tfall=60n, Td=30n
A3: and; Vhigh=10, Vlow=-5, Trise=60n, Tfall=60n, Td=30n
A4: inv; Vhigh=10, Vlow=-5, Trise=60n, Tfall=60n, Td=30n
A5: inv; Vhigh=10, Vlow=-5, Trise=60n, Tfall=60n, Td=30n
A6: and; Vhigh=10, Vlow=-5, Trise=60n, Tfall=60n, Td=30n
A7: and; Vhigh=10, Vlow=-5, Trise=60n, Tfall=60n, Td=30n
A8: and; Vhigh=10, Vlow=-5, Trise=60n, Tfall=60n, Td=30n
A9: and; Vhigh=10, Vlow=-5, Trise=60n, Tfall=60n, Td=30n
A10: inv; Vhigh=10, Vlow=-5, Trise=60n, Tfall=60n, Td=30n
A11: and; Vhigh=10, Vlow=-5, Trise=60n, Tfall=60n, Td=30n
A12: and; Vhigh=10, Vlow=-5, Trise=60n, Tfall=60n, Td=30n
A13: or; Vhigh=10, Vlow=-5, Trise=60n, Tfall=60n, Td=30n
A14: or; Vhigh=10, Vlow=-5, Trise=60n, Tfall=60n, Td=30n
A15: or; Vhigh=10, Vlow=-5, Trise=60n, Tfall=60n, Td=30n
A16: inv; Vhigh=10, Vlow=-5, Trise=60n, Tfall=60n, Td=30n
A17: inv; Vhigh=10, Vlow=-5, Trise=60n, Tfall=60n, Td=30n
A18: and; Vhigh=10, Vlow=-5, Trise=60n, Tfall=60n, Td=30n
A19: and; Vhigh=10, Vlow=-5, Trise=60n, Tfall=60n, Td=30n
A20: and; Vhigh=10, Vlow=-5, Trise=60n, Tfall=60n, Td=30n
A21: and; Vhigh=10, Vlow=-5, Trise=60n, Tfall=60n, Td=30n
A22: inv; Vhigh=10, Vlow=-5, Trise=60n, Tfall=60n, Td=30n
A23: and; Vhigh=10, Vlow=-5, Trise=60n, Tfall=60n, Td=30n
A24: and; Vhigh=10, Vlow=-5, Trise=60n, Tfall=60n, Td=30n
A25: or; Vhigh=10, Vlow=-5, Trise=60n, Tfall=60n, Td=30n
A26: or; Vhigh=10, Vlow=-5, Trise=60n, Tfall=60n, Td=30n
A27: or; Vhigh=10, Vlow=-5, Trise=60n, Tfall=60n, Td=30n
A28: inv; Vhigh=10, Vlow=-5, Trise=60n, Tfall=60n, Td=30n
A29: inv; Vhigh=10, Vlow=-5, Trise=60n, Tfall=60n, Td=30n
A30: inv; Vhigh=10, Vlow=-5, Trise=60n, Tfall=60n, Td=30n
A31: inv; Vhigh=10, Vlow=-5, Trise=60n, Tfall=60n, Td=30n
Named nets: 0, high, low, comp_lcle, comp_ucle, conf_refselect_v, transition_ready, s_mode_vc, s_mode_lclc, s_mode_uclc, comp_mstt, comp_mgtt, ~enable_ok, conf_refselect_i, r_mode_vc, r_mode_lclc, r_mode_uclc, comp_lvle, comp_uvle, s_mode_cc, s_mode_lvlc, s_mode_uvlc, r_mode_cc, r_mode_lvlc, r_mode_uvlc, conf_ok, power_ok, enable_ok, ~mode
