pascalguttmann/obat/docs/design/pss/limit-logic/mode-transition/sim_mode-transition.asc

A1: buf; Vhigh=10, Vlow=-5, Ref=1
V1: voltage; PULSE(-5 10 0 1n 1n 200u 400u)
X1: mode-transition
Named nets: 0, high, low, r_mode_vc, s_mode_vc, r_mode_lclc, s_mode_lclc, r_mode_uclc, s_mode_uclc, r_mode_cc, s_mode_cc, r_mode_lvlc, s_mode_lvlc, r_mode_uvlc, s_mode_uvlc, ~mode, enable_ok
.tran 800u
