pascalguttmann/obat/docs/design/pss/power-electronics/bias/sim_rubber_diode_vbe.asc

I1: current; 24m
X1: rubber_diode; p={p}
Named nets: 0
.step param p 1u 1 0.01
.op
.dc dec I1 1m 100m 100
.param p=0.254
