pascalguttmann/obat/docs/design/pss/power-electronics/bias/sim_current_source_highside.asc

V1: voltage; 10
V2: voltage; 5
V3: voltage; 5
X2: current_source_highside
Named nets: 0
.dc V3 -5 10 0.1
