pascalguttmann/obat/docs/design/pss/power-electronics/bias/sim_current_source_lowside.asc

V1: voltage; 10
V2: voltage; 5
V3: voltage; 5
X2: current_source_lowside
Named nets: 0
.dc V3 -5 10 0.1
