pascalguttmann/obat/docs/design/pss/power-electronics/outstage/outstage.asc

Q1: npn; TIP41C
Q2: pnp; TIP42C
Q3: npn; DI_DNLS350E
Q4: pnp; TIP42C
Q5: npn; TIP41C
Q6: pnp; TIP42C
Q7: npn; DI_DNLS350E
Q8: pnp; TIP42C
Q9: npn; TIP41C
Q10: pnp; TIP42C
Q11: npn; DI_DNLS350E
Q12: pnp; TIP42C
Q13: npn; TIP41C
Q14: pnp; TIP42C
Q15: npn; DI_DNLS350E
Q16: pnp; TIP42C
Q17: npn; TIP41C
Q18: pnp; TIP42C
Q19: npn; DI_DNLS350E
Q20: pnp; TIP42C
Q21: npn; TIP41C
Q22: pnp; TIP42C
Q23: npn; DI_DNLS350E
Q24: pnp; TIP42C
Q25: npn; TIP41C
Q26: pnp; TIP42C
Q27: npn; DI_DNLS350E
Q28: pnp; TIP42C
Q29: npn; TIP41C
Q30: pnp; TIP42C
Q31: npn; DI_DNLS350E
Q32: pnp; TIP42C
Q33: npn; TIP41C
Q34: pnp; TIP42C
Q35: npn; DI_DNLS350E
Q36: pnp; TIP42C
Q37: npn; TIP41C
Q38: pnp; TIP42C
Q39: npn; DI_DNLS350E
Q40: pnp; TIP42C
Q41: npn; TIP41C
Q42: pnp; TIP42C
Q43: npn; DI_DNLS350E
Q44: pnp; TIP42C
Q45: npn; TIP41C
Q46: pnp; TIP42C
Q47: npn; DI_DNLS350E
Q48: pnp; TIP42C
R1: res; {R_E}
R2: res; {R_E}
R3: res; {R_B}
R4: res; {R_B}
R5: res; {R_E}
R6: res; {R_E}
R7: res; {R_B}
R8: res; {R_B}
R9: res; {R_E}
R10: res; {R_E}
R11: res; {R_B}
R12: res; {R_B}
R13: res; {R_E}
R14: res; {R_E}
R15: res; {R_B}
R16: res; {R_B}
R17: res; {R_E}
R18: res; {R_E}
R19: res; {R_B}
R20: res; {R_B}
R21: res; {R_E}
R22: res; {R_E}
R23: res; {R_B}
R24: res; {R_B}
R25: res; {R_E}
R26: res; {R_E}
R27: res; {R_B}
R28: res; {R_B}
R29: res; {R_E}
R30: res; {R_E}
R31: res; {R_B}
R32: res; {R_B}
R33: res; {R_E}
R34: res; {R_E}
R35: res; {R_B}
R36: res; {R_B}
R37: res; {R_E}
R38: res; {R_E}
R39: res; {R_B}
R40: res; {R_B}
R41: res; {R_E}
R42: res; {R_E}
R43: res; {R_B}
R44: res; {R_B}
R45: res; {R_E}
R46: res; {R_E}
R47: res; {R_B}
R48: res; {R_B}
Named nets: V_SUP+, V_SUP-, V_IN+, V_IN-, V_OUT
.inc ../std_bjt.lib
.tran 100n
.param R_E={680m/2} R_B=22
.save
.MODEL DI_DNLS350E  NPN (IS=11.7f NF=1.00 BF=388 VAF=127
+ IKF=2.97 ISE=8.95f NE=2.00 BR=4.00 NR=1.00
+ VAR=20.0 IKR=4.50 RE=23.8m RB=95.3m RC=9.53m
+ XTB=1.5 CJE=341p VJE=1.10 MJE=0.500 CJC=45.4p VJC=0.300
+ MJC=0.300 TF=574p TR=111n EG=1.12 )
.MODEL DI_DPLS350E  PNP (IS=9.40f NF=1.00 BF=382 VAF=127
+ IKF=2.48 ISE=8.14f NE=2.00 BR=4.00 NR=1.00
+ VAR=24.0 IKR=3.75 RE=25.8m RB=0.103 RC=10.3m
+ XTB=1.5 CJE=337p VJE=1.10 MJE=0.500 CJC=76.7p VJC=0.300
+ MJC=0.300 TF=645p TR=122n EG=1.12 )
