pascalguttmann/obat/docs/design/pss/power-electronics/outstage/sim_outstage_quiescentcurrent.asc

I1: current; 0
V1: voltage; 10
V2: voltage; -5
V3: voltage; {V_diff/2}
V4: voltage; {V_diff/2}
V5: voltage; 0
X1: outstage
Named nets: 0, V_SUP+, V_SUP-
.step param V_diff 0 2 0.01
.tran 1
.op
