pascalguttmann/obat/(commit log)

2024-01-01 add mkdocs material theme with markdown extensions
2024-01-01 fix missing requirements for material theme
2024-01-02 add docs index landing page
    Remove old mkdocs getting started page.
2024-01-07 add on off relay to psu
2024-01-07 fix wrong list format in README.md and obat doc landing page
2024-01-07 refine readme and landing page with local contribution hints
2024-01-16 add section for current boosting options of SMU
2024-01-16 fix typos in SMU current boosting section
2024-01-30 remove emergency stop unit from power supply
2024-01-30 add external Temp transducer with 0..5V interface
2024-02-01 esu add minimun break current for relay
2024-02-01 add voltage level note for components
2024-02-01 add control circuit options as open point
2024-03-18 rename ST_A ST_B connector to SELFTEST_A SELFTEST_B
2024-03-18 rename relay to ESU
    relay is implementation specific. This requirement is on a abstract level
2024-03-18 move info box into requirement
    move the infobox specifying the criteria for all voltages in operational interval
    into the requirement
2024-03-18 add thermal fuse requirement to esu
2024-03-18 add esu schematic image
2024-03-18 add esu integration with secondary measurement
    - add secondary U/I transducer as measurement for ESU to make precision measurement
    non-safety relevant,
    - move battery to not be sub-part of obat
2024-03-28 rename power supply unit to power supply sink
2024-03-28 add workspace for enclosure team
    - add workspace file
    - add file to mkdocs config
    - add codeowner entry with dummy account
2024-03-28 add architecture from meeting for enclosure
2024-03-28 add codeowner line for enclosure team in architecture
2024-03-28 add enclosure in system diagram
2024-03-28 add flowchart power and enclosure
2024-03-31 add link to video tutorials on landing page
2024-04-05 add enclosure codeowners
2024-04-06 add powersupplysink outputstage page
2024-04-06 add circuit component structure
2024-04-06 add circuit selection
2024-04-06 add source to thermal resistance table
2024-04-07 add quiescent current to power dissipation upper limit
2024-04-07 add info box for thermal grease and heatsink range
    Link to fischerelektronik catalogues
2024-04-18 Adding info regarding fuse and small comment on voltage.
2024-04-18 Adding some conclusion regarding fuses
2024-04-18 fix description of residual current breaker
2024-04-25 add discussion site for adc of measurement electronics
2024-04-25 Adding info regarding the different ADC collected.
2024-04-30 add full range SPI ADCs
2024-05-01 add spi daisychain adc
2024-05-06 add ballast resistor calculation
2024-05-06 add short circuit protection
2024-05-06 add assembly hints pss
2024-05-07 add part selection power transistor
2024-05-07 add heatsink selection
2024-05-07 add power transistor selection excel for markdown table export
    [power_transistor.xlsx]
2024-05-07 add current limit desing
2024-05-09 add current limit
    - simulation
    - part selection
    - ballast resistor value calculation
2024-05-09 add overview schematic image
2024-05-09 add base resistor search
2024-05-10 add heatsink alternative after quote from fischer elektronik
2024-05-17 change insulator for thermal output stage
2024-05-19 add current source simulations
2024-05-19 add pss/outstage simulation for quiescent current
2024-05-19 add rubber diode vbe multiplier simulation
2024-05-19 add bias circuit simulation
2024-05-20 add bias circuit design page
2024-05-20 add interface and requirements for bias circuit
2024-05-20 add power consumption inteface
2024-05-21 add pss/bias overview, literature, current source
2024-05-21 add pss/bias current boost transistors
2024-05-21 add pss/bias operational point resistor
2024-05-21 add pss/bias rubber diode vbe multiplier
2024-05-21 add rubber diode vbe multiplier image
2024-05-21 add pss/bias supply power demand
2024-05-21 add power electronics subsystem integration
2024-05-21 add pss/power-electronics quiescent current adjustment
2024-05-23 add submodule powersupplysink ecad
2024-05-26 fix current source calculation for emitter resistor
2024-05-26 add thermal voltage info
    thermal voltage is not constant, but has minor effect.
    effect counteracts thermal runaway and can therefore be neglected.
2024-05-26 change rubber diode vbe multiplier trimmer position
    changed position prohibits excess dropoff voltage in case of machanical failure of trimmer
2024-05-26 fix wrong part number of current limiting transistors in outstage
2024-05-26 add temperature simulation for quiescent current
2024-06-17 add modelling simulation for power electronics
    - add 1st order lowpass model of power electronics as laplacian
2024-07-02 fix meas requirements and architecture
    meas was still described according to old state of transducing voltages and currents and not measuring it.
    meas is required to digitize the voltage and current
2024-07-02 add terminals for temperature measurement to meas
2024-07-02 add temperature measurement to name of uit measurement
2024-07-04 Adding Audrino code into ADC file
2024-07-04 Audrino code to ADC/diss
2024-07-04 ADC config code with documentation
2024-07-05 add ptc creo mechanical CAD data
    cad data for enclosure by geng.
    PTC Creo.
    [07210-08.stp, Hinge GN 237.1-30-30-A (0).stp, Toggle latch GN 832.4-55-ST (closed).stp, din_en_iso_4762_m8x35.stp]
2024-09-06 separate controller design (control theory) as subdir of control (electronic circuit design of ct)
2024-09-10 lqr based pid design
2024-09-10 add controller print for debugging
2024-09-10 lqr pid weightings
2024-09-14 add pid controller with rlocus plot for current regulation
2024-09-14 pid second zero faster
2024-09-16 fix pid gain
2024-09-17 make outercircuit omega the standard for conversion of voltage to current
2024-09-17 add extraction of pid params
2024-09-17 add scaling to pid coefficients
2024-09-22 add doc pid controller via root locus
2024-09-22 add doc pid controller parameters
2024-09-22 add doc control circuit
2024-09-22 add doc pid control circuit
2024-09-22 add doc pid control component selection
2024-09-22 add doc pcb layout for opamp and todo
2024-09-24 add pid control opamp component dimensions
2024-09-24 add pid control summing junction component dimension
2024-10-01 fix docs structure
    directories 'arch' and 'workspace' were used as substitutes. Thus the true design structure was concealed.
    [07210-08.stp, Hinge GN 237.1-30-30-A (0).stp, Stückliste.xlsx, Toggle latch GN 832.4-55-ST (closed).stp, Zukaufteile.xlsx, din_en_iso_4762_m8x35.stp, power_transistor.xlsx]
2024-10-01 adapt power electronics headers for new structure
2024-10-04 add limit-logic transition table
    [truth-table-mode-set-reset.xlsx]
2024-10-04 add limit logic transition hints for startup procedure
    [truth-table-mode-set-reset.xlsx]
2024-10-08 fix limit-logic state transition from U to I Mode
    [truth-table-mode-set-reset.xlsx]
2024-10-28 remove control-logic grouping
    Remove grouping to comply with structure of version 0.5.0 of
    powersupplysink
    [truth-table-mode-set-reset.xlsx]
2024-10-28 fix limit-logic directory structure
    [truth-table-mode-set-reset.xlsx]
2024-10-28 add limit-logic circuit description
2024-10-29 add limit-logic pcb layout test point doc
2024-10-29 add limit-logic power consumption
2024-10-29 fix control testcase name
    remove control-logic in path, which was removed to be consistent with
    rev 0.5.0 of pss schematic
2024-10-29 add mode-transition input output spec, power consumption
2024-10-29 add mode-transistion documentation of transition excluded by design for completeness
    [truth-table-mode-set-reset.xlsx]
2024-10-29 add mode-transition circuit description
2024-10-29 add mode-transition circuit implementation doc
2024-10-29 add mode-transition pcb layout hints
2024-10-29 add mode-transition assembly instructions
2024-10-29 add mode-transition test case
2024-11-04 add compare-logic power consumption
2024-11-04 add compare-logic circuit description
2024-11-04 add compare-logic pull up/down, test pin, disconnector
2024-11-05 add compare-logic assembly hints (not applicable)
2024-11-06 add window-comparator power consumption
2024-11-06 add window-comparator circuit description
2024-11-06 fix window-comparator input current specification
2024-11-06 fix limit-logic input current specification
2024-11-06 bump hw/pss schematic version to 0.5.1
2024-11-07 edit compare-logic ltspice simulation symbol pin placement
2024-11-07 fix limit-logic missing state transitions between limiting modi
    The state transition, which transitions from the upper limit control directly to the lower limit control
    and vice versa is introduced in this commit. The simulation revealed that the transition was indeed missing.
    The transition ensures robustness that the correct mode will be active, when e.g. the current rapidly changes
    and the transition to the 'normal' operating mode is skipped/missed.
    [truth-table-mode-set-reset.xlsx]
2024-11-11 add mux power consumption specification
2024-11-11 add mux circuit description
2024-11-12 fix control pid transfer function K_D factor
    factor was computed correctly, but documented transfer function had a wrong usage of K_D, because simulation
    is performed in 0.001s = 1s to avoid numeric computation issues. The correction of this term was not considered
    when copying the transfer function to the documentation. (Altough the correction was considered for the
    computation of K_D.)
2024-11-12 add control component selection anti integral windup diode
2024-11-13 fix control ltspice simulation test of fixed pid control
2024-11-13 fix control pid circuit design
2024-11-13 add control capacitor selection
2024-11-13 fix hw/pss pid implementation
2024-11-13 bump hw/pss schematic version to 0.6.1
2024-11-13 add control rlocus script current sensor system
2024-11-13 add control pid design parameters with current sensor pole
2024-11-14 edit control pid implementation to be consistent with pid params for current sensor pole addition
2024-11-15 add meas circuit description
2024-11-16 add measurement detailed circuit description
2024-11-16 add meas power consumption estimation
2024-11-16 add meas pcb layout hints
2024-11-16 remove meas assembly hints
2024-11-16 bump schematic version to 0.7.0 with measurement sub circuit
2024-11-18 bump hw/pss schematic version to 0.7.1
2024-11-19 add hw/pss schematic version 0.8.0 with relay sub circuit
2024-11-19 add relay ee-component from template
2024-11-19 add relay circuit description
2024-11-19 add relay component selection
2024-11-19 add relay input output power specification
2024-11-19 add relay pcb test pin hints
2024-11-19 add relay test cases
2024-11-19 add relay ltspice simulation
2024-11-19 edit pss overview diagram to match current state of schematic
2024-11-19 add window-comparator feedback from prof spiegelberg, add prototype adjustment options
2024-11-20 edit control feedback from prof spiegelberg, adjust input offset correction resistor
2024-11-25 add controller-design bandwidth limit of pid controller
2024-11-25 add control ltspice simulation for bandwidth limited pid controller
2024-11-25 add hw/pss schematic version 0.8.1 with bandwidth limited pid controller
2024-11-25 add control circuit descriptio of bandwidth limited pid controller
2024-11-25 add hw/pss schematic version 0.8.2 with fix of controller bandwidth limitation
2024-11-27 edit relay invert input logic
2024-11-28 add conf power consumption
2024-11-28 add conf circuit description
2024-11-28 add adc ee-component from template
2024-11-28 add adc output specification
2024-11-28 add adc input specification
2024-11-28 add adc power specification
2024-11-28 add adc circuit description
2024-11-28 add adc component seleciton
2024-11-28 add adc ltspice simulation negativ report
2024-11-28 add adc assembly and pcb layout hints
2024-11-28 add adc test case
2024-11-29 add hw/pss schematic version 0.9.0
2024-11-29 add digital-interface power specification
2024-11-29 add digital-interface circuit description
2024-11-29 add digital-interface pcb hints
2024-11-29 fix power-electronics markdown heading style
2024-11-29 fix power-electronics input output power spec adhere to template
2024-11-29 fix power-electronics circuit description adhere to template
2024-11-29 fix power-electronics ltspice simulation adhere to template
2024-11-29 fix power-electronics pcb hints adhere to template
2024-11-29 add power-electronics testcase
2024-11-29 edit power double check +5V power requirements of sub circuits
2024-11-29 add power ee-component from template
2024-11-29 add power component selection
2024-11-29 add power power-consumption spreadsheet
    [power-consumption.xlsx]
2024-11-30 add power circuit description
2024-12-02 add power ltspice simulation negative report
2024-12-02 add power input output specification
2024-12-02 add power pcb layout hints
2024-12-02 add power testcases
2024-12-02 bump hw/pss schematic version to 0.10.0
2024-12-02 add power power-checker for power_ok signal
2024-12-02 add leds as visual indicators of internal state
2024-12-03 add esd TSV diodes and fuses
2024-12-04 add bias ltspice simulation with varying supply voltage
2024-12-04 add hw/pss schematic version 0.13.1
2024-12-04 add pss power supply specification
2024-12-05 add pss circuit description
2024-12-05 fix controller maximum K_P for short circuit current stability
2024-12-05 bump hw/pss schematic version to 0.13.2
2024-12-06 add pcb layout standard sizes
2024-12-07 bump hw/pss schematic version to 0.13.3
2024-12-07 add hw/pss pcb design rules and default sizes
2024-12-07 add note for hierarchical pcb plugin for kicad 8
2024-12-14 edit pss adapt instructions for solderbridge connection to schematic rev 1.0.0
2024-12-14 update hw/pss heatsink model
2024-12-16 add datasheet and drivers for CH341 usb-to-spi bridge
2024-12-16 add pc ch341 driver install instructions
2024-12-18 add sw/pc submodule for spi driver
2024-12-19 add ch341 python spi driver wrapper 1.0.0-rc1
2024-12-20 bump sw/pc/obat-pc-spi-driver version to 1.0.0
2024-12-20 remove ch341 driver doc because its included in sw/pc/obat-pc-spi-driver version 1.0.0
2024-12-30 add obat-pc-spi-driver version 2.0.0
2024-12-30 rename submodule obat-pc-spi-driver to obat_pc_spi_driver
2025-01-31 add instance_1 power test results
2025-01-31 add enhancement todo for digital-interface and power to reduce noise
2025-02-02 add submodule sw/pc/arduino_usb_spi_bridge
2025-02-06 add sw/pc/arduino_usb_spi_bridge obat specific release for 100kHz clock update
2025-02-06 add instance_1 adc test results
2025-02-06 add instance_1 relay test results
2025-02-07 add instance_1 pss version of schematic and board layout used
2025-02-07 fix commissioning order mux must be powered for limit-logic tests
2025-02-07 add instance_1 power-electronics test results
2025-02-07 add todo hint for wrong wiring for conf_ok check
2025-02-07 add conf warning enameled wire fix of layout
2025-02-19 move mechanical enclosure documentation into sub directory
    [07210-08.stp, Hinge GN 237.1-30-30-A (0).stp, Stückliste.xlsx, Toggle latch GN 832.4-55-ST (closed).stp, Zukaufteile.xlsx, din_en_iso_4762_m8x35.stp]
2025-02-19 add enclosure documentation skeleton
2025-02-19 add info for used heating/cooling elements and fan as specified by WING faculty team
2025-02-19 add enclosure input output power spec
2025-02-19 fix enclosure mechanical naming
2025-02-19 add enclosure circuit description and block diagram
2025-02-19 add hw/enclosure submodule
2025-02-20 add enclosure digital-interface load resistor
2025-02-20 edit enclosure digital-interface add esd protection resistor
2025-02-20 edit enclosure/digital-interface isolation test for 1M Ohm esd resistor
2025-02-20 bump hw/enclosure schematic version to 0.1.0
2025-02-20 add enclosure dac docuementation
2025-02-20 add enclosure dac rise time limitation for signal integrity
2025-02-20 add enclosure pwm component
2025-02-20 add enclosure pwm input output spec
2025-02-20 add enclosure pwm circuit description
2025-02-20 add enclosure pwm test cases
2025-02-20 bump hw/enclosure schematic version to 0.3.0
2025-02-20 add enclosure schematic version 1.0.0
2025-02-21 add enclosure full bridge doc skeletorn
2025-02-21 add enclosure full-bridge doc page
2025-02-21 add enclosure power doc
2025-02-21 add enclosure increased output capacitance
2025-02-21 add enclosure missing doc
2025-02-21 add enclosure dac channel map
2025-02-21 add template obat.kicad_pcb pcb with mounting holes and edge cuts
    [obat.kicad_pcb]
2025-02-22 add hw/enclosure sch-1.1.2_brd-1.0.0
2025-02-22 add missing ibom to hw/enclosure
2025-02-22 add esu current transducer hint
2025-02-22 fix obat.kicad_pcb eurocard pcb template: duplicate mounting hole
    [obat.kicad_pcb]
2025-02-23 add meas adc doc
2025-02-23 add meas power doc
2025-03-06 fix fuse part number in bom
2025-03-06 add instance_1 accuracy measurement data
    [accurracy_measurement.xlsx]
2025-03-06 add instance_1 meas power test results
2025-03-06 fix hw/meas netlist error gnd plane not connected
2025-03-06 adapt instance_1 power current sharing resistor
2025-03-08 add hw/meas schematic version 2.1.0
2025-03-08 bump sw/pc/obat_pc_spi version to 3.3.0, measurement device implementation
2025-03-08 add enclosure test cases for peltier and heater
2025-03-08 fix enclosure pwm test case identifier
2025-03-08 add instance_1 enclosure template for test results
2025-03-08 add instance_1 enclosure power test results
2025-03-08 add instance_1 enclosure dac test results
2025-03-08 add instance_1 enclosure pwm test results
2025-03-08 add instance_1 enclosure full-bridge test results
2025-03-09 add instance_1 enclosure test results
2025-03-09 add instace_1 enclosure mechanical heating/cooling
2025-03-09 add enclosure scripts
2025-03-09 fix temperature symbol in latex
