pascalguttmann/obat/(notices)

Notices in the files:
docs/design/enclosure/mechanical/mcad_ptc-creo/Toggle latch GN 832.4-55-ST (closed).stp:
author */ ('License CC BY-ND 4.0'),
